metinoxy/VTOL/Images/Print Orientations/Wing_L_P1.png

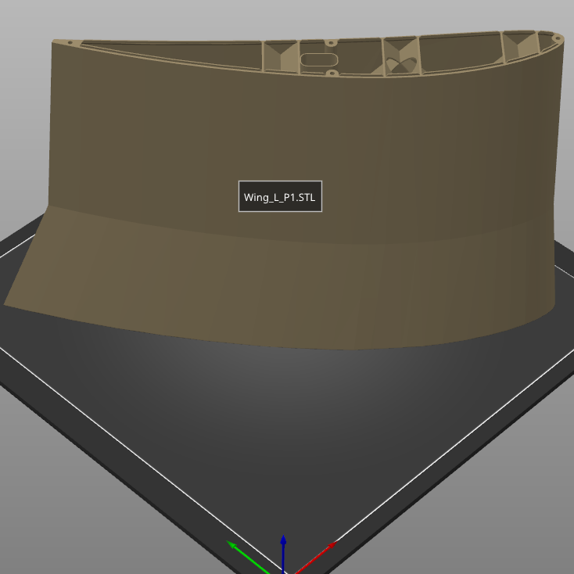
Images/Print Orientations/Wing_L_P1.png
