metinoxy/VTOL/Images/Electronics/FlightController.png

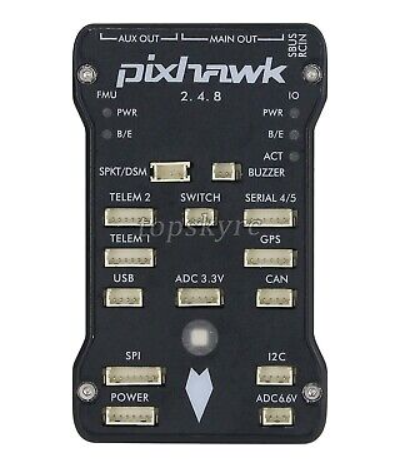
Images/Electronics/FlightController.png
