metinoxy/VTOL/Course Materials/Gantt Chard_Design.xlsx

VTOL Aircraft
Designing a vertical take-off and landing aircraft process |  |  | Period Highlight: |  | 15 |  | Plan Duration |  |  | Actual Start |  |  | % Complete |  |  | Actual |  | % Complete (beyondplan)
ACTIVITIES | PLAN START | PLAN DURATION | ACTUAL START | ACTUAL DURATION | PERCENT COMPLETE | PERIODS
 |  |  |  |  |  | 1 | 2 | 3 | 4 | 5 | 6 | 7 | 8 | 9 | 10 | 11 | 12 | 13 | 14 | 15
Market and Literature Reasearch | 1 | 4 | 1 | 4 | 100%
Problem definition and Functional Requirements | 4 | 2 | 4 | 2 | 100%
Conceptual Design Research | 5 | 1 | 5 | 1 | 100%
Airfoil Selection | 6 | 1 | 6 | 2 | 100%
Concept Evaluation and Selection | 6 | 1 | 6 | 1 | 100%
Wing Design and Lift Analysis | 7 | 2 | 7 | 2 | 100%
Tail Design and Stability Analysis | 8 | 1 | 8 | 1 | 100%
Rough Fuselage Design and CFD Analysis for Drag | 9 | 3 | 9 | 3 | 100%
Motor and Propeller Selection | 10 | 2 | 10 | 3 | 100%
Designation of Motor Positions | 11 | 1 | 11 | 1 | 100%
Wing Stress Analysis | 11 | 2 | 11 | 2 | 100%
Tilt Mechanism Design | 12 | 1 | 12 | 2 | 100%
Material Selection | 13 | 1 | 13 | 1 | 100%
Detailed Design | 13 | 3 | 13 | 3 | 100%
