metinoxy/VTOL/Course Materials/Images/Concept1.png

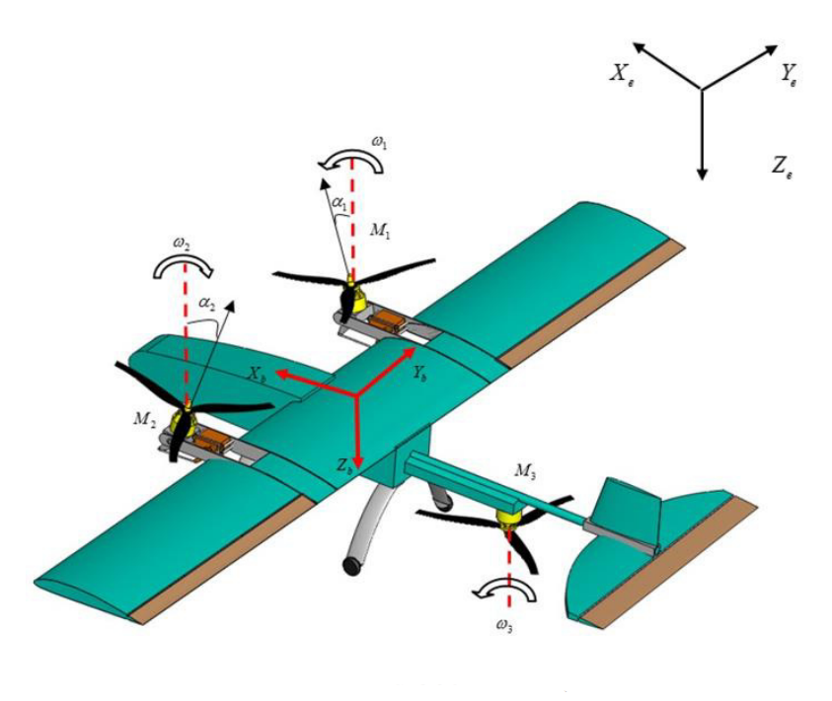
Course Materials/Images/Concept1.png
