metinoxy/VTOL/Course Materials/Images/Concept2.png

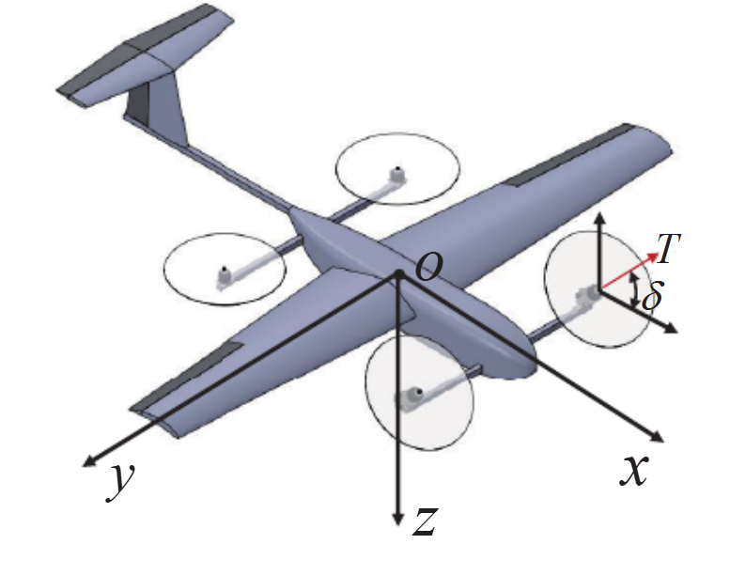
Course Materials/Images/Concept2.png
