metinoxy/VTOL/Course Materials/Images/Concept3.png

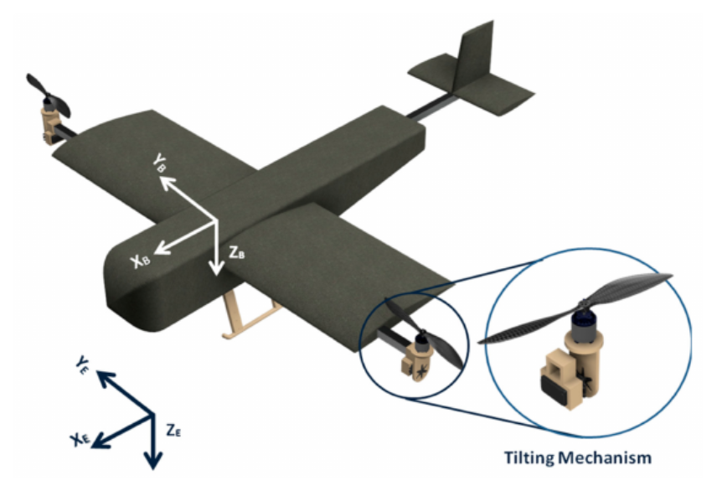
Course Materials/Images/Concept3.png
