metinoxy/VTOL/Course Materials/Images/Design_Path.png

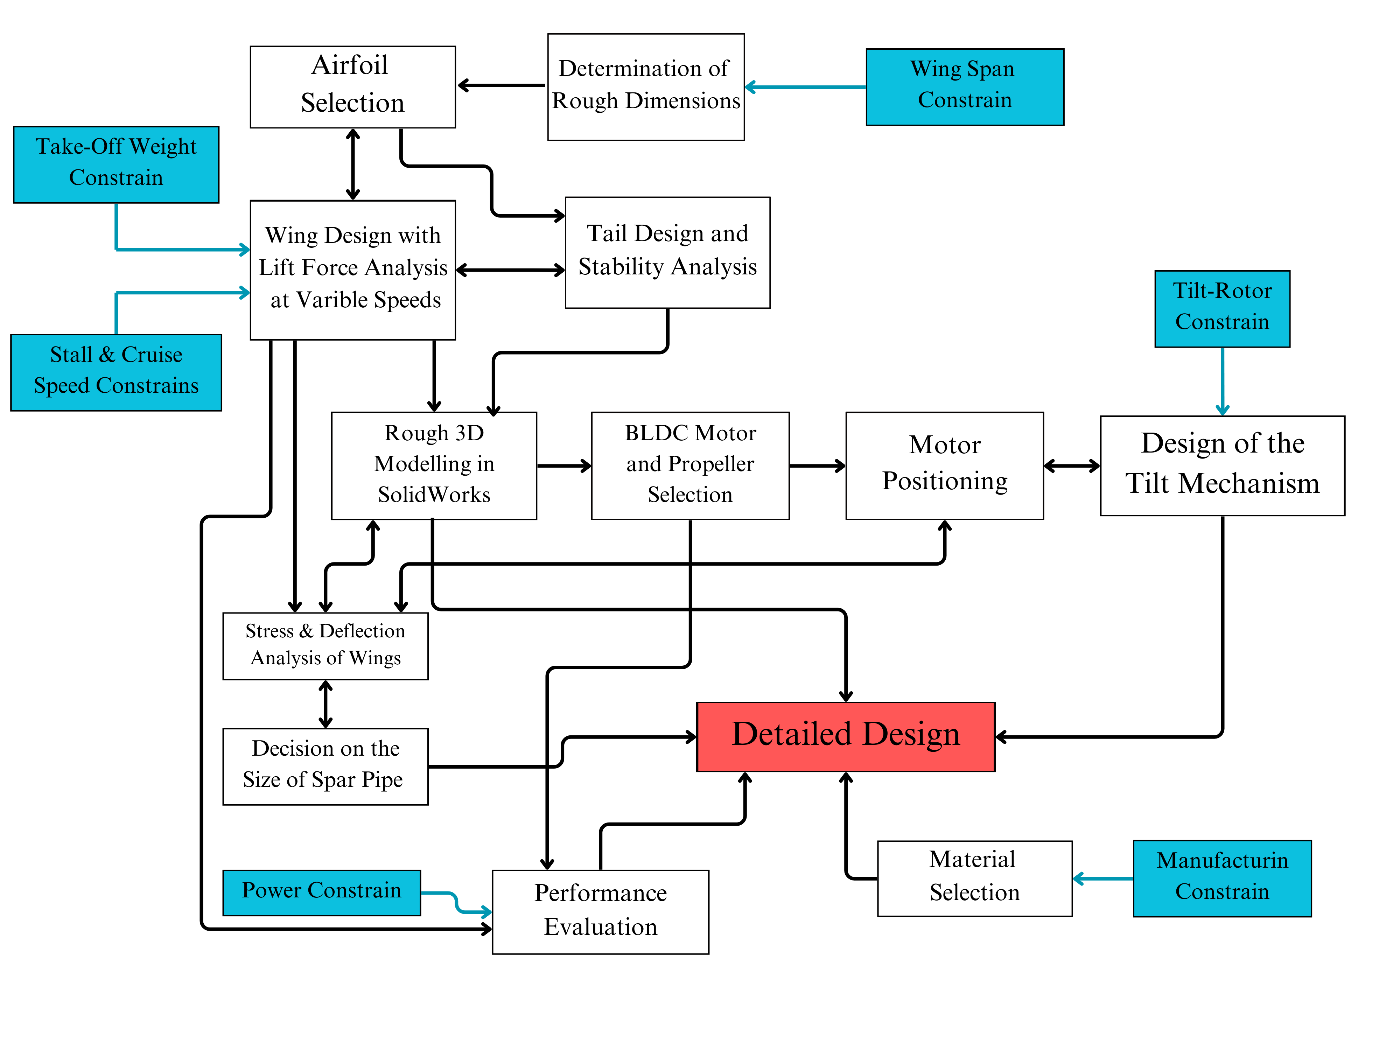
Course Materials/Images/Design_Path.png
