metinoxy/VTOL/Course Materials/Images/ProductDesignSpecifications.png

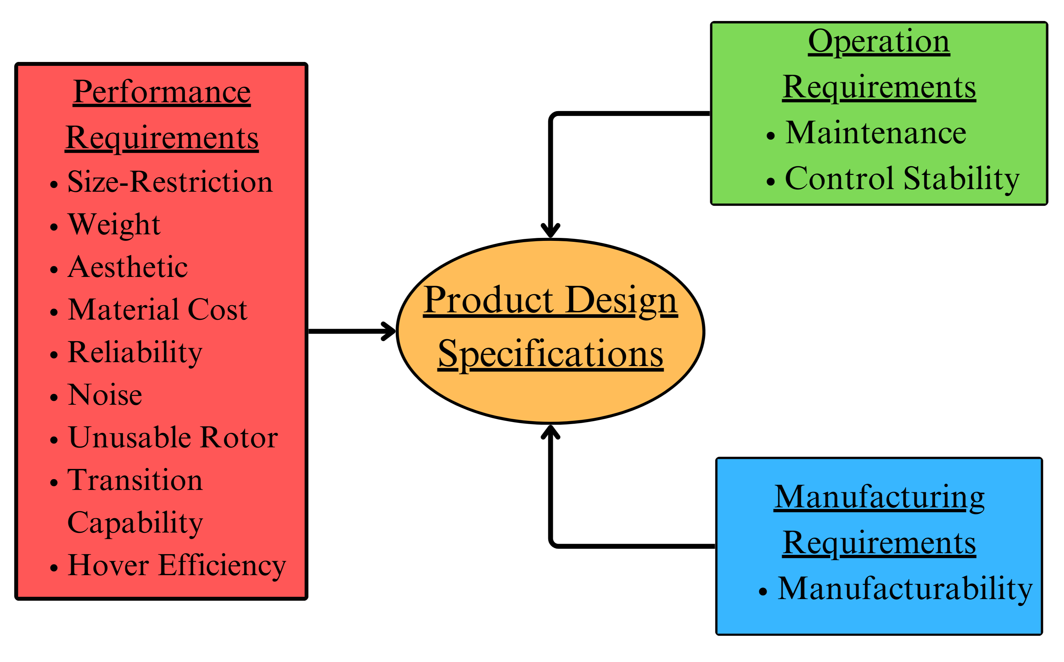
Course Materials/Images/ProductDesignSpecifications.png
