metinoxy/VTOL/Images/clcdVa_cdVa.png

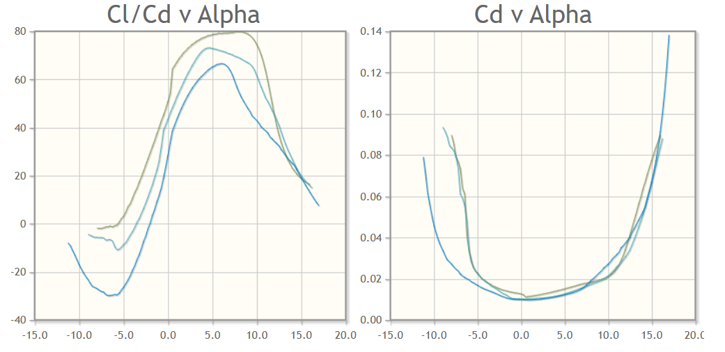
Images/clcdVa_cdVa.png
