metinoxy/VTOL/Images/clVcd_cl_a.png

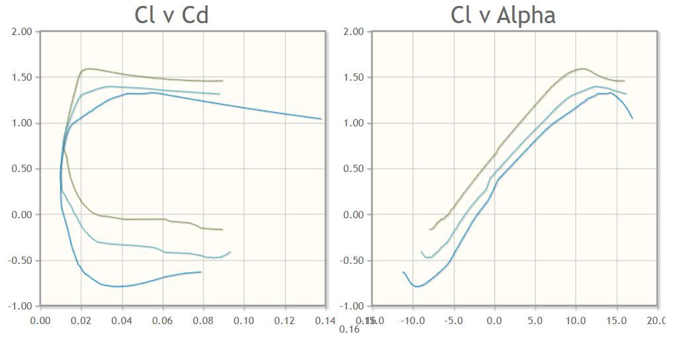
Images/clVcd_cl_a.png
