metinoxy/VTOL/Images/cmVa.png

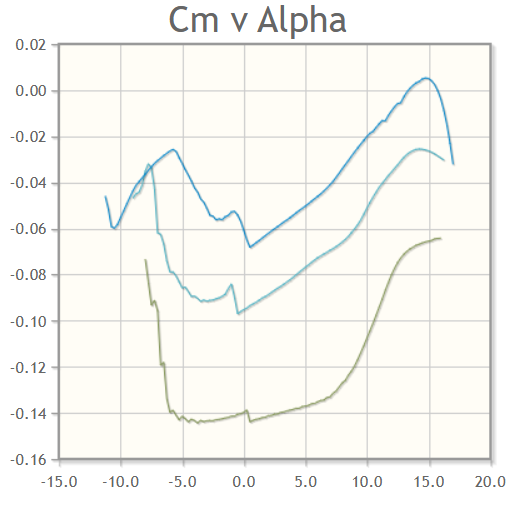
Images/cmVa.png
