metinoxy/VTOL/Images/Electronics/5V_BEC.png

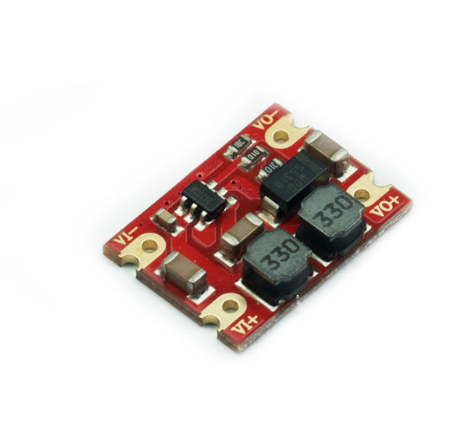
Images/Electronics/5V_BEC.png
