metinoxy/VTOL/Images/Electronics/60A_ESC.png

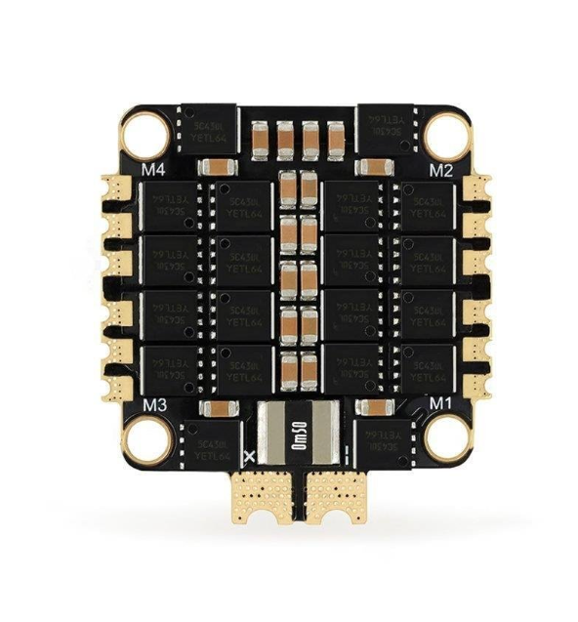
Images/Electronics/60A_ESC.png
