metinoxy/VTOL/Images/Electronics/AirspeedSensor.png

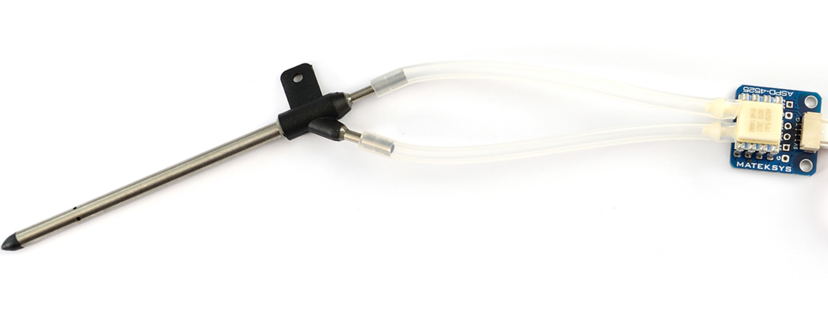
Images/Electronics/AirspeedSensor.png
