metinoxy/VTOL/Images/Electronics/BLDC_RS2205.png

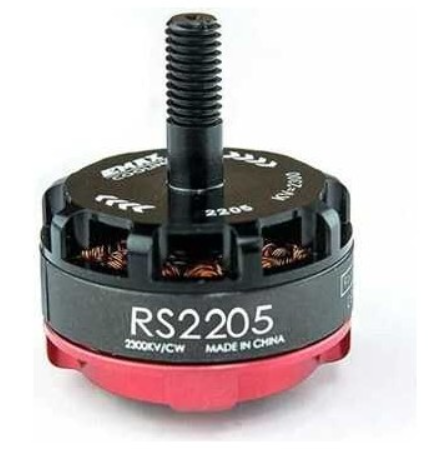
Images/Electronics/BLDC_RS2205.png
