metinoxy/VTOL/Images/Electronics/Buzzer.png

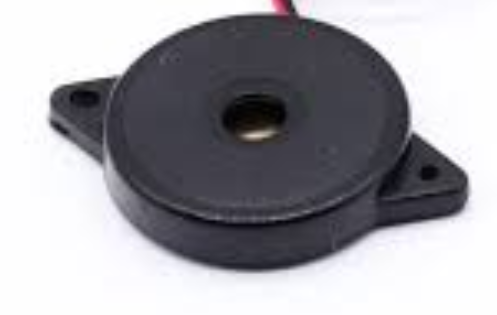
Images/Electronics/Buzzer.png
