metinoxy/VTOL/Images/Electronics/ES09MD_Servo.png

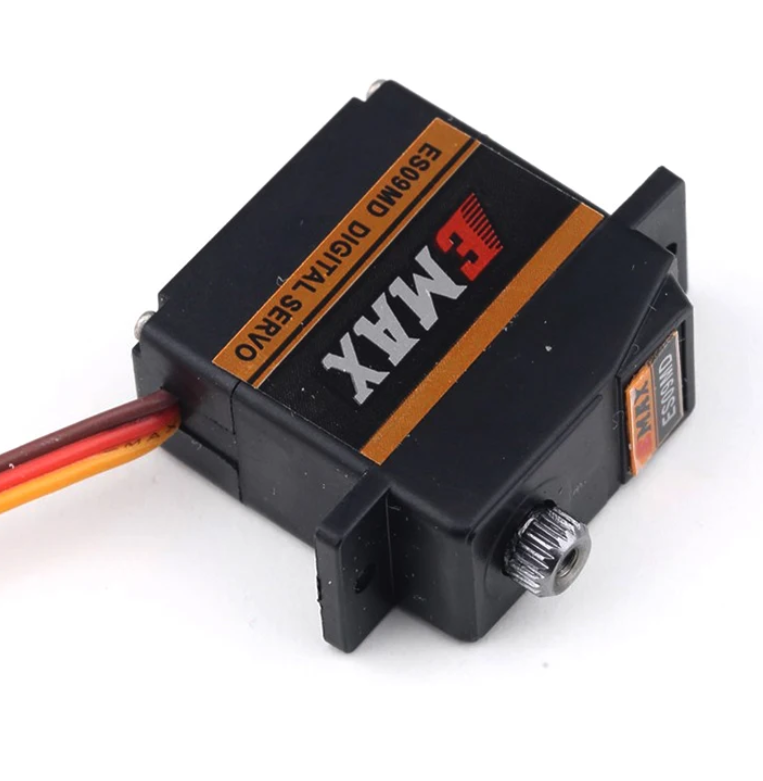
Images/Electronics/ES09MD_Servo.png
