metinoxy/VTOL/Images/Electronics/LİPO.png

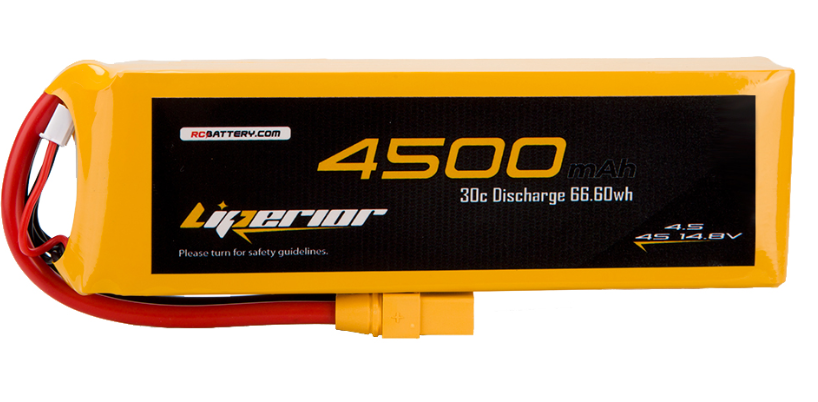
Images/Electronics/LİPO.png
