metinoxy/VTOL/Images/Electronics/M8N_GPS.png

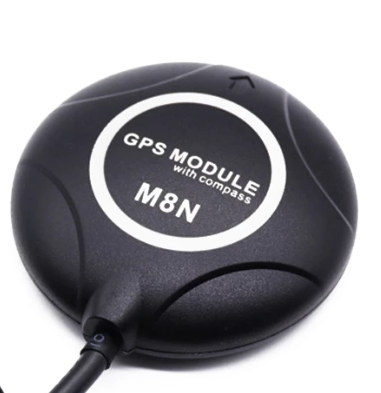
Images/Electronics/M8N_GPS.png
