metinoxy/VTOL/Images/Electronics/MG90S_Servo.png

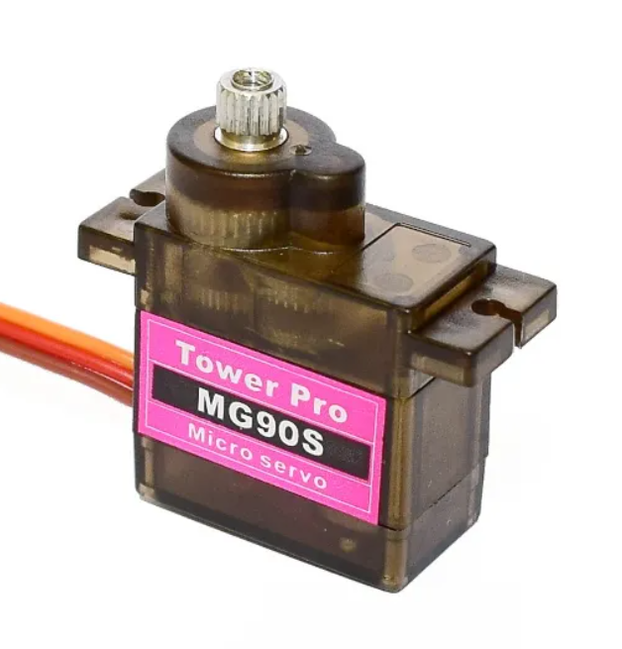
Images/Electronics/MG90S_Servo.png
