metinoxy/VTOL/Images/Electronics/PowerModule.png

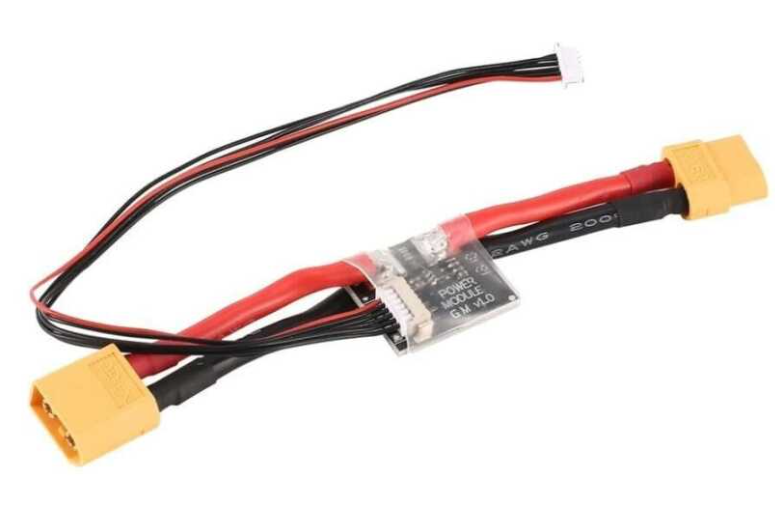
Images/Electronics/PowerModule.png
