metinoxy/VTOL/Images/Electronics/Receiver.png

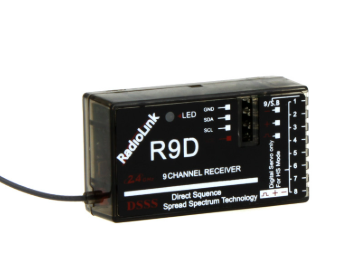
Images/Electronics/Receiver.png
