metinoxy/VTOL/Images/Electronics/SafetySwitch.png

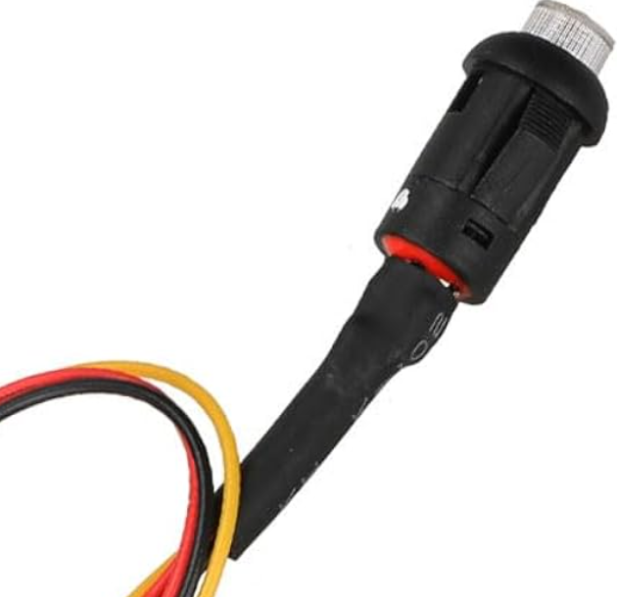
Images/Electronics/SafetySwitch.png
