metinoxy/VTOL/Images/Electronics/Telemetry.png

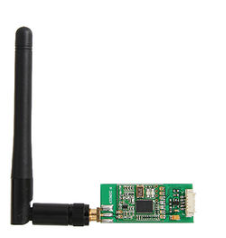
Images/Electronics/Telemetry.png
