metinoxy/VTOL/Images/Ender3-S1.png

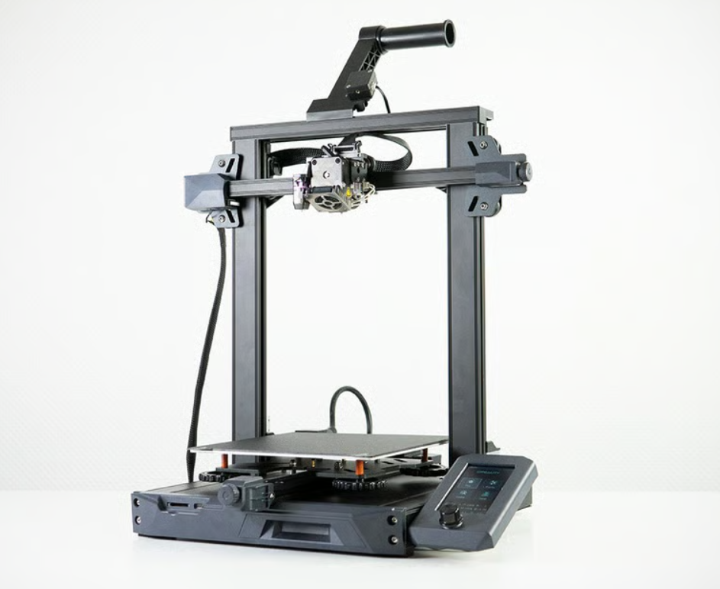
Images/Ender3-S1.png
