metinoxy/VTOL/Images/FFF-1-00000.png

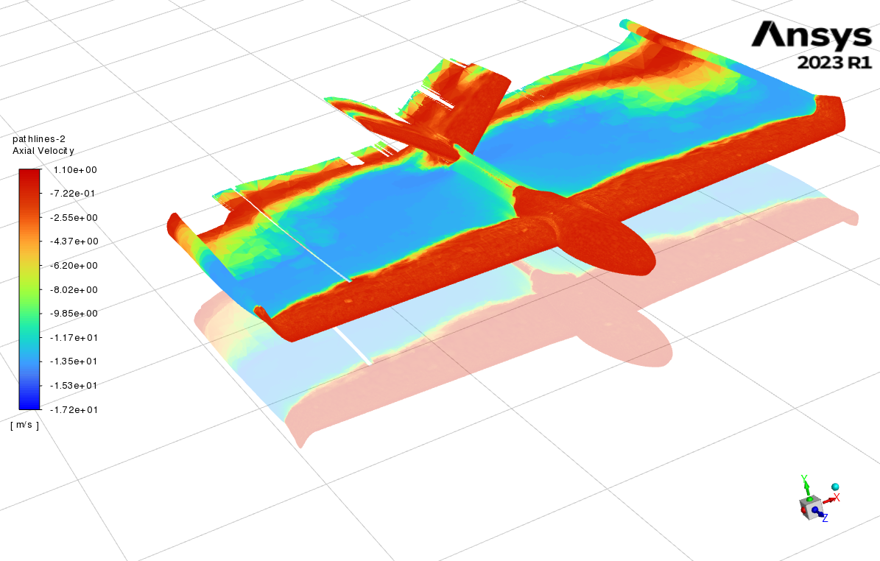
Images/FFF-1-00000.png
