metinoxy/VTOL/Images/FoS_Horizontal.png

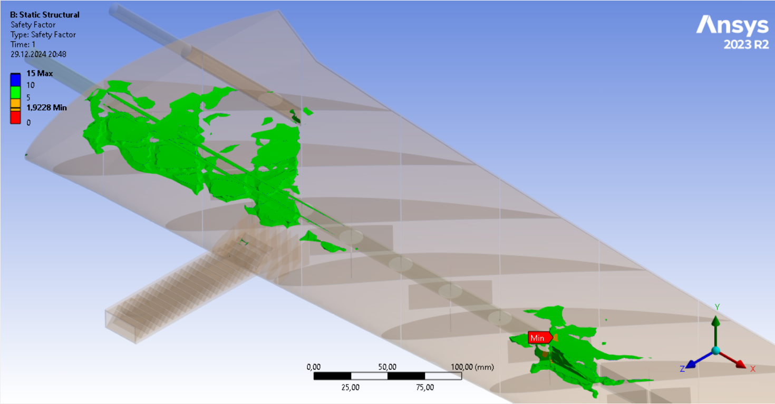
Images/FoS_Horizontal.png
