metinoxy/VTOL/Images/FoS_Vertical.png

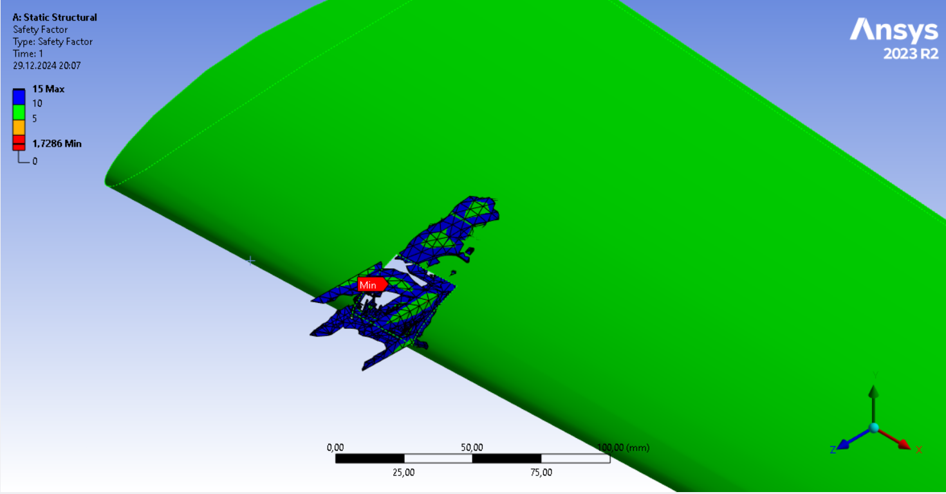
Images/FoS_Vertical.png
