metinoxy/VTOL/Images/Front.png

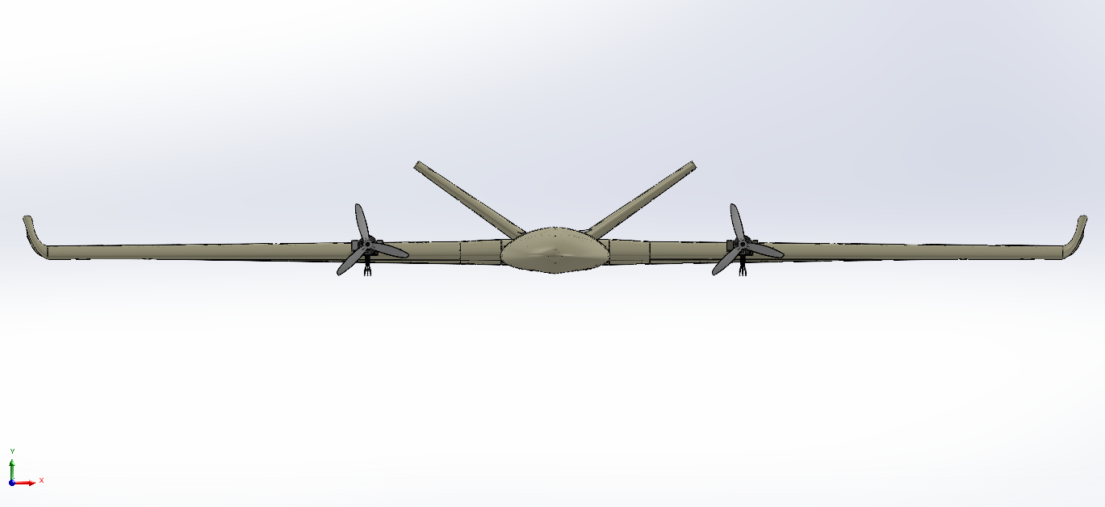
Images/Front.png
