metinoxy/VTOL/Images/izometric1.png

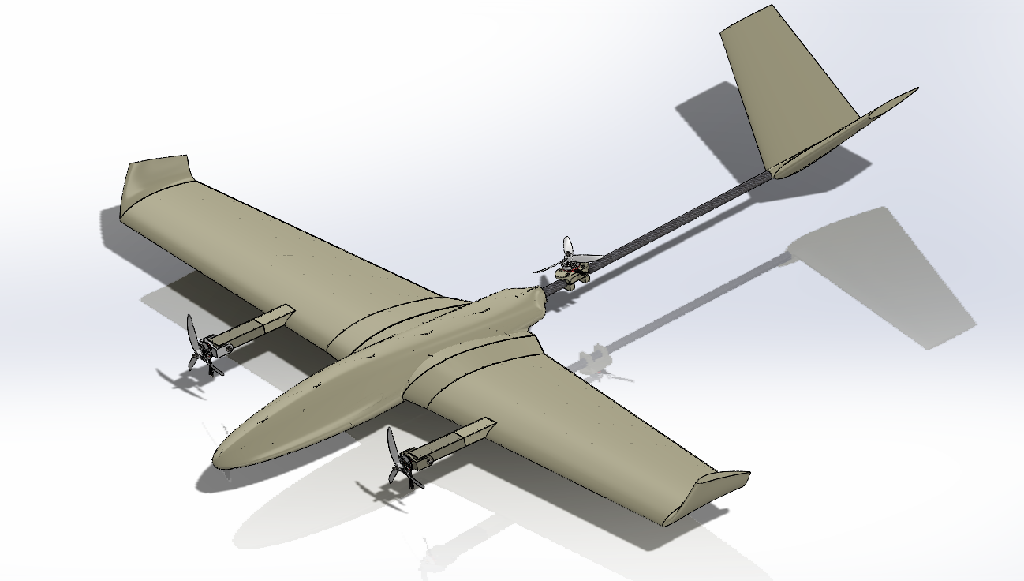
Images/izometric1.png
