metinoxy/VTOL/Images/Izometric.png

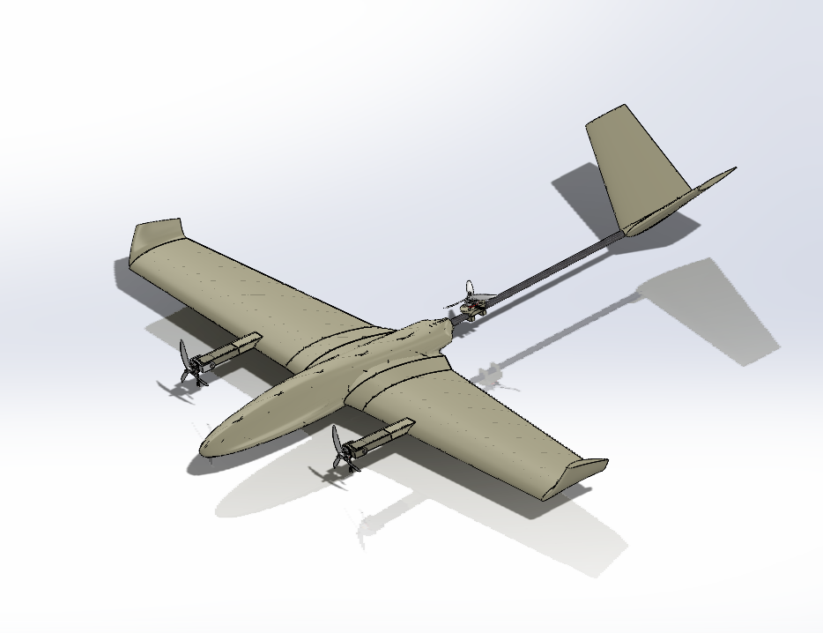
Images/Izometric.png
