metinoxy/VTOL/Images/MP_FullParameterList.png

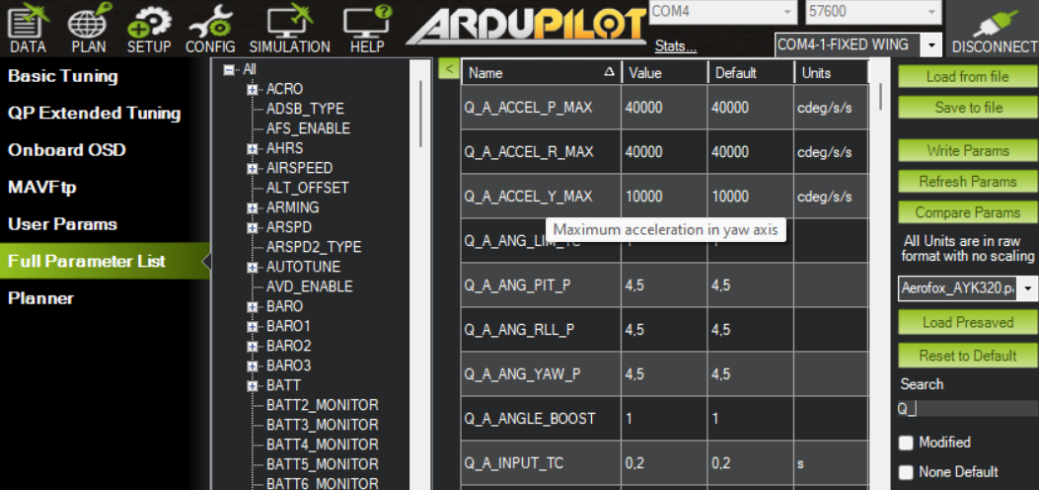
Images/MP_FullParameterList.png
