metinoxy/VTOL/Images/MP_ServoOutput.png

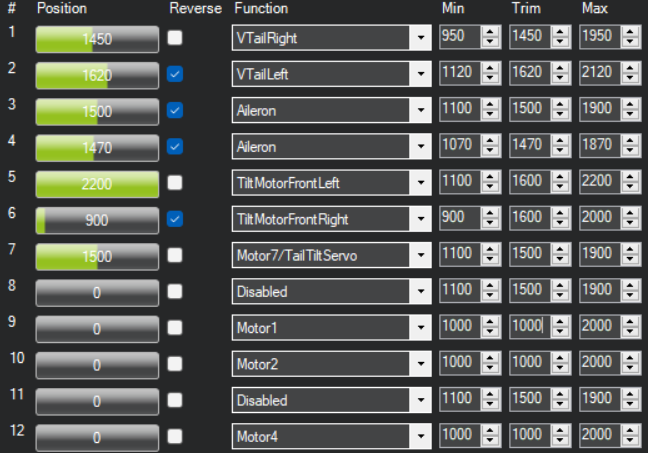
Images/MP_ServoOutput.png
