metinoxy/VTOL/Images/PrushaSlicer.png

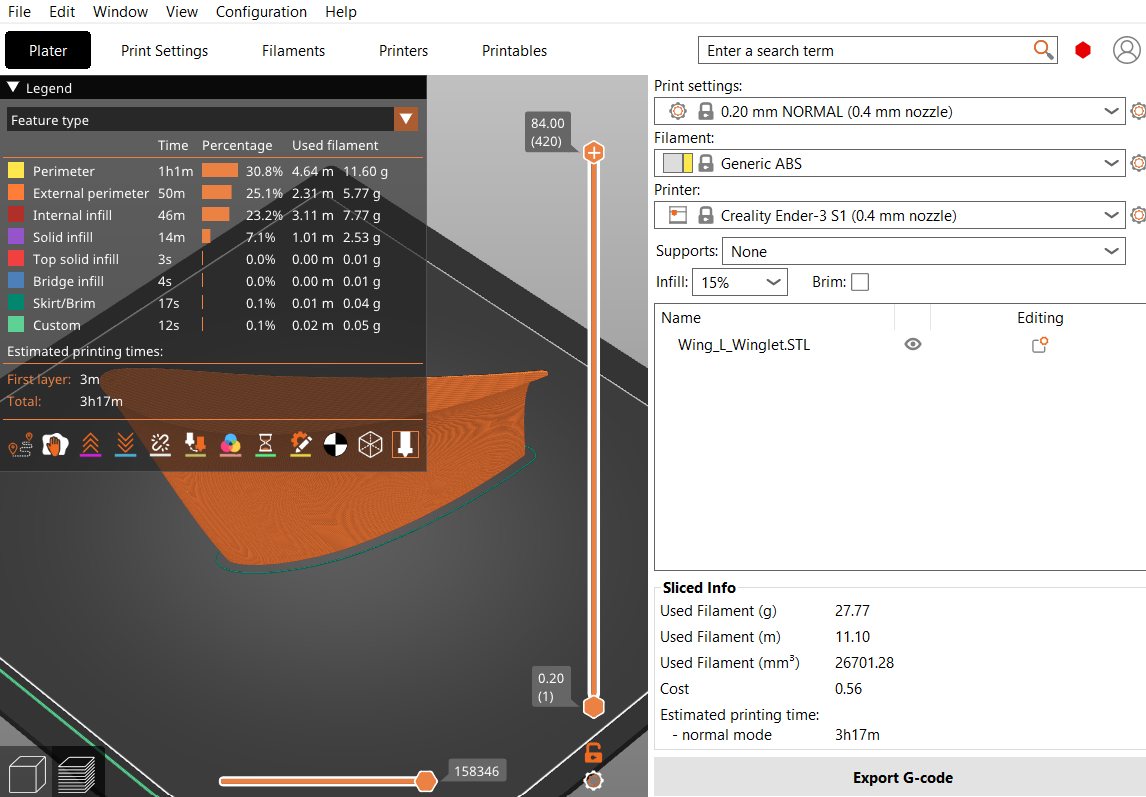
Images/PrushaSlicer.png
