metinoxy/VTOL/Images/servo_cap.JPG

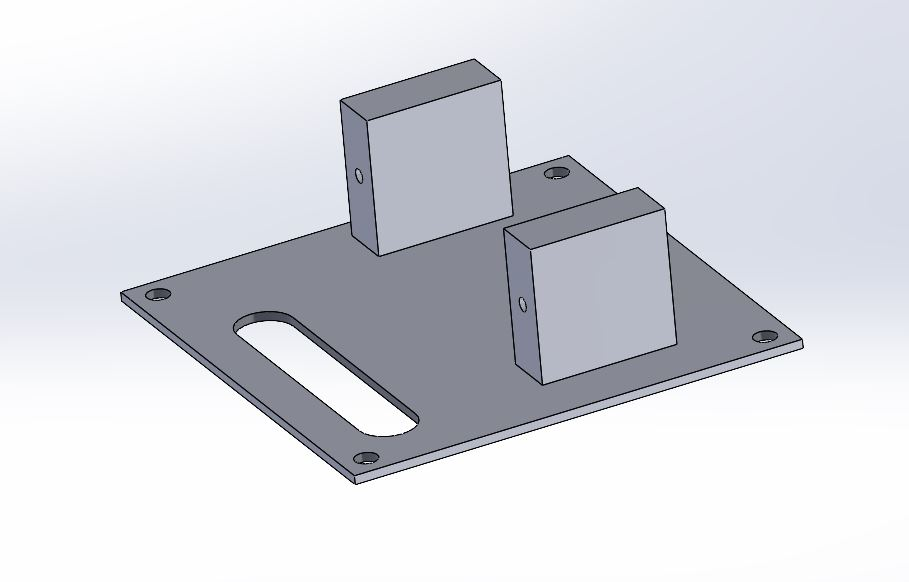
Images/servo_cap.JPG
