metinoxy/VTOL/Images/SnapJoint&Alignment.png

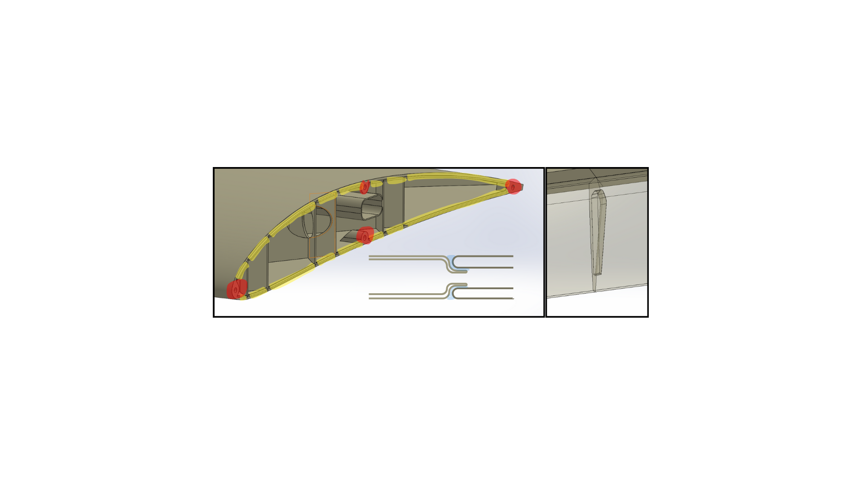
Images/SnapJoint&Alignment.png
