metinoxy/VTOL/Images/SnapJoint&AlignmentHoles.png

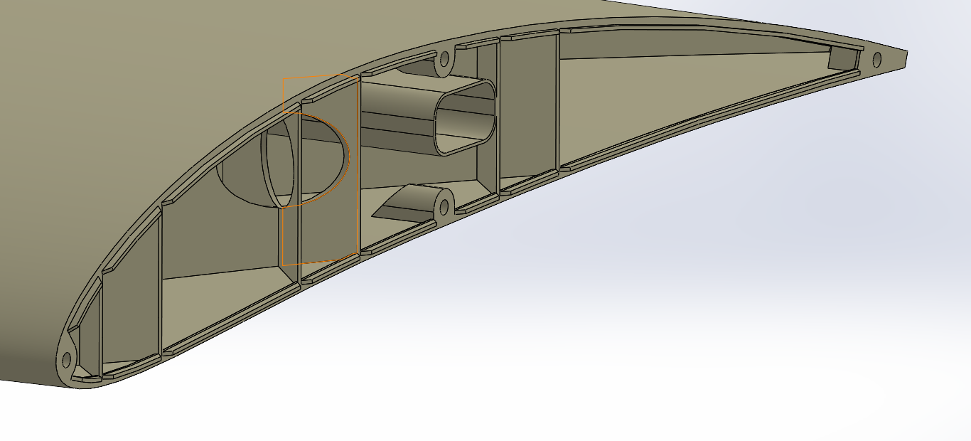
Images/SnapJoint&AlignmentHoles.png
