metinoxy/VTOL/Images/SnapJointAileron.png

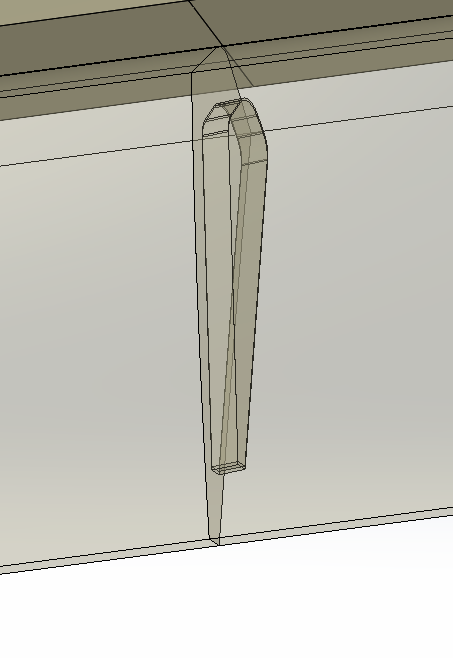
Images/SnapJointAileron.png
