metinoxy/VTOL/Images/tail_pin_holes.JPG

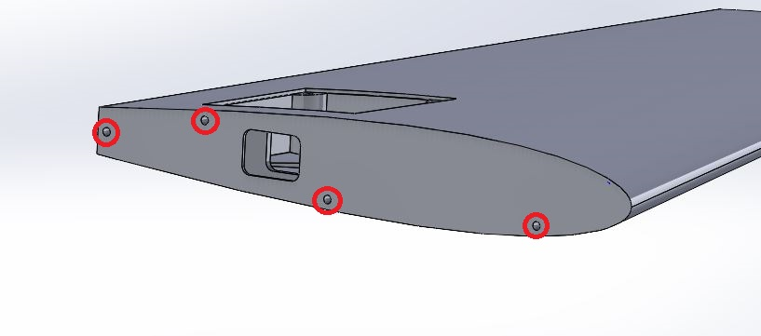
Images/tail_pin_holes.JPG
