metinoxy/VTOL/Images/Tilt_mechanism_exploded.JPG

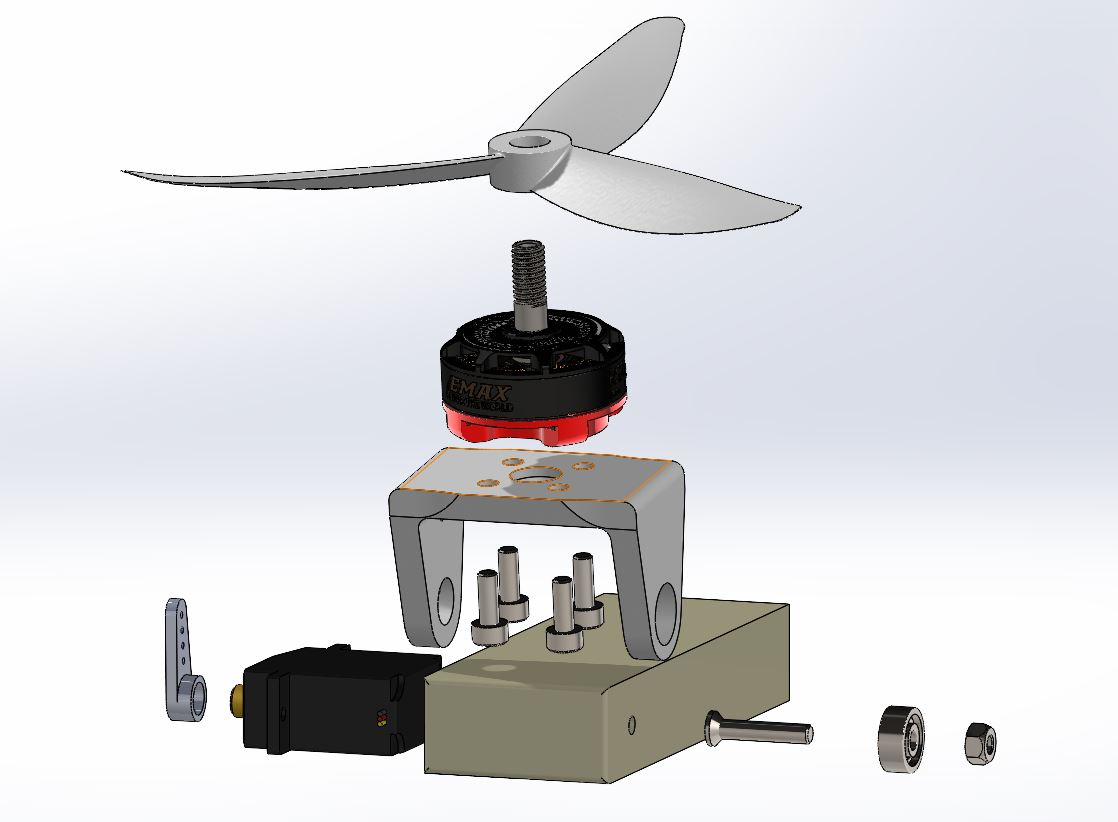
Images/Tilt_mechanism_exploded.JPG
