metinoxy/VTOL/Images/Upward.png

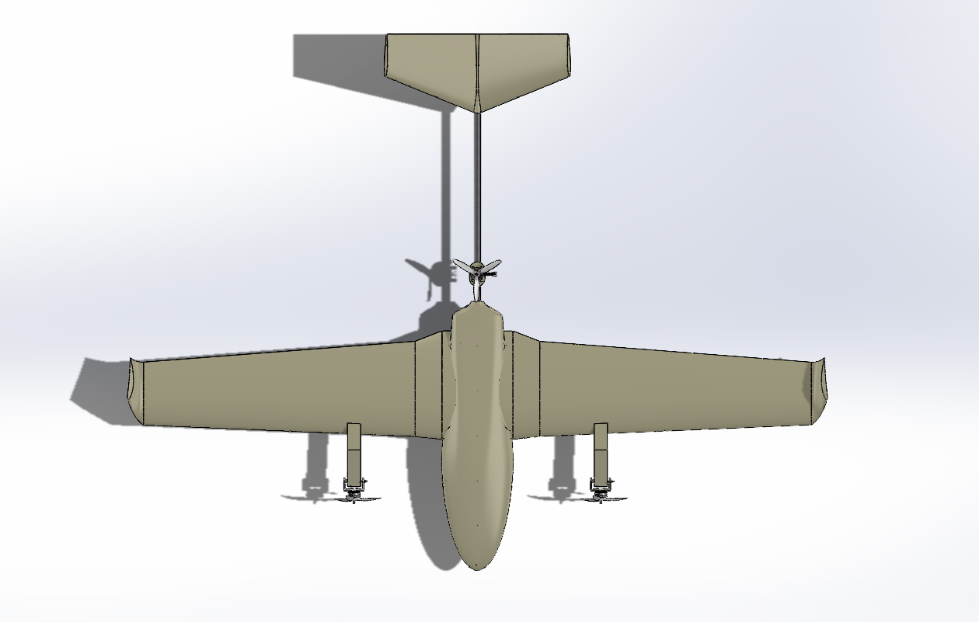
Images/Upward.png
