metinoxy/VTOL/Images/WingP1_Slicer.png

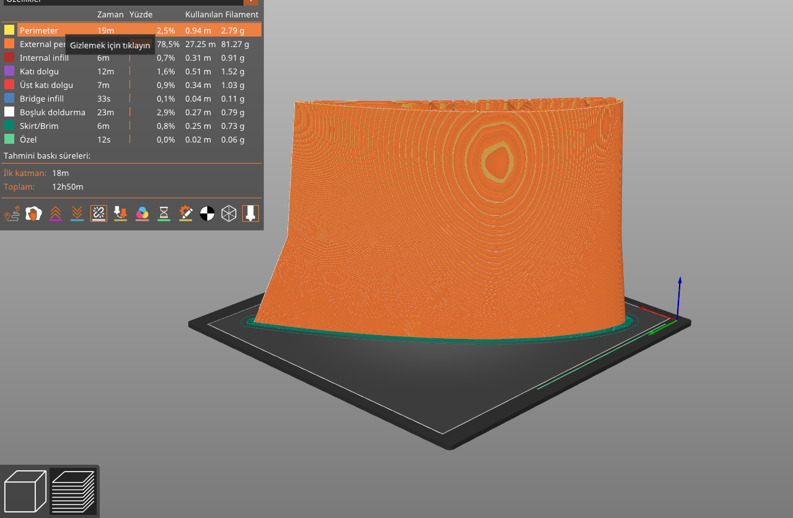
Images/WingP1_Slicer.png
