metinoxy/VTOL/Images/WingServoMount.png

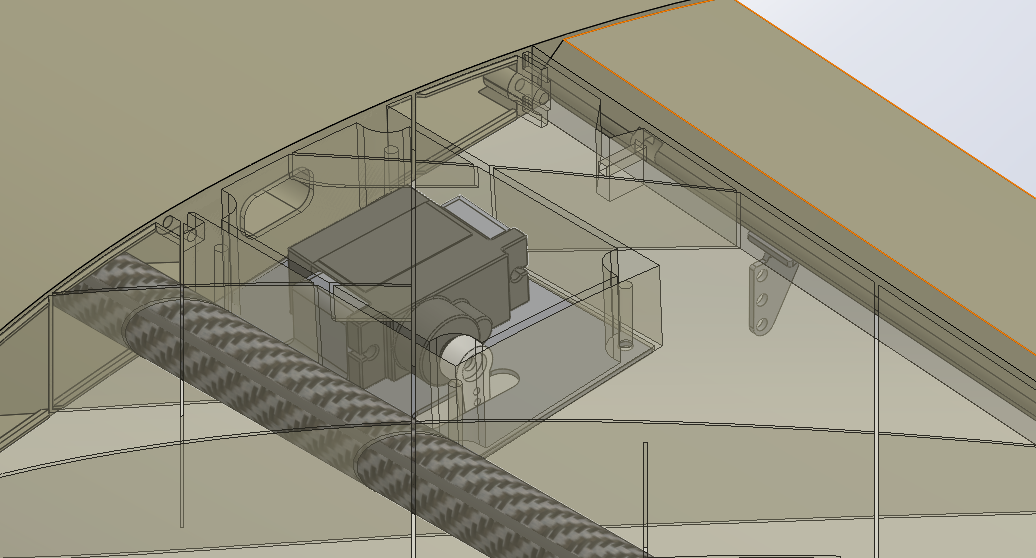
Images/WingServoMount.png
