metinoxy/VTOL/MATLAB/Numerical_Bending.jpg

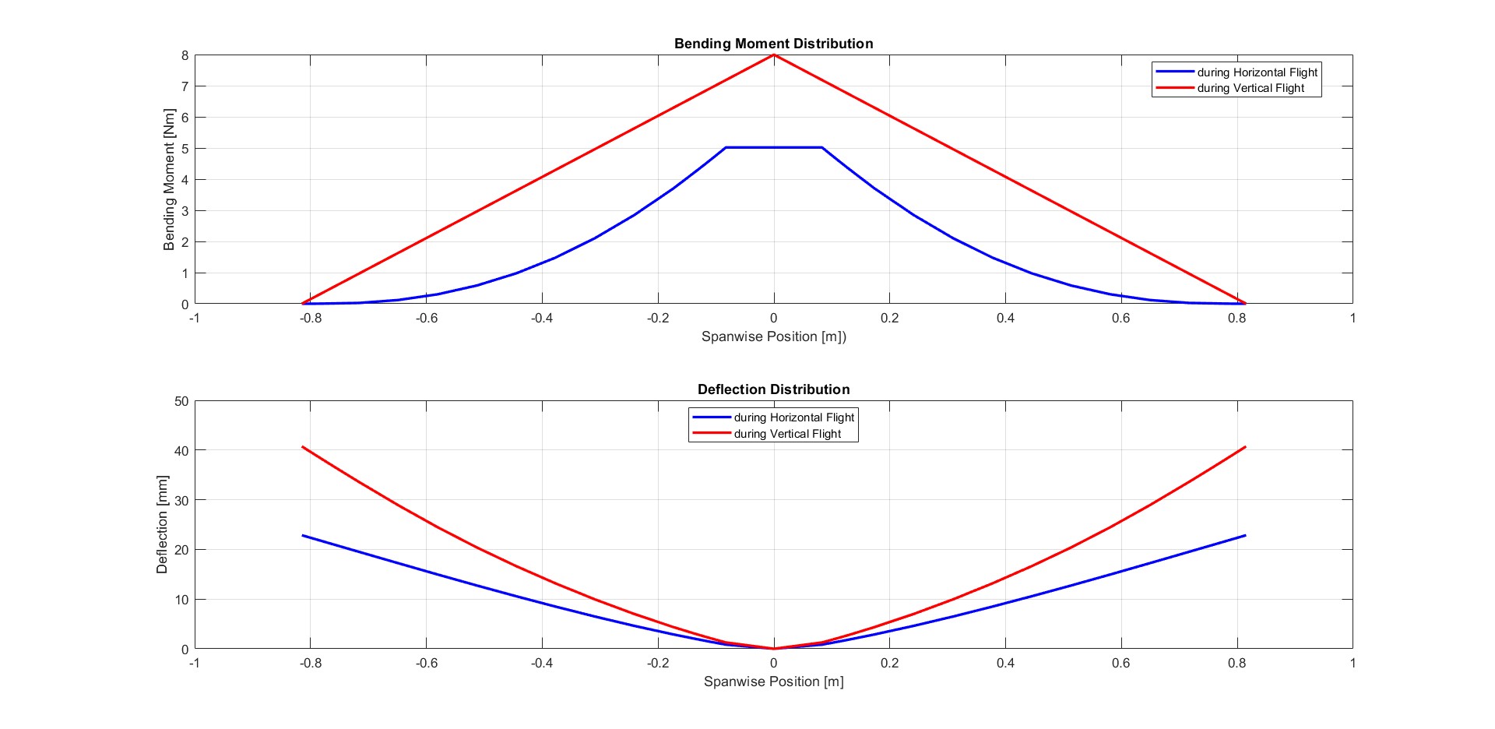
MATLAB/Numerical_Bending.jpg
