metinoxy/VTOL/Production Images/WhatsApp Görsel 2025-03-21 saat 00.48.26_49d39781.jpg

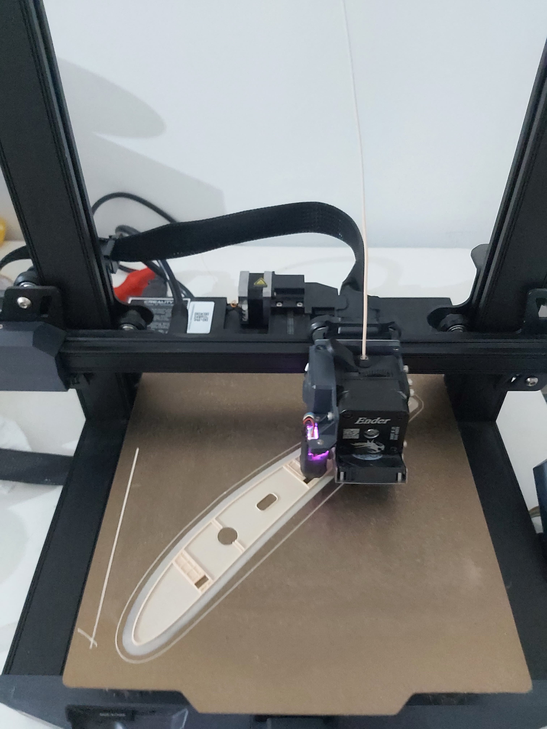
Production Images/WhatsApp Görsel 2025-03-21 saat 00.48.26_49d39781.jpg
