metinoxy/VTOL/Production Images/WhatsApp Görsel 2025-03-21 saat 00.48.27_048fbbfe.jpg

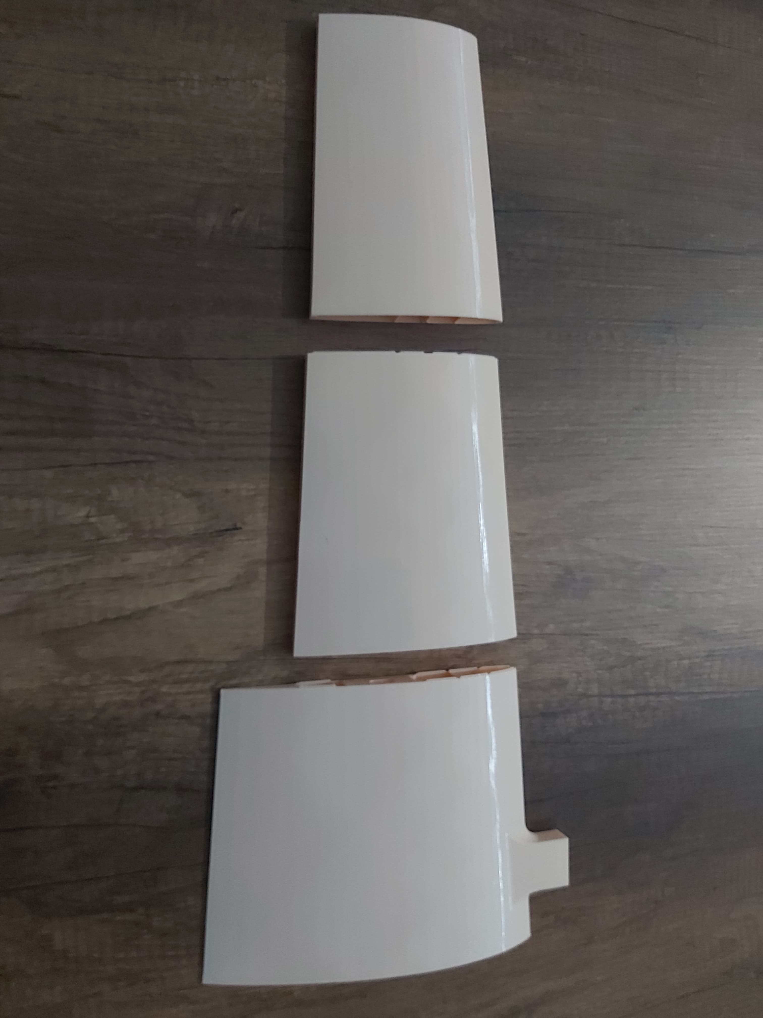
Production Images/WhatsApp Görsel 2025-03-21 saat 00.48.27_048fbbfe.jpg
