metinoxy/VTOL/Production Images/WhatsApp Görsel 2025-03-22 saat 12.00.09_72ee4169.jpg

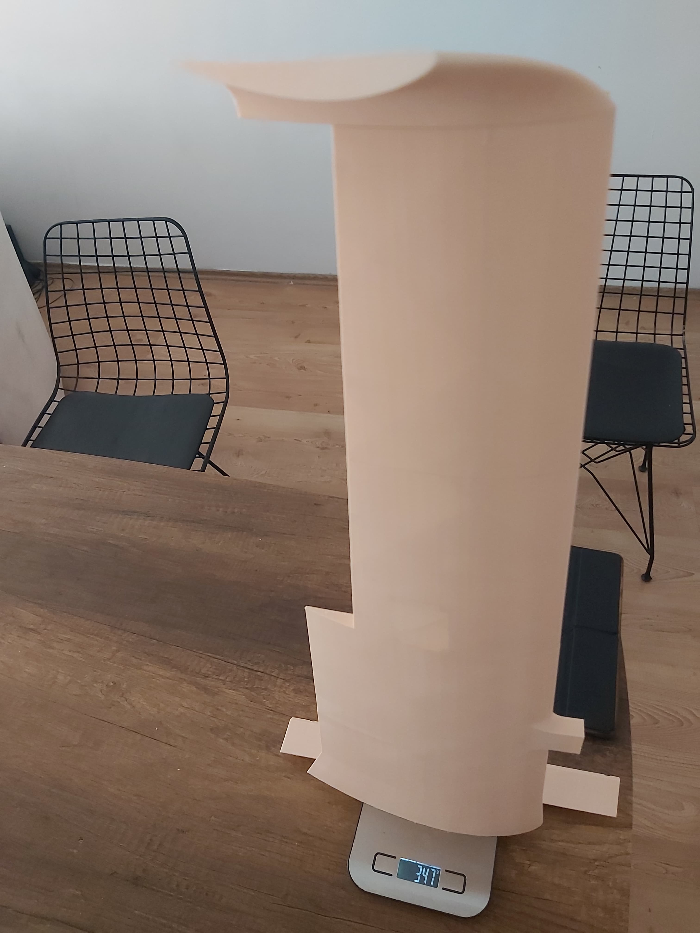
Production Images/WhatsApp Görsel 2025-03-22 saat 12.00.09_72ee4169.jpg
