metinoxy/VTOL/Production Images/WhatsApp Görsel 2025-03-22 saat 12.05.00_8dc8c9ad.jpg

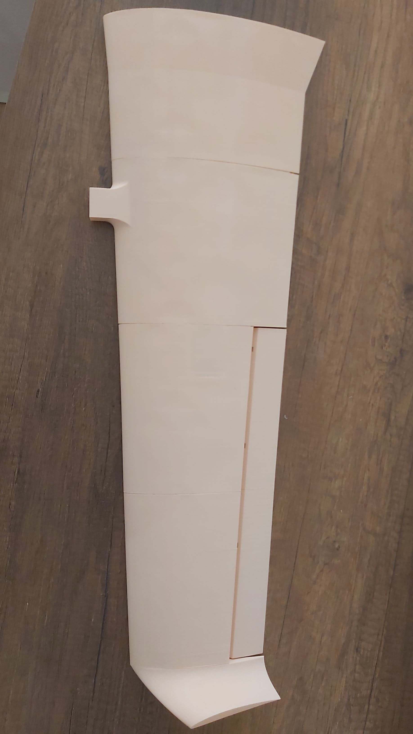
Production Images/WhatsApp Görsel 2025-03-22 saat 12.05.00_8dc8c9ad.jpg
