metinoxy/VTOL/SolidWorks/Technical Drawings/TiltMechanism_v1.JPG

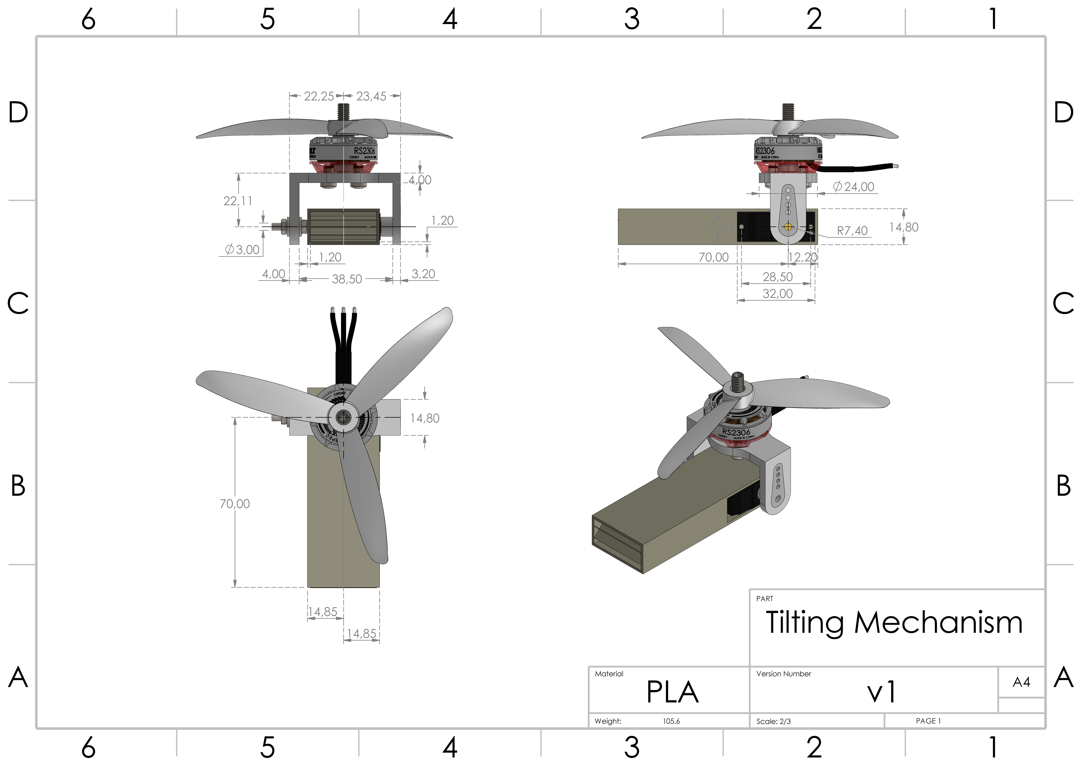
SolidWorks/Technical Drawings/TiltMechanism_v1.JPG
