metinoxy/VTOL/SolidWorks/Technical Drawings/V-Tail_v2.JPG

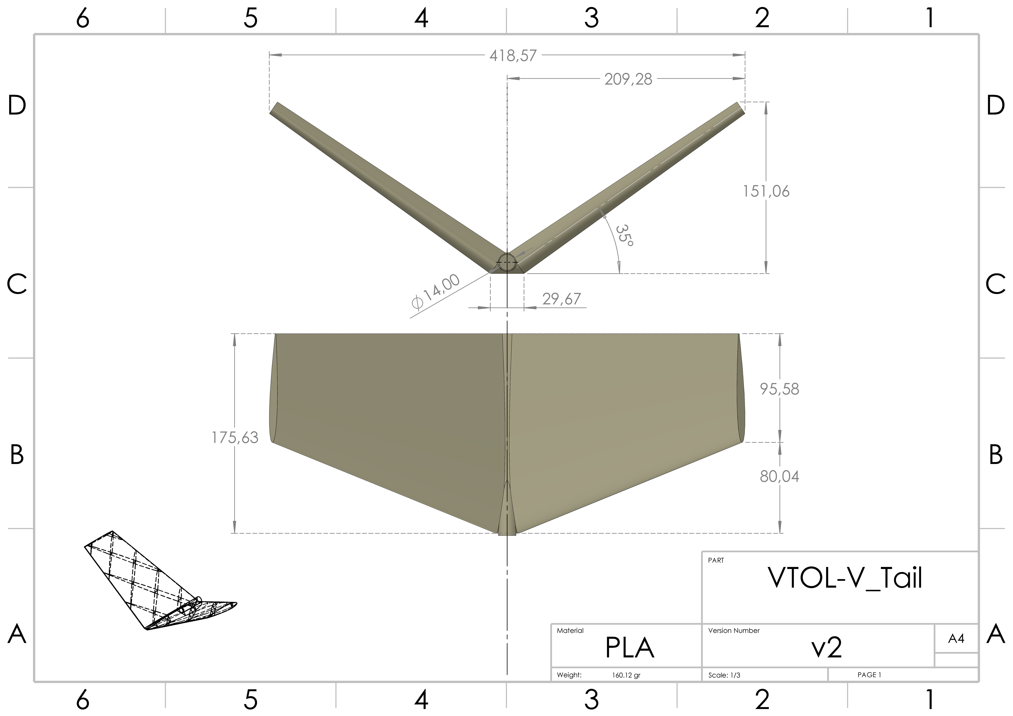
SolidWorks/Technical Drawings/V-Tail_v2.JPG
