metinoxy/VTOL/SolidWorks/Technical Drawings/Wing_v1.JPG

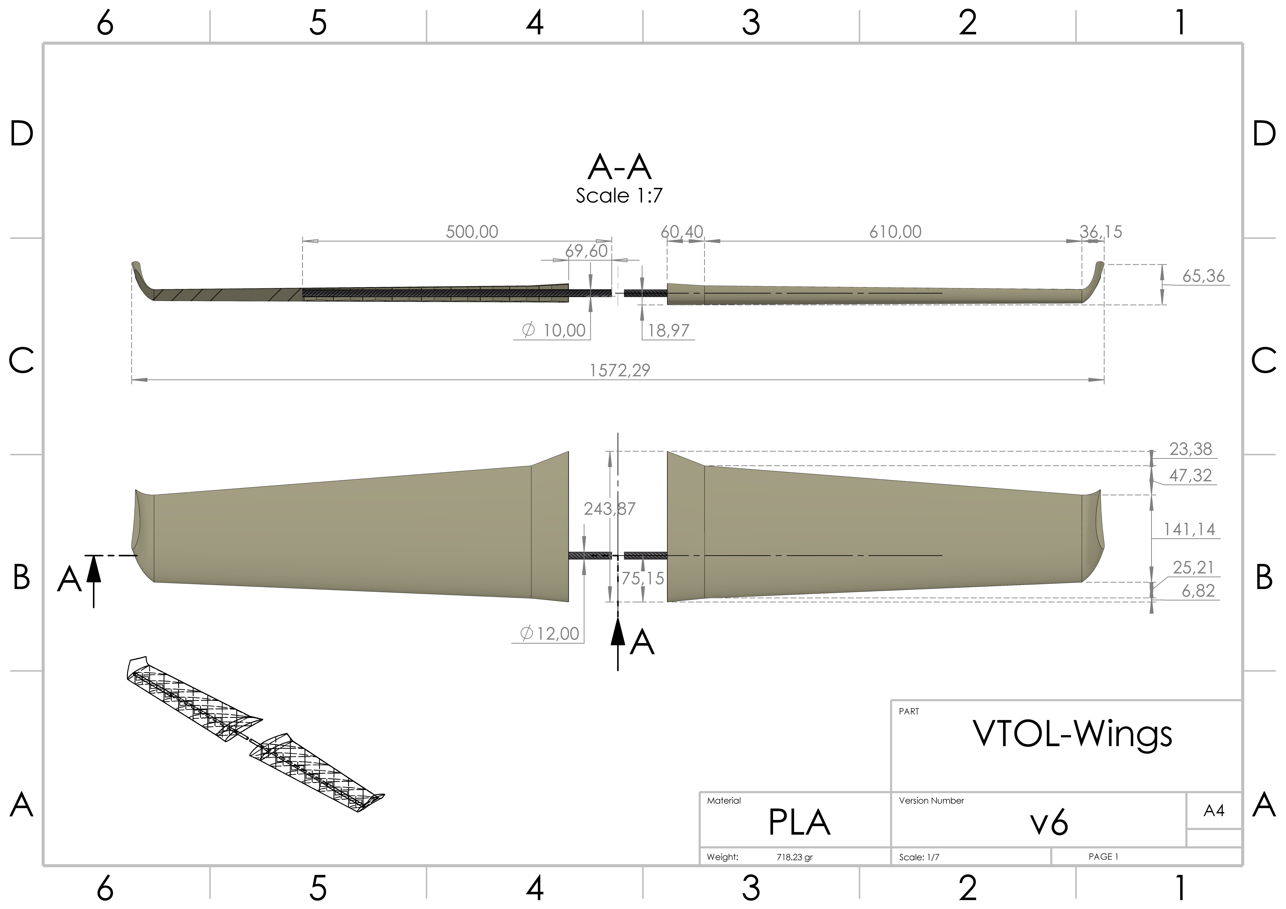
SolidWorks/Technical Drawings/Wing_v1.JPG
