metinoxy/VTOL/SolidWorks/Technical Drawings/Wing_v2.JPG

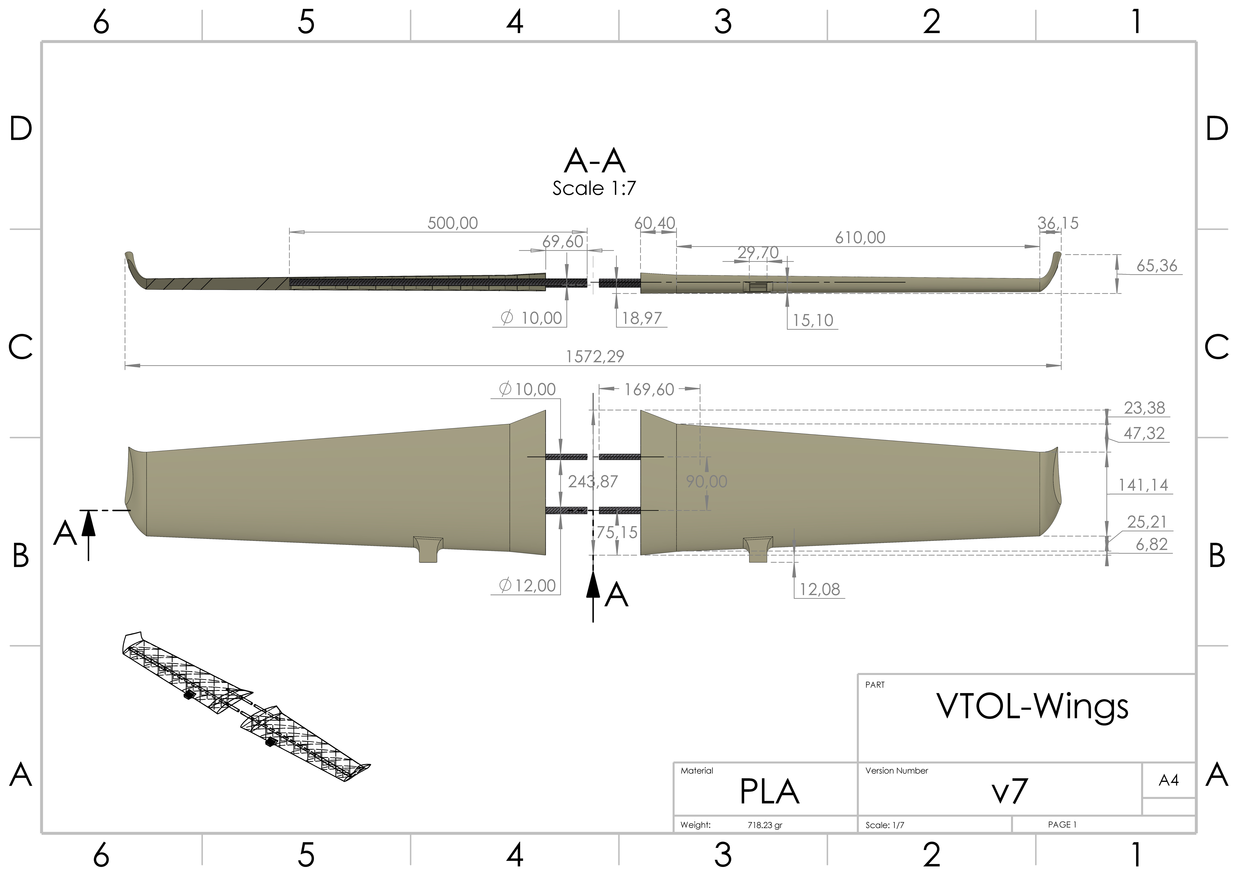
SolidWorks/Technical Drawings/Wing_v2.JPG
