metinoxy/VTOL/Usable Docs/stallion vtol.png

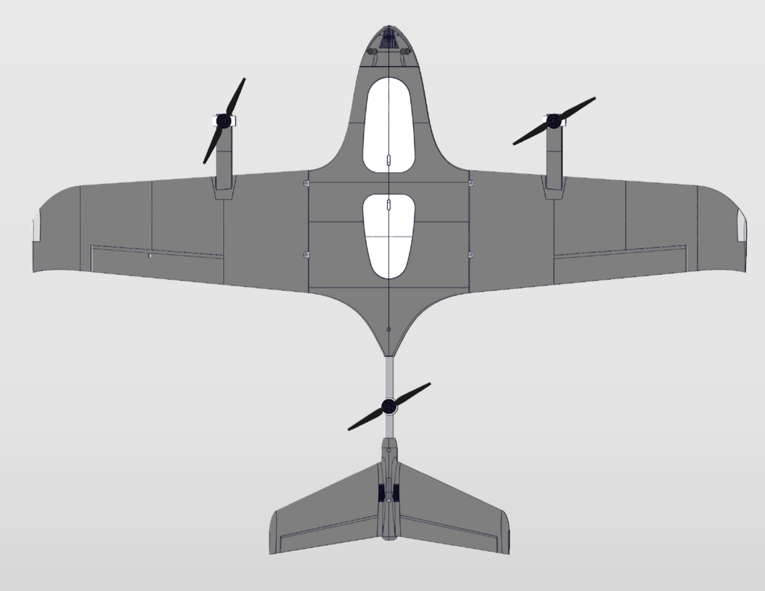
Usable Docs/stallion vtol.png
