metinoxy/VTOL/Course Materials/Cost Analysis.xlsx

Part | Pieces | Cost | Total Cost | Link
PLA Filament | 1 | ₺599.00 | ₺599.00 | https://market.samm.com/esun-pla-plus-kemik-rengi-filament-175mm-1kg
Wing Spar Pipe | 1 | ₺322.94 | ₺322.94 | https://www.kompozitshop.com/cam-fiber-boru-pro-disic-cap-12mm10mm
Tail Pipe | 1 | ₺337.62 | ₺337.62 | https://www.kompozitshop.com/cam-fiber-boru-pro-disic-cap-14mm12mm
Adhesive &Equipments | 1 | ₺500.00 | ₺500.00 | To be Taken Away
BLDC Motor | 3 | ₺0.00 | ₺0.00 | Available
ESC | 3 | ₺524.16 | ₺1572.48 | https://www.f1depo.com/urun/hskrc-45a-fircasiz-esc-blheli-s
Radio Controller | 1 | ₺0.00 | ₺0.00 | Available
Tilt Mechanism Servo | 2 | ₺643.97 | ₺1287.94 | https://www.ankarobot.com/emax-es09md-dijital-metal-disli-mikro-servo-motor-u1312
Control Surf. Servo | 5 | ₺106.50 | ₺532.50 | https://www.ankarobot.com/mg90s-90--180-derece-rc-micro-servo-motor-u1907
Pitot Tube | 1 | ₺2140.00 | ₺2140.00 | https://www.f1depo.com/urun/pixhawk-airspeed-sensoru-apm-pixhawk-pitot-tupu
Propeller | 3 | ₺54.42 | ₺163.26 | https://www.f1depo.com/urun/5045-seffaf-siyah-pervane-1-cw-1-ccw
Flight Controller | 1 | ₺6770.00 | ₺6770.00 | https://www.f1depo.com/urun/pixhawk-2-4-8-ucus-kontrol-karti-full-set-drone
Battery | 1 | ₺0.00 | ₺0.00 | To be Available
 |  | Total Cost: | ₺14225.74
