metinoxy/VTOL/Course Materials/gannt_chard_production.JPG

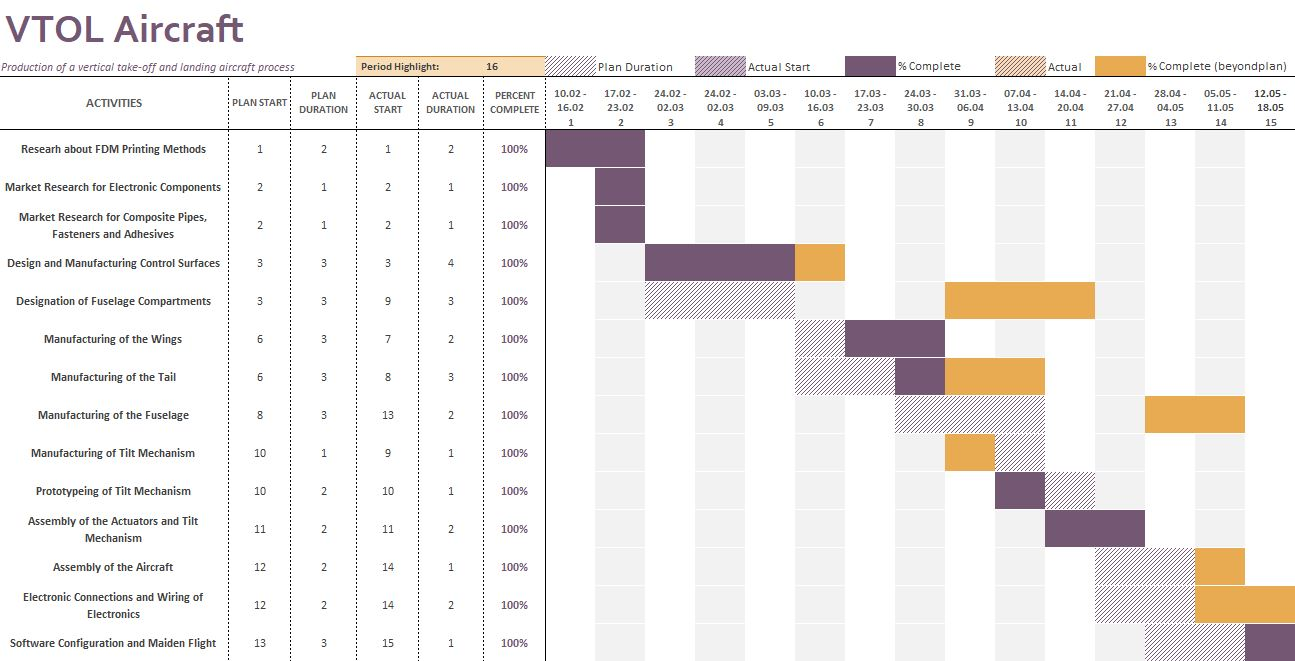
Course Materials/gannt_chard_production.JPG
