metinoxy/VTOL/Course Materials/Images/airfoils.png

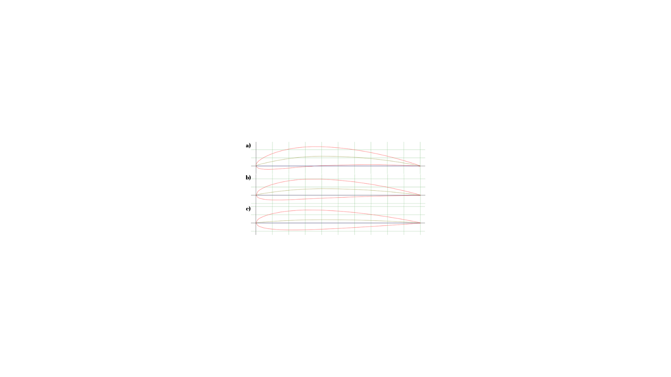
Course Materials/Images/airfoils.png
