metinoxy/VTOL/Course Materials/Images/cd_a.png

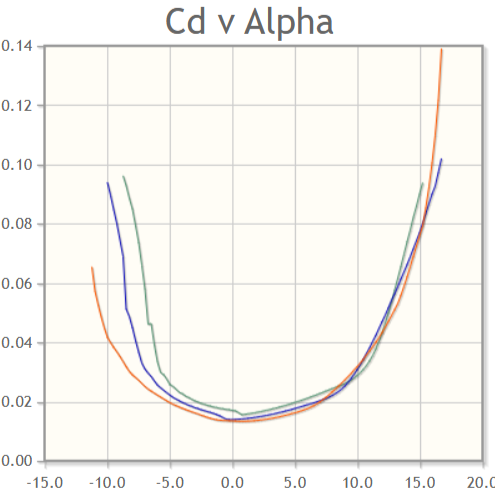
Course Materials/Images/cd_a.png
