metinoxy/VTOL/Course Materials/Images/cl_a.png

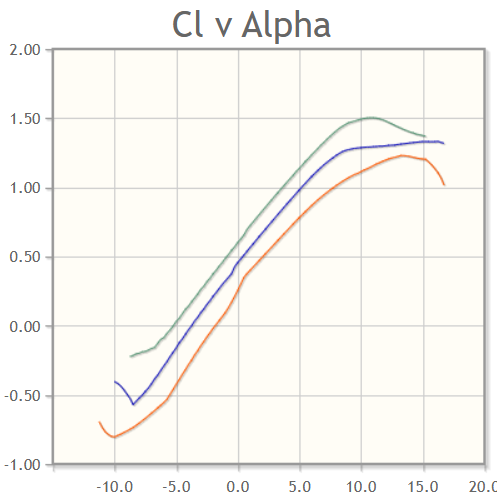
Course Materials/Images/cl_a.png
