metinoxy/VTOL/Course Materials/Images/cm_a.png

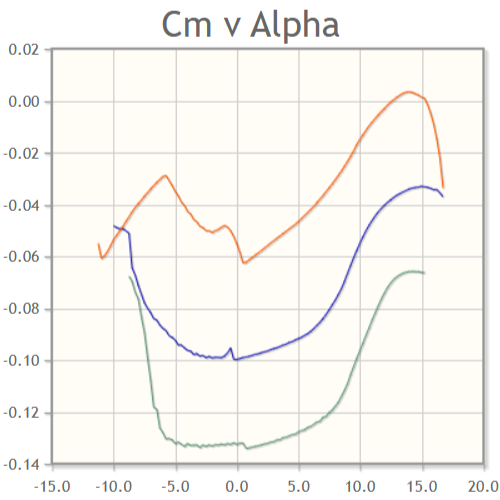
Course Materials/Images/cm_a.png
