metinoxy/VTOL/Course Materials/Images/Control_Diagram.png

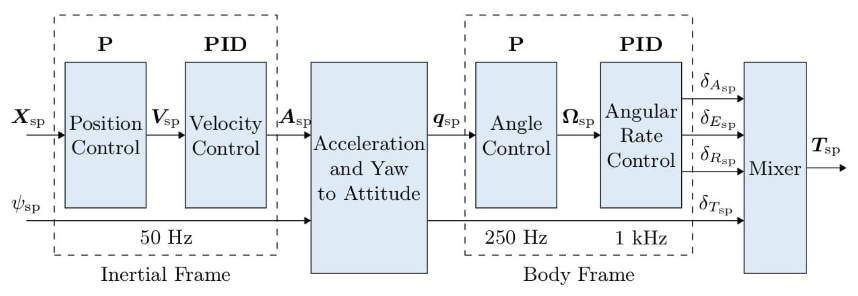
Course Materials/Images/Control_Diagram.png
