metinoxy/VTOL/Course Materials/Images/Cover_Render.JPG

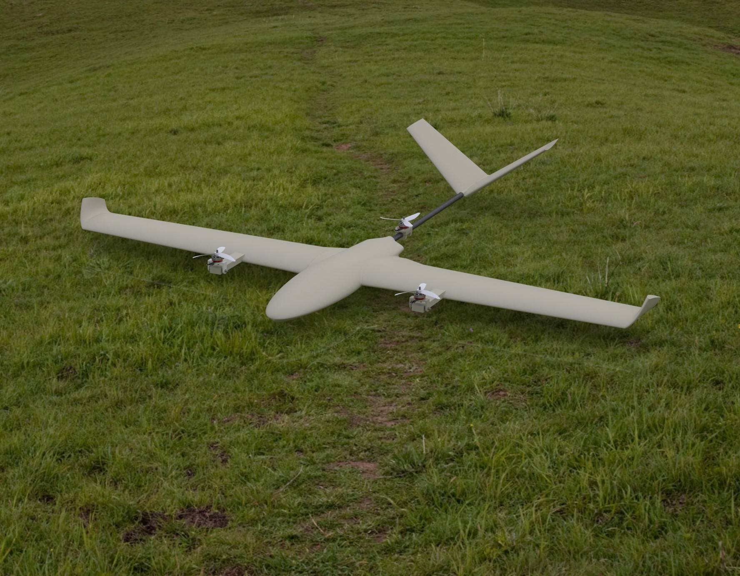
Course Materials/Images/Cover_Render.JPG
