metinoxy/VTOL/Course Materials/Images/Euler_angles.png

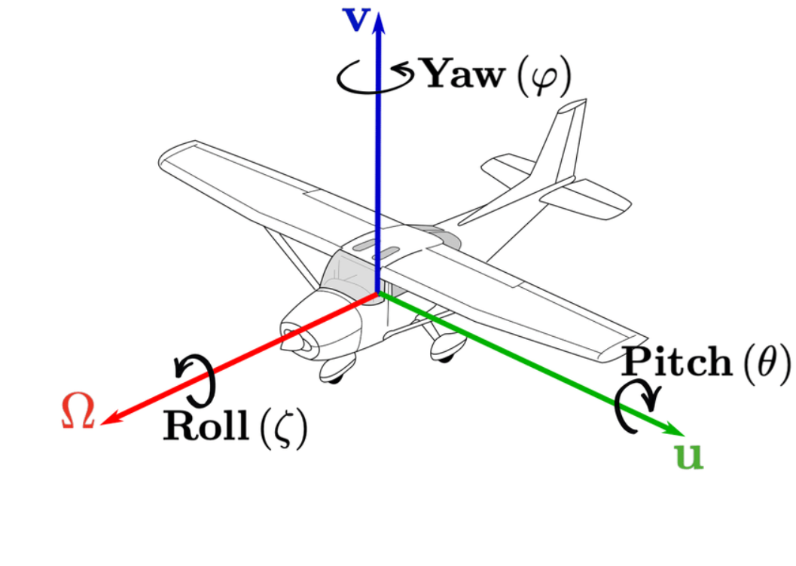
Course Materials/Images/Euler_angles.png
