metinoxy/VTOL/Course Materials/Images/Iris_Quadcopter.jpg

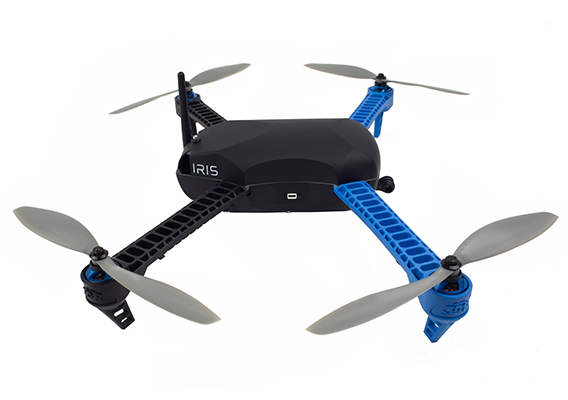
Course Materials/Images/Iris_Quadcopter.jpg
