metinoxy/VTOL/Course Materials/Images/Movements_of_aircraft.png

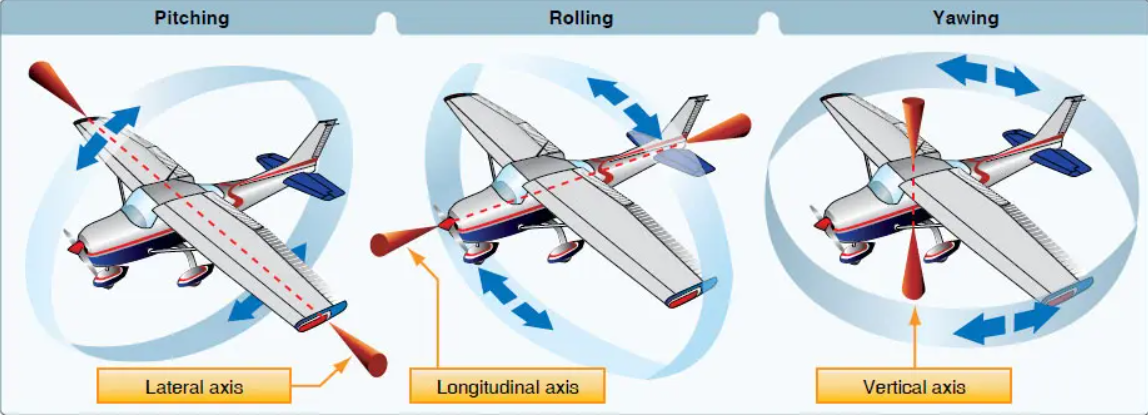
Course Materials/Images/Movements_of_aircraft.png
