metinoxy/VTOL/Course Materials/Images/Pixhawk_6x.png

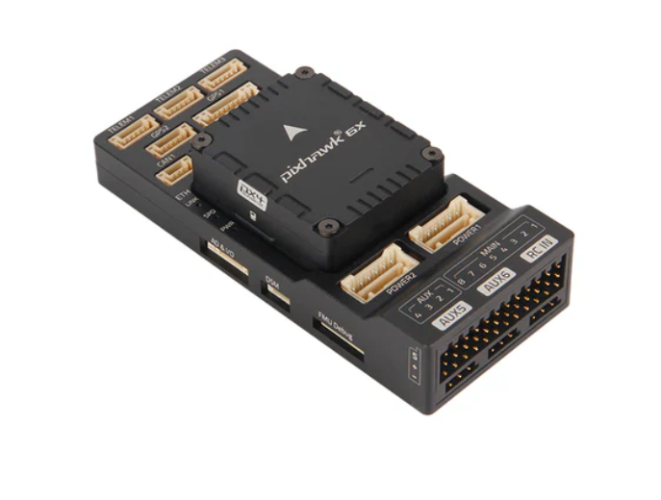
Course Materials/Images/Pixhawk_6x.png
