metinoxy/VTOL/Course Materials/Images/SmartSelect_20241204_161601_Samsung Notes.jpg

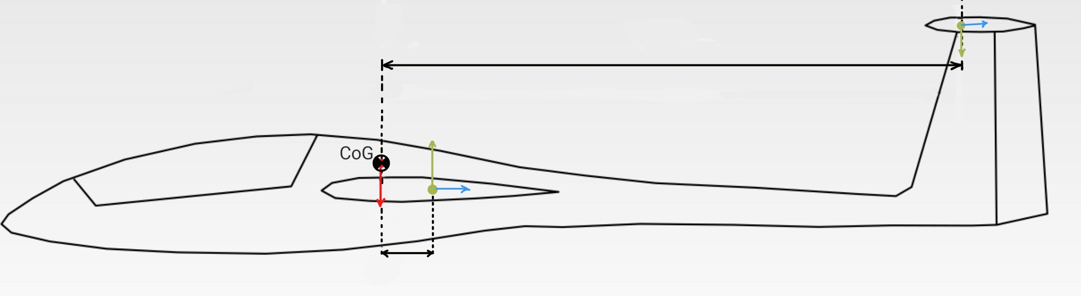
Course Materials/Images/SmartSelect_20241204_161601_Samsung Notes.jpg
