metinoxy/VTOL/Course Materials/Images/Static_Stability.jpg

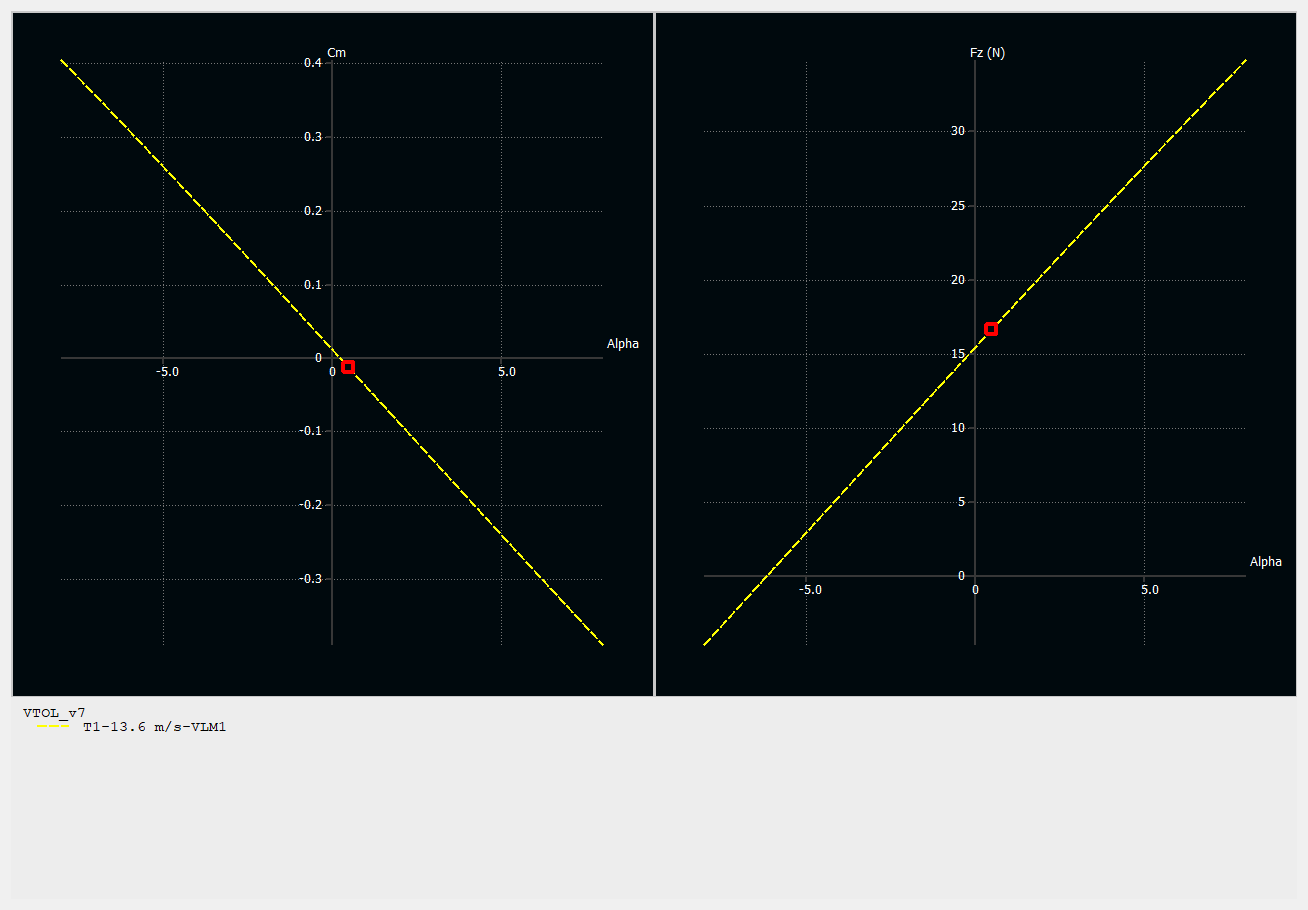
Course Materials/Images/Static_Stability.jpg
