metinoxy/VTOL/SolidWorks/Tilt Mechanism v2/EMAX RS2205 S/ROTOR.SLDASM

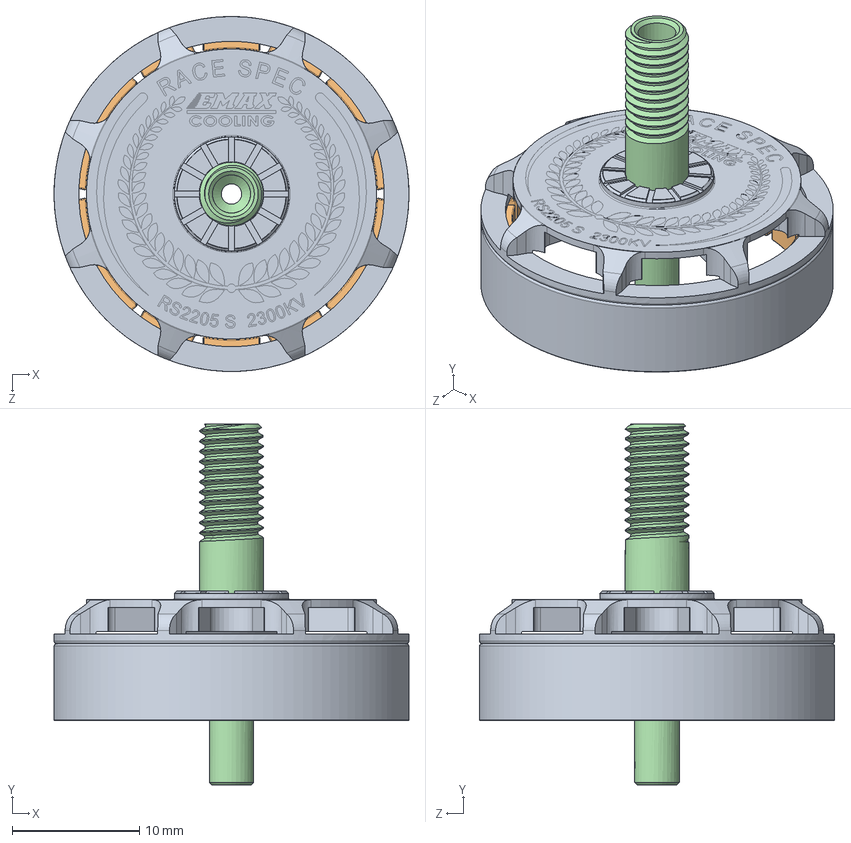
[picture p124: CAD file, 2025-05-07]
SolidWorks/Tilt Mechanism v2/EMAX RS2205 S/ROTOR.SLDASM
27.9 x 28.3 x 27.9 mm
ROTOR BELL
MAGNETS
MAGNETS ADHESIVE
SHAFT
