metinoxy/VTOL/SolidWorks/STL/Back_Mount_Main.STL

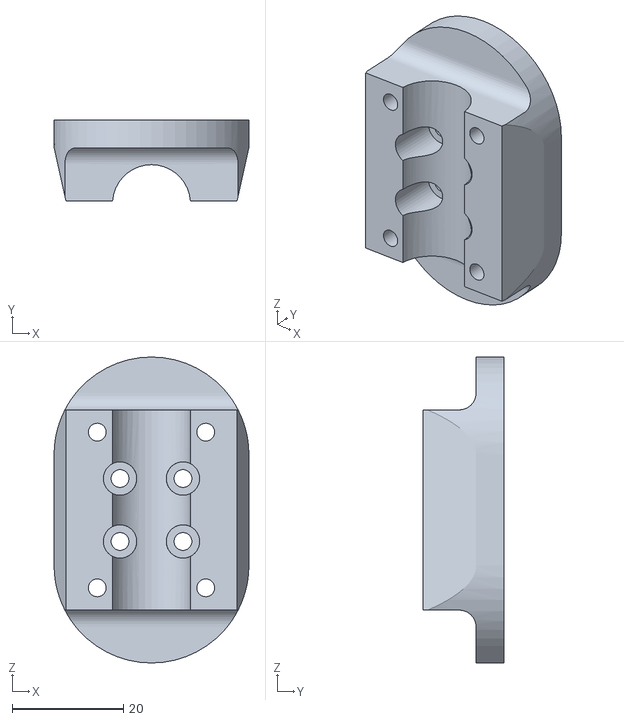
[picture p125: CAD file, 2025-06-06]
SolidWorks/STL/Back_Mount_Main.STL
35.0 x 14.5 x 55.0
