metinoxy/VTOL/SolidWorks/STL/Fuselage_BackLid.STL

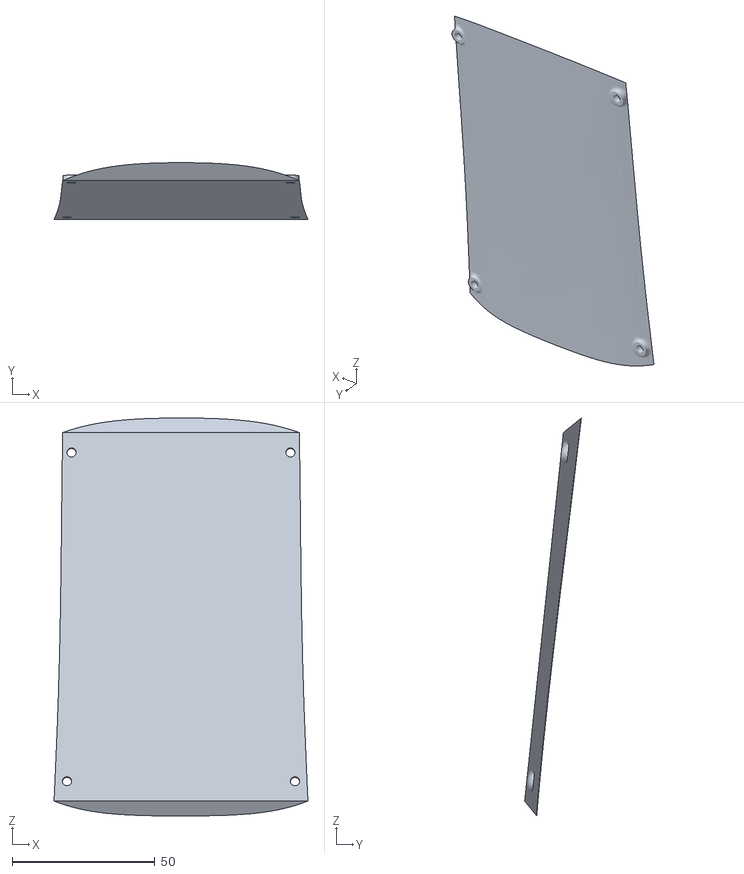
[picture p126: CAD file, 2025-06-06]
SolidWorks/STL/Fuselage_BackLid.STL
89.1 x 19.9 x 139.6
