metinoxy/VTOL/SolidWorks/Vtail_v4.SLDPRT

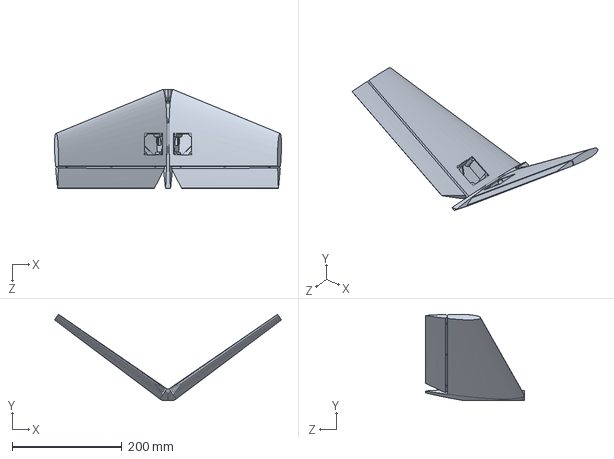
[picture p127: CAD file, 2025-06-11]
SolidWorks/Vtail_v4.SLDPRT
413.7 x 157.6 x 180.0 mm
