metinoxy/VTOL/SolidWorks/Analysis Parts/Wing_v0_cfd.SLDPRT

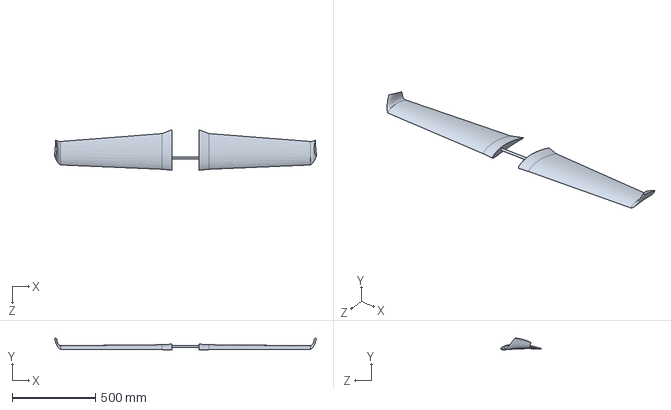
[picture p128: CAD file, 2024-12-17]
SolidWorks/Analysis Parts/Wing_v0_cfd.SLDPRT
1572.7 x 70.3 x 243.9 mm
