metinoxy/VTOL/SolidWorks/STL/Fuselage_FrontLid.STL

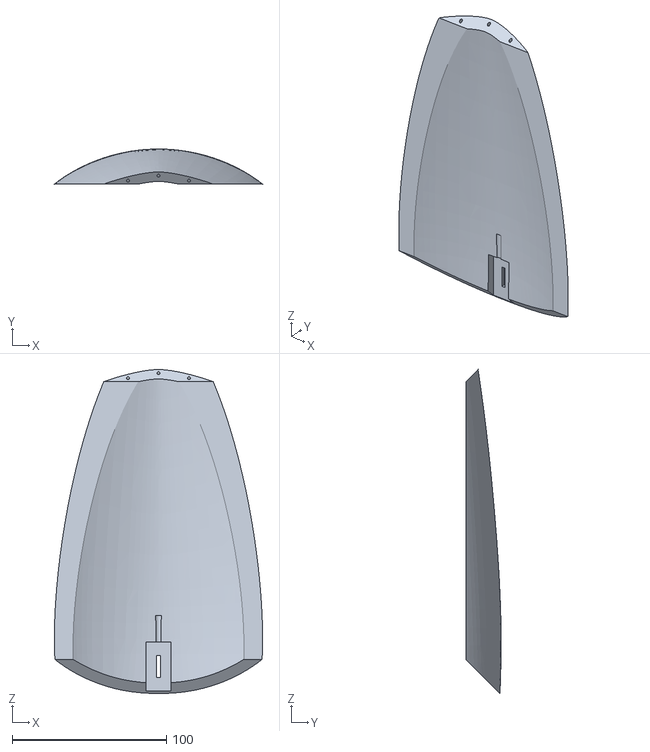
[picture p129: CAD file, 2025-06-06]
SolidWorks/STL/Fuselage_FrontLid.STL
134.8 x 22.8 x 209.8
