metinoxy/VTOL/SolidWorks/Tilt Mechanism v2/EMAX RS2205 S/STATOR.SLDPRT

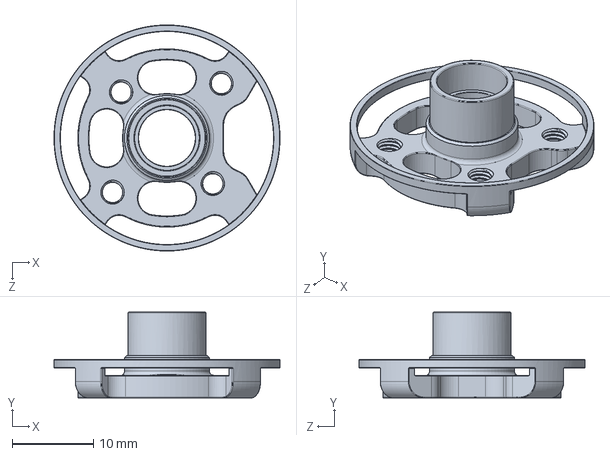
[picture p130: CAD file, 2025-05-07]
SolidWorks/Tilt Mechanism v2/EMAX RS2205 S/STATOR.SLDPRT
27.9 x 10.6 x 27.9 mm
