metinoxy/VTOL/SolidWorks/Wing_Aileron.SLDPRT

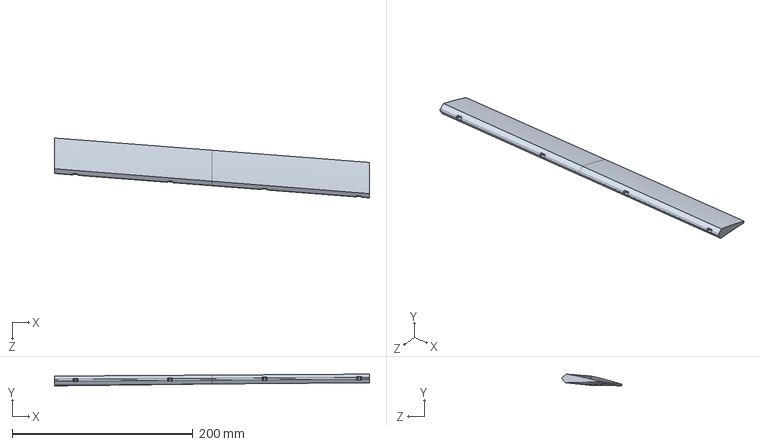
[picture p131: CAD file, 2025-06-09]
SolidWorks/Wing_Aileron.SLDPRT
349.0 x 13.1 x 66.5 mm
