metinoxy/VTOL/SolidWorks/Analysis Parts/Wing_analysis.SLDPRT

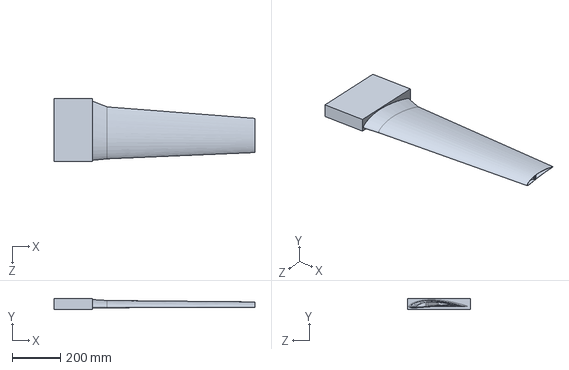
[picture p132: CAD file, 2024-12-17]
SolidWorks/Analysis Parts/Wing_analysis.SLDPRT
829.6 x 45.0 x 260.0 mm
