metinoxy/VTOL/SolidWorks/STL/Fuselage_P2.STL

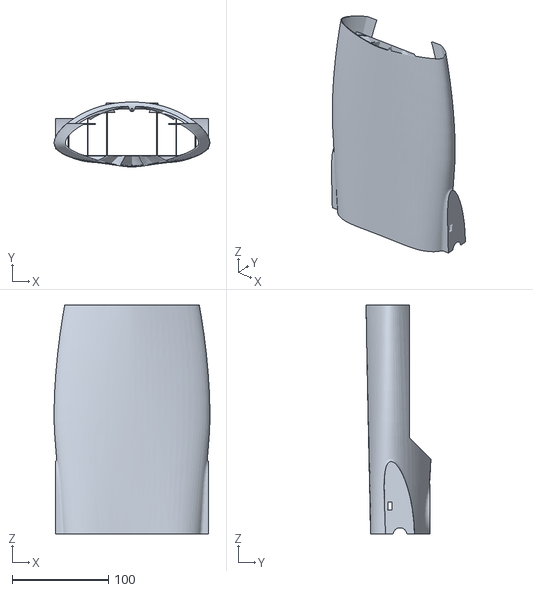
[picture p133: CAD file, 2025-06-06]
SolidWorks/STL/Fuselage_P2.STL
161.6 x 67.3 x 237.6
