metinoxy/VTOL/SolidWorks/Electronics/Standoff_5mm.SLDPRT

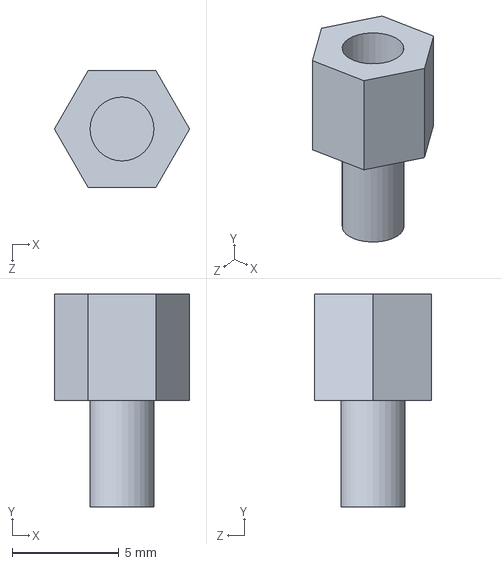
[picture p134: CAD file, 2025-05-07]
SolidWorks/Electronics/Standoff_5mm.SLDPRT
6.35 x 10.0 x 5.50 mm
