metinoxy/VTOL/SolidWorks/STL/Fuselage_P1.STL

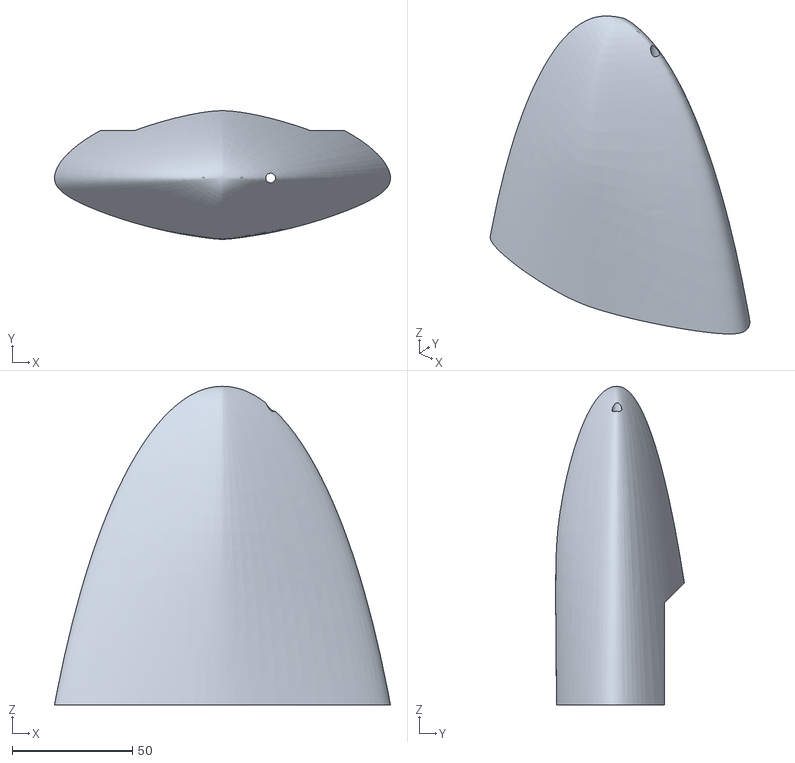
[picture p135: CAD file, 2025-06-06]
SolidWorks/STL/Fuselage_P1.STL
139.7 x 53.5 x 132.4
