metinoxy/VTOL/SolidWorks/Tilt Mechanism v2/EMAX RS2205 S/SHAFT.SLDPRT

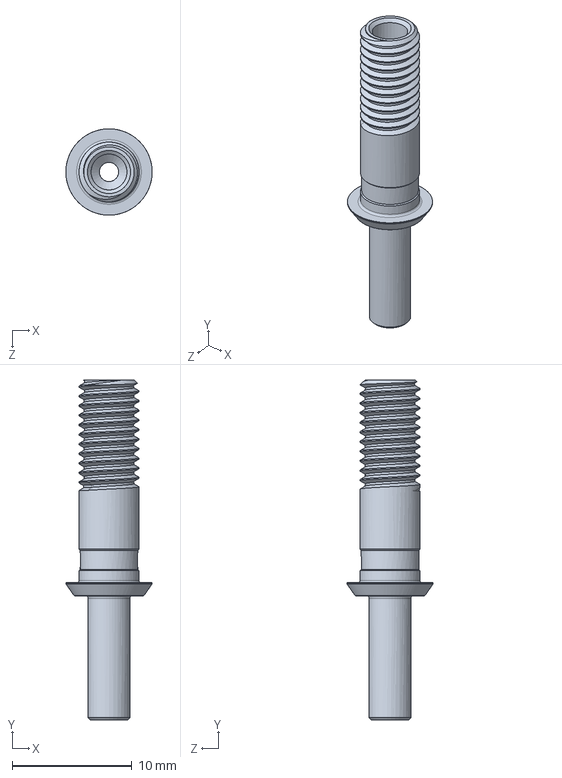
[picture p136: CAD file, 2025-05-07]
SolidWorks/Tilt Mechanism v2/EMAX RS2205 S/SHAFT.SLDPRT
7.20 x 28.3 x 7.20 mm
