metinoxy/VTOL/SolidWorks/Tilt Mechanism v2/Tilt_Mount.SLDPRT

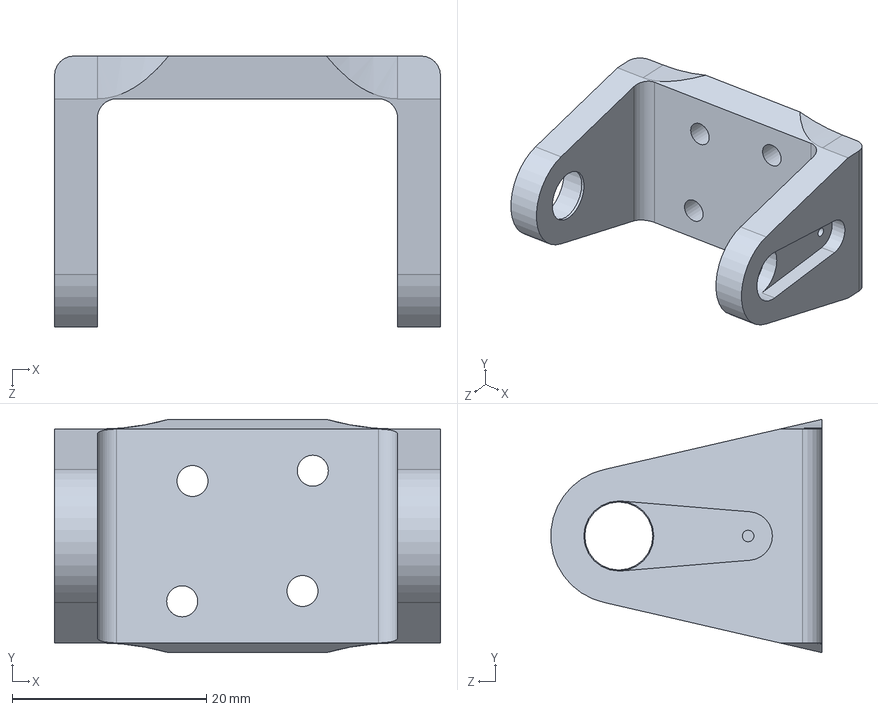
[picture p137: CAD file, 2025-06-09]
SolidWorks/Tilt Mechanism v2/Tilt_Mount.SLDPRT
39.7 x 24.0 x 27.9 mm
