metinoxy/VTOL/SolidWorks/Analysis Parts/Vtail_v0_cfd.SLDPRT

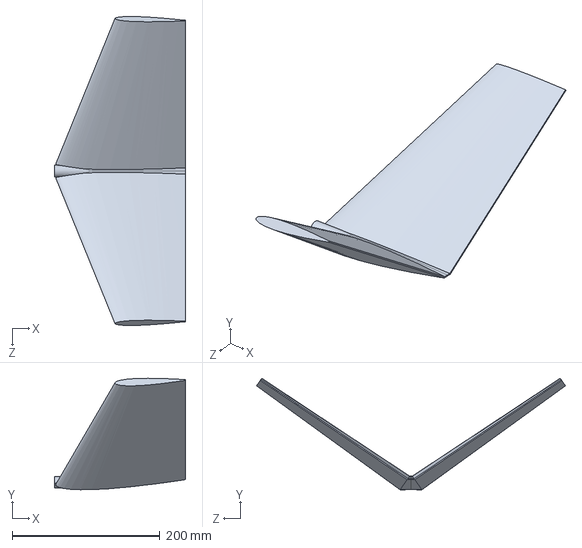
[picture p138: CAD file, 2024-12-17]
SolidWorks/Analysis Parts/Vtail_v0_cfd.SLDPRT
177.6 x 151.0 x 418.5 mm
