metinoxy/VTOL/SolidWorks/Electronics/Canopi_Lock.SLDPRT

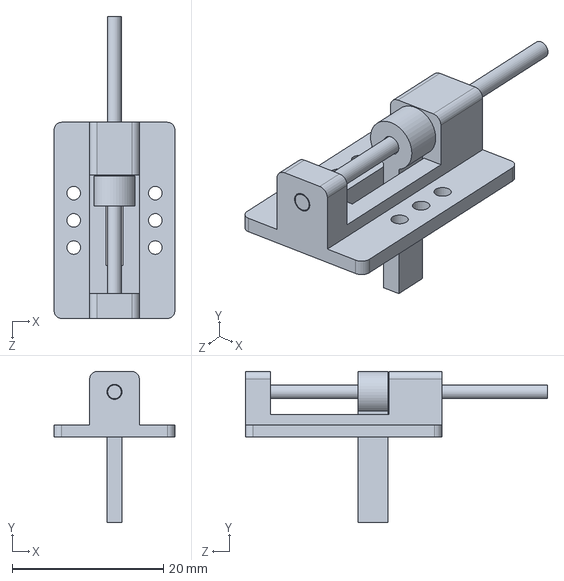
[picture p139: CAD file, 2025-03-31]
SolidWorks/Electronics/Canopi_Lock.SLDPRT
16.0 x 20.0 x 40.0 mm
