metinoxy/VTOL/SolidWorks/STL/Fuselage_P3.STL

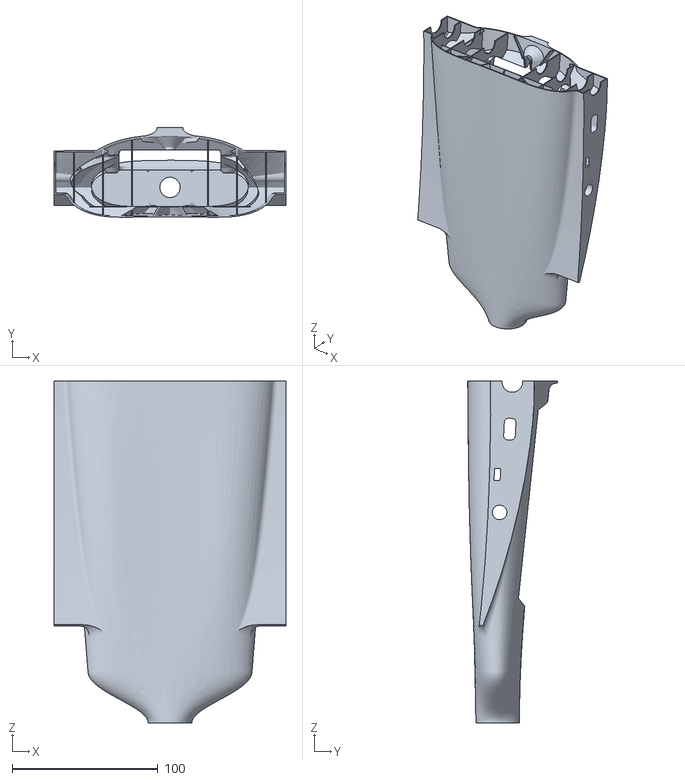
[picture p140: CAD file, 2025-06-06]
SolidWorks/STL/Fuselage_P3.STL
159.2 x 61.6 x 235.0
