metinoxy/VTOL/SolidWorks/Tilt Mechanism v2/EMAX RS2205 S/MAGNETS ADHESIVE.SLDPRT

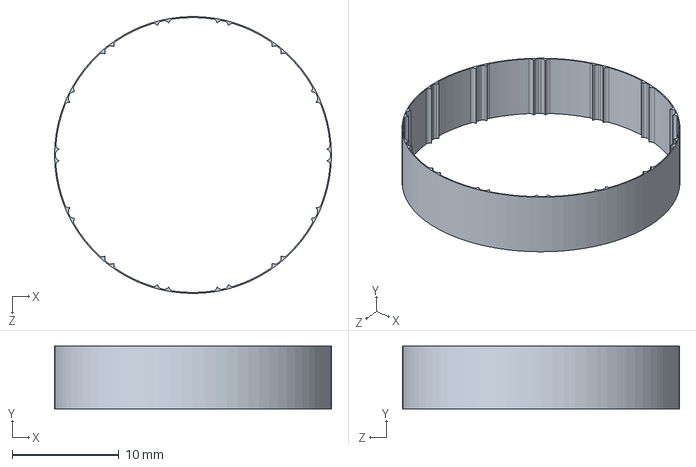
[picture p141: CAD file, 2025-05-07]
SolidWorks/Tilt Mechanism v2/EMAX RS2205 S/MAGNETS ADHESIVE.SLDPRT
26.0 x 5.90 x 26.0 mm
