metinoxy/VTOL/SolidWorks/Electronics/MiddlePipe.SLDPRT

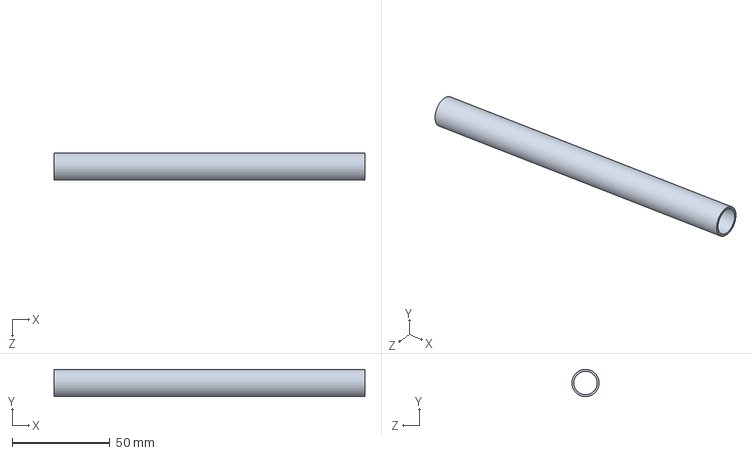
[picture p142: CAD file, 2025-03-31]
SolidWorks/Electronics/MiddlePipe.SLDPRT
159.2 x 14.0 x 14.0 mm
