metinoxy/VTOL/SolidWorks/STL/Arm.STL

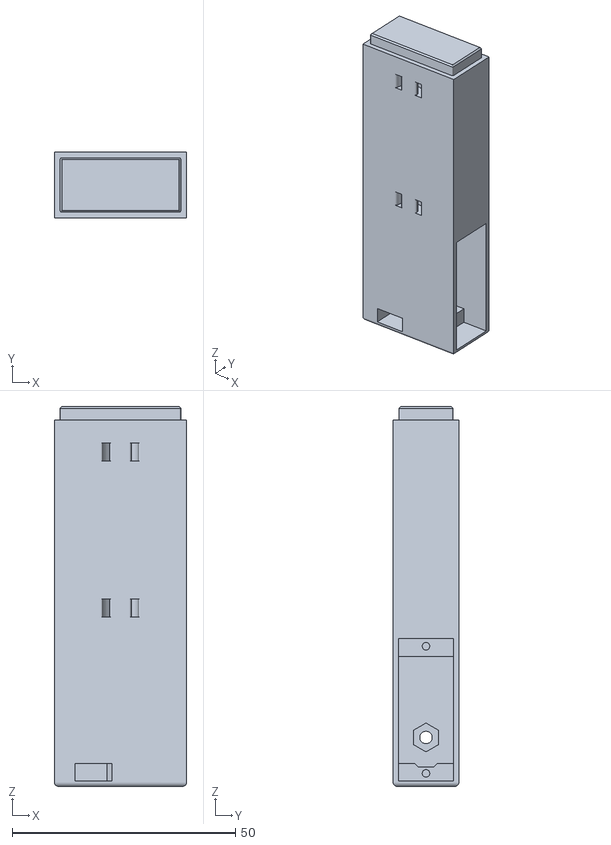
[picture p143: CAD file, 2025-06-06]
SolidWorks/STL/Arm.STL
29.7 x 14.8 x 85.2
