metinoxy/VTOL/SolidWorks/Tilt Mechanism v2/EMAX RS2205 S/STATOR SLEEVE.SLDPRT

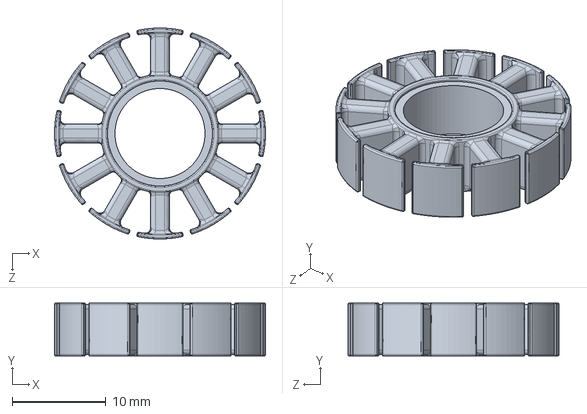
[picture p144: CAD file, 2025-05-07]
SolidWorks/Tilt Mechanism v2/EMAX RS2205 S/STATOR SLEEVE.SLDPRT
22.5 x 5.65 x 22.5 mm
