metinoxy/VTOL/SolidWorks/Vtail_Servo_Cap_v1.SLDPRT

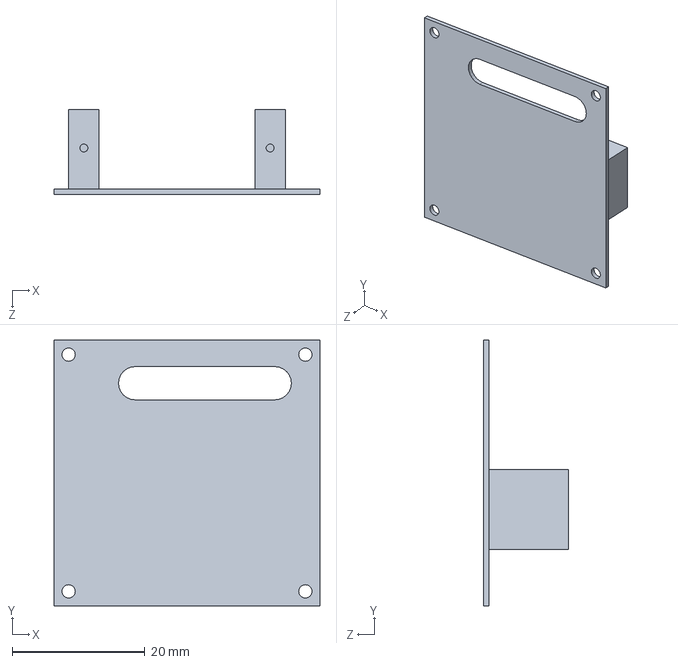
[picture p145: CAD file, 2025-06-06]
SolidWorks/Vtail_Servo_Cap_v1.SLDPRT
40.0 x 40.0 x 12.8 mm
