metinoxy/VTOL/SolidWorks/Electronics/pixhawk.SLDPRT

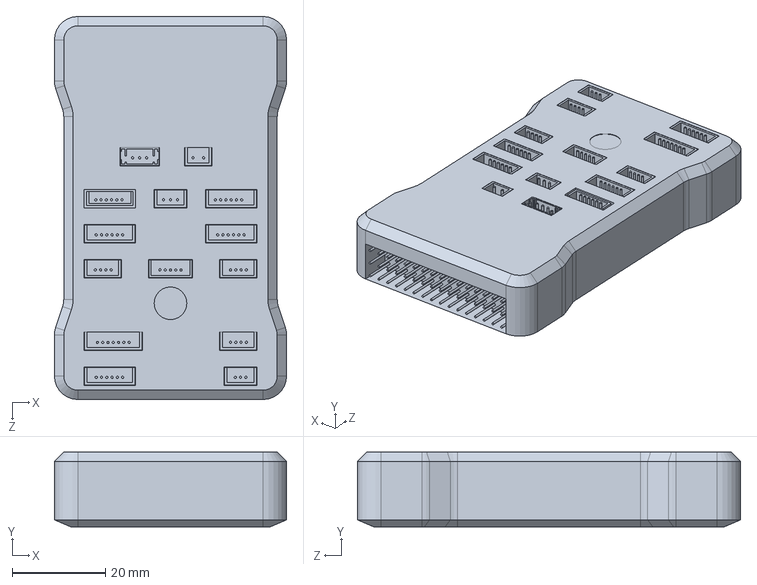
[picture p146: CAD file, 2025-03-31]
SolidWorks/Electronics/pixhawk.SLDPRT
49.7 x 16.0 x 82.0 mm
