metinoxy/VTOL/SolidWorks/STL/Wing_L_Winglet.STL

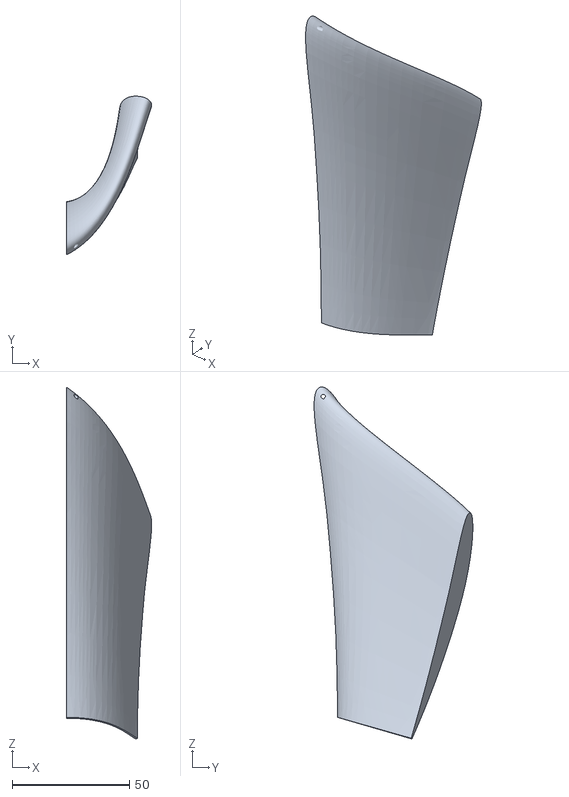
[picture p147: CAD file, 2025-06-06]
SolidWorks/STL/Wing_L_Winglet.STL
36.4 x 67.6 x 150.0
