metinoxy/VTOL/SolidWorks/Tilt Mechanism v2/EMAX RS2205 S/WINDING.SLDPRT

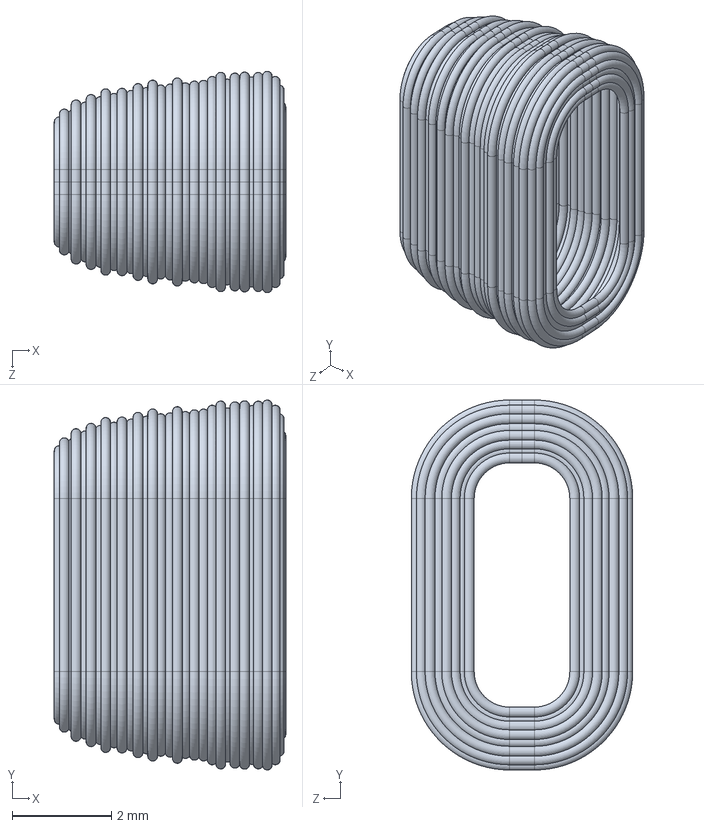
[picture p148: CAD file, 2025-05-07]
SolidWorks/Tilt Mechanism v2/EMAX RS2205 S/WINDING.SLDPRT
4.68 x 7.47 x 4.47 mm
