metinoxy/VTOL/SolidWorks/Vtail_Ruddervator.SLDPRT

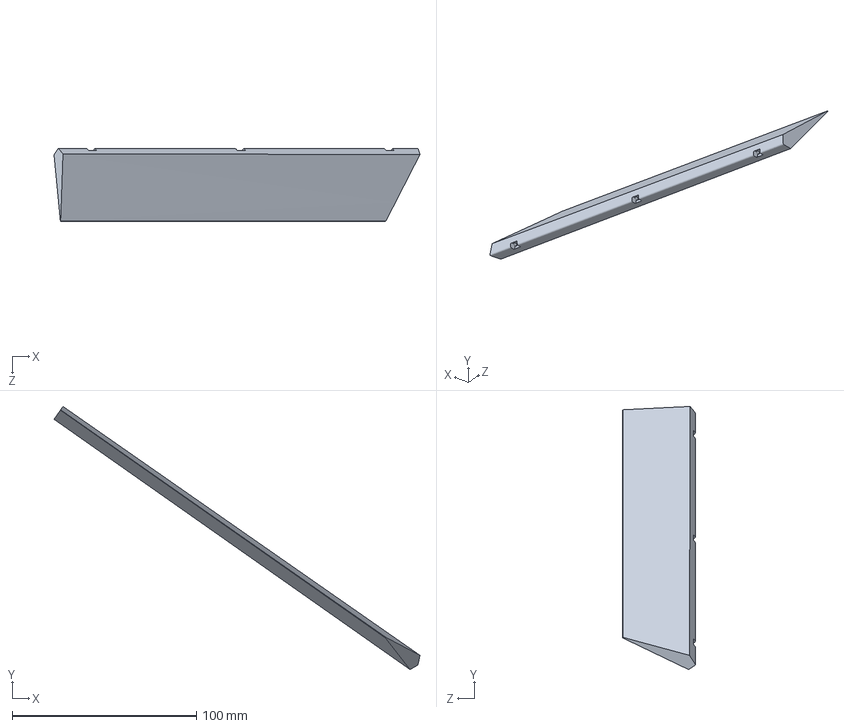
[picture p149: CAD file, 2025-06-06]
SolidWorks/Vtail_Ruddervator.SLDPRT
198.5 x 142.7 x 39.4 mm
