metinoxy/VTOL/SolidWorks/Back_Mount_v1.SLDPRT

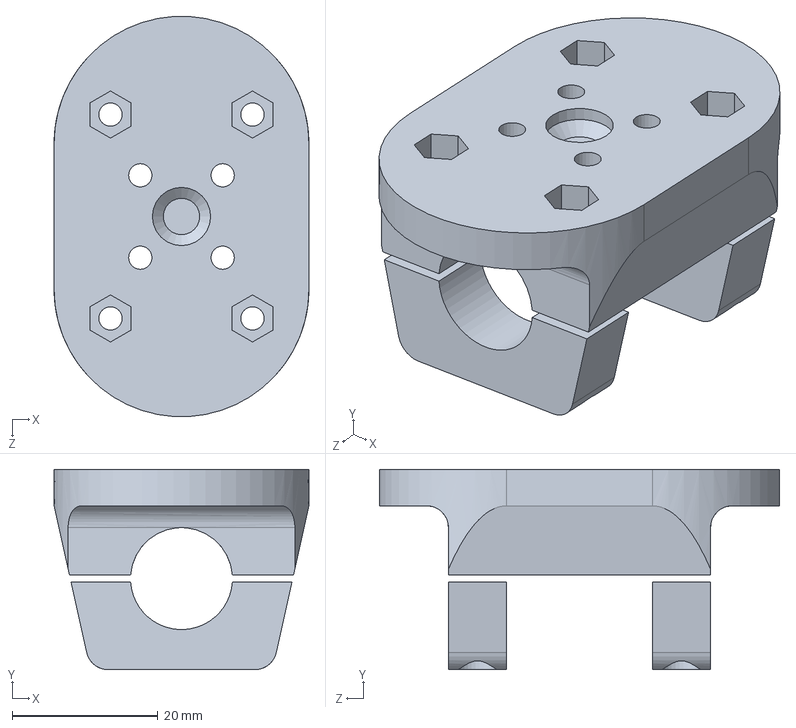
[picture p150: CAD file, 2025-06-02]
SolidWorks/Back_Mount_v1.SLDPRT
35.0 x 27.5 x 54.9 mm
