metinoxy/VTOL/SolidWorks/Electronics/PowerModule.SLDPRT

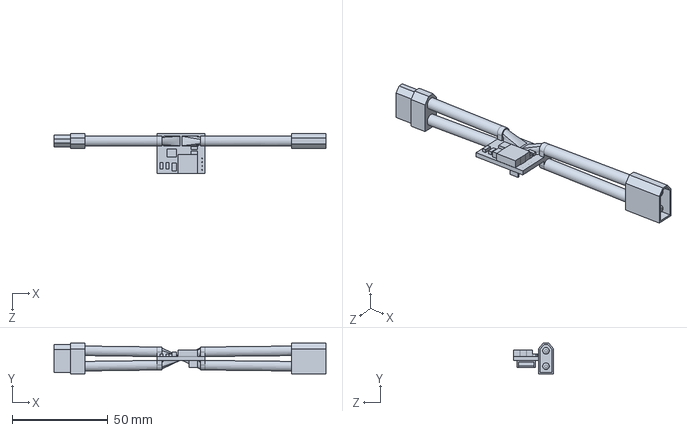
[picture p151: CAD file, 2025-03-31]
SolidWorks/Electronics/PowerModule.SLDPRT
141.7 x 16.0 x 21.0 mm
