metinoxy/VTOL/SolidWorks/Tilt Mechanism v2/ES09MD_ARM.SLDPRT

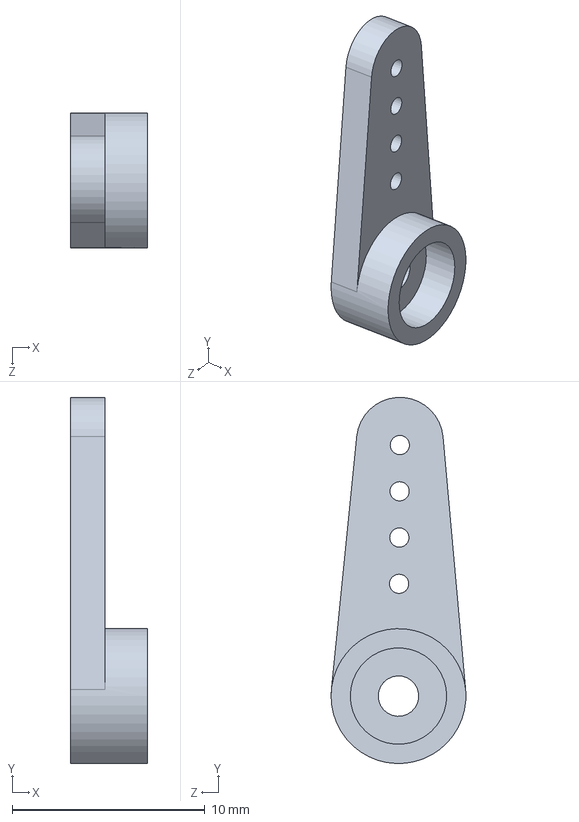
[picture p152: CAD file, 2025-05-07]
SolidWorks/Tilt Mechanism v2/ES09MD_ARM.SLDPRT
4.00 x 19.0 x 7.00 mm
