metinoxy/VTOL/SolidWorks/Electronics/Battery.SLDPRT

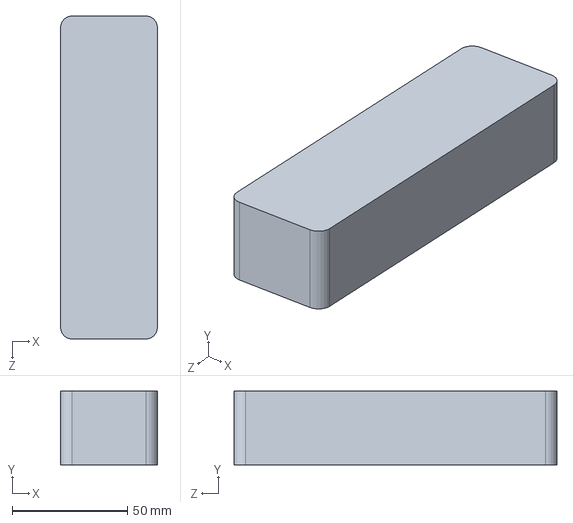
[picture p153: CAD file, 2025-03-31]
SolidWorks/Electronics/Battery.SLDPRT
42.0 x 32.0 x 140.0 mm
