metinoxy/VTOL/SolidWorks/STL/Vtail_L.STL

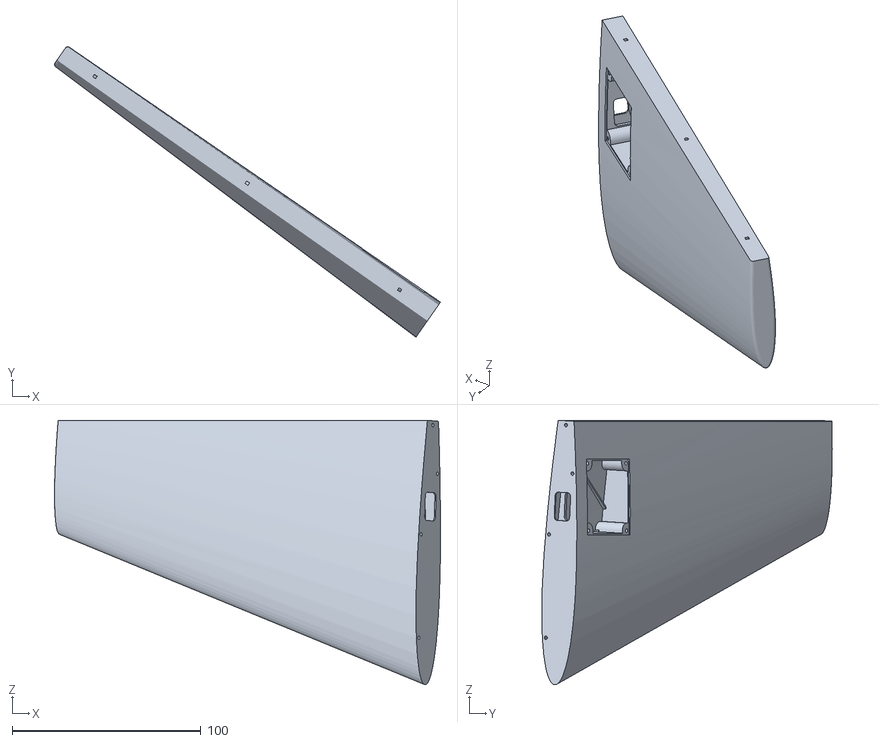
[picture p154: CAD file, 2025-06-06]
SolidWorks/STL/Vtail_L.STL
204.5 x 153.9 x 140.1
