metinoxy/VTOL/SolidWorks/Tilt Mechanism v2/EMAX RS2205 S/MAGNETS.SLDPRT

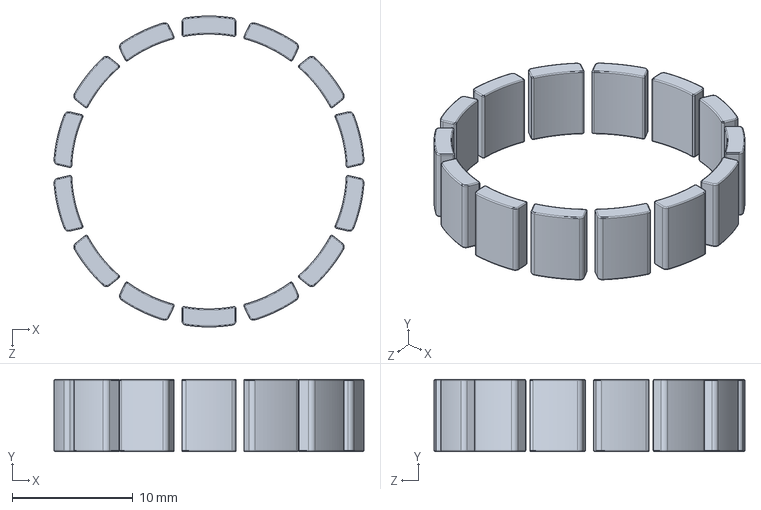
[picture p155: CAD file, 2025-05-07]
SolidWorks/Tilt Mechanism v2/EMAX RS2205 S/MAGNETS.SLDPRT
25.7 x 6.00 x 25.8 mm
