metinoxy/VTOL/SolidWorks/Wing_Servo_Cap_v1.SLDPRT

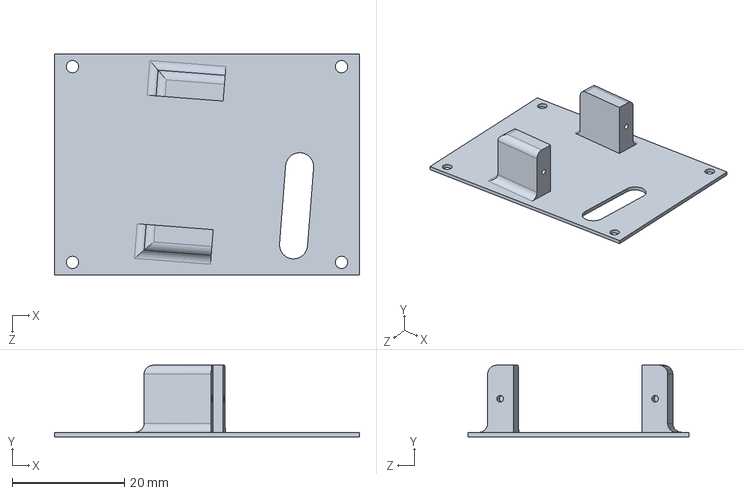
[picture p156: CAD file, 2025-03-30]
SolidWorks/Wing_Servo_Cap_v1.SLDPRT
54.4 x 12.8 x 39.4 mm
