metinoxy/VTOL/SolidWorks/CS_Hinge.SLDPRT

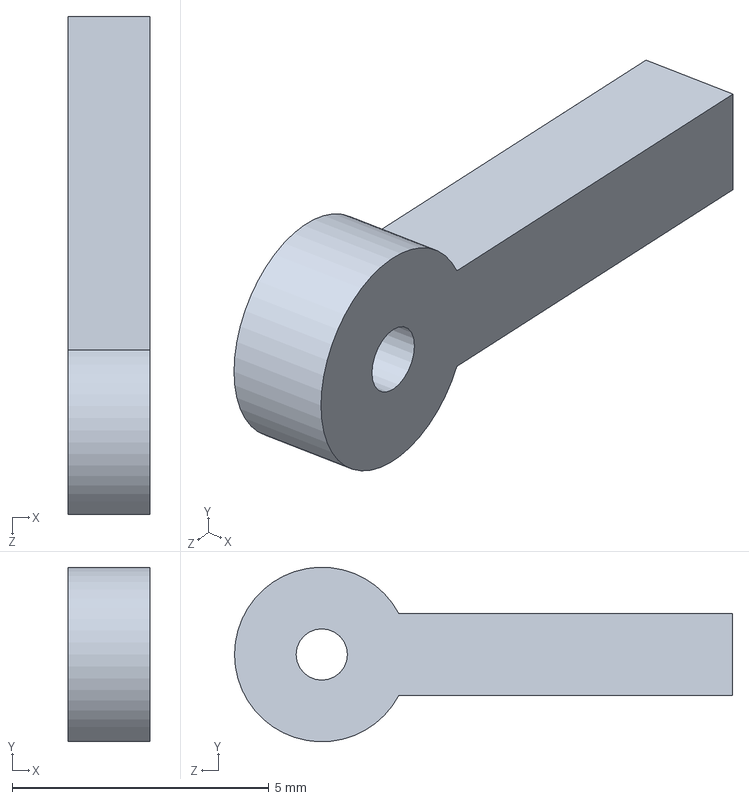
[picture p157: CAD file, 2025-03-08]
SolidWorks/CS_Hinge.SLDPRT
1.60 x 3.40 x 9.70 mm
