metinoxy/VTOL/SolidWorks/Electronics/Pitotube.SLDPRT

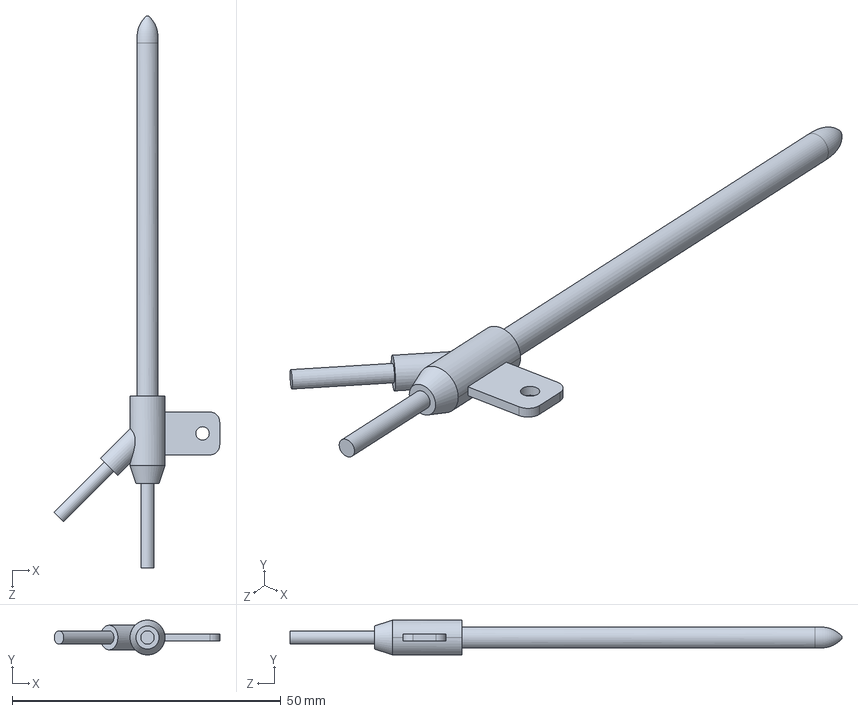
[picture p158: CAD file, 2025-03-31]
SolidWorks/Electronics/Pitotube.SLDPRT
30.8 x 6.50 x 102.7 mm
