metinoxy/VTOL/SolidWorks/STL/Wing_L_P2.STL

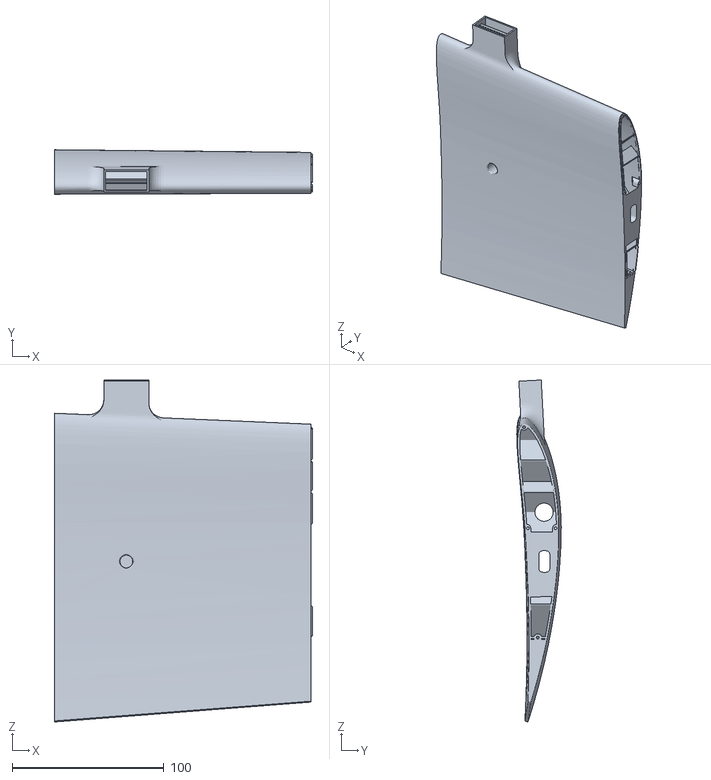
[picture p159: CAD file, 2025-06-06]
SolidWorks/STL/Wing_L_P2.STL
170.4 x 29.4 x 225.6
