metinoxy/VTOL/SolidWorks/Tilt Mechanism v2/EMAX RS2205 S/BEARING.sldprt

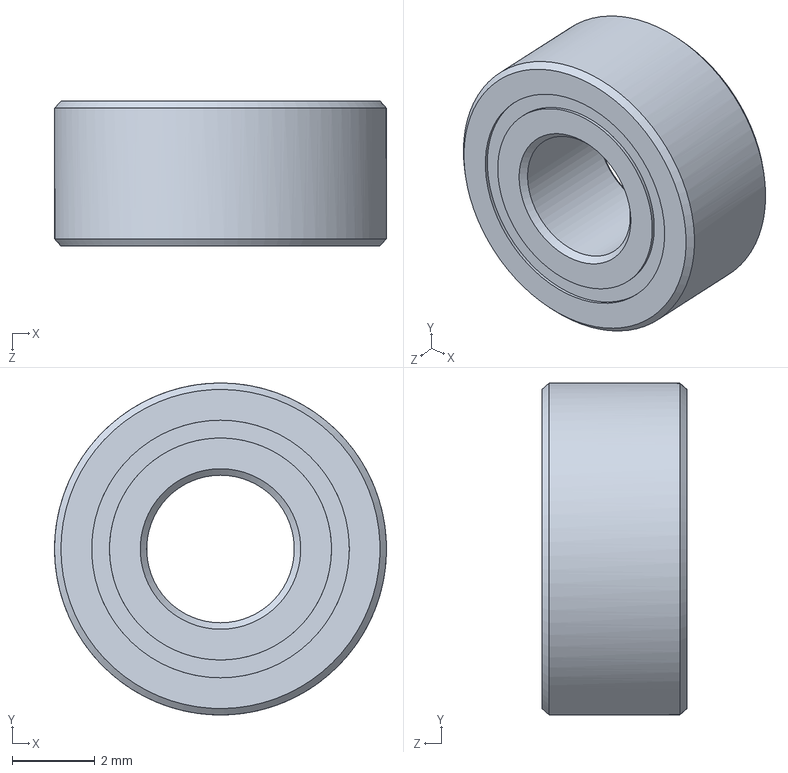
[picture p160: CAD file, 2024-12-17]
SolidWorks/Tilt Mechanism v2/EMAX RS2205 S/BEARING.sldprt
8.00 x 8.00 x 3.50 mm
