metinoxy/VTOL/SolidWorks/Tilt Mechanism v2/ES09MD.SLDPRT

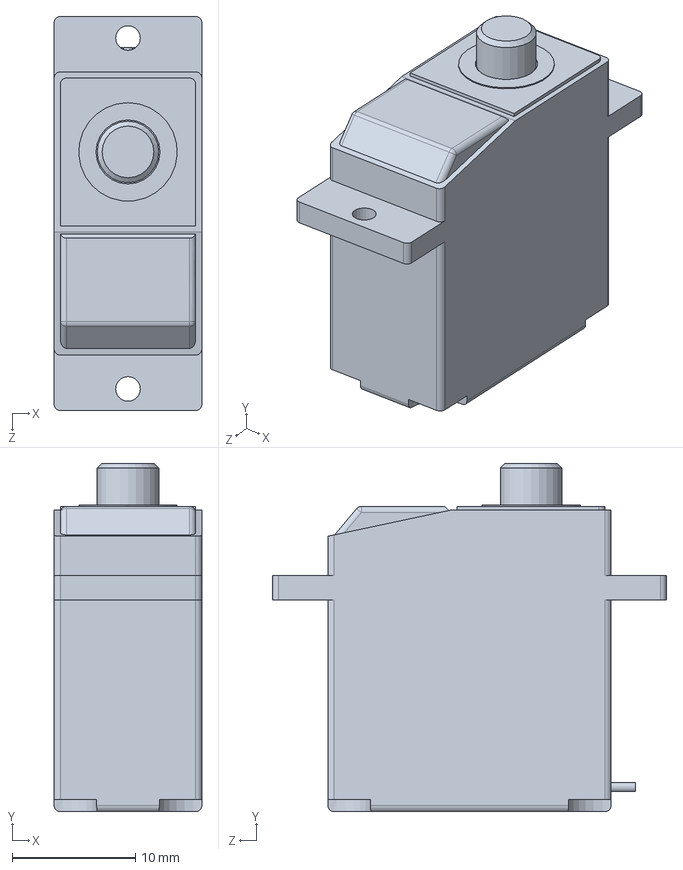
[picture p161: CAD file, 2024-12-17]
SolidWorks/Tilt Mechanism v2/ES09MD.SLDPRT
12.0 x 28.3 x 32.0 mm
