metinoxy/VTOL/SolidWorks/CFRP_Tube_12-10-500.SLDPRT

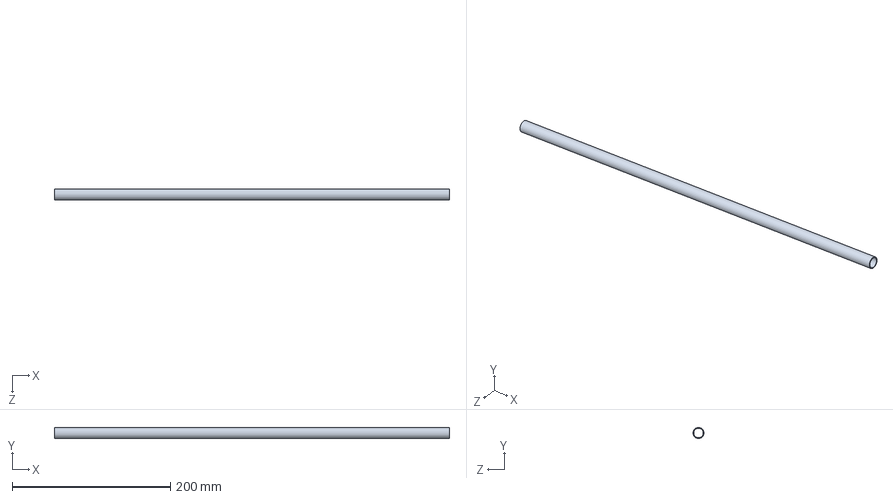
[picture p162: CAD file, 2025-01-08]
SolidWorks/CFRP_Tube_12-10-500.SLDPRT
500.0 x 13.9 x 14.0 mm
