metinoxy/VTOL/SolidWorks/STL/Wing_L_P3.STL

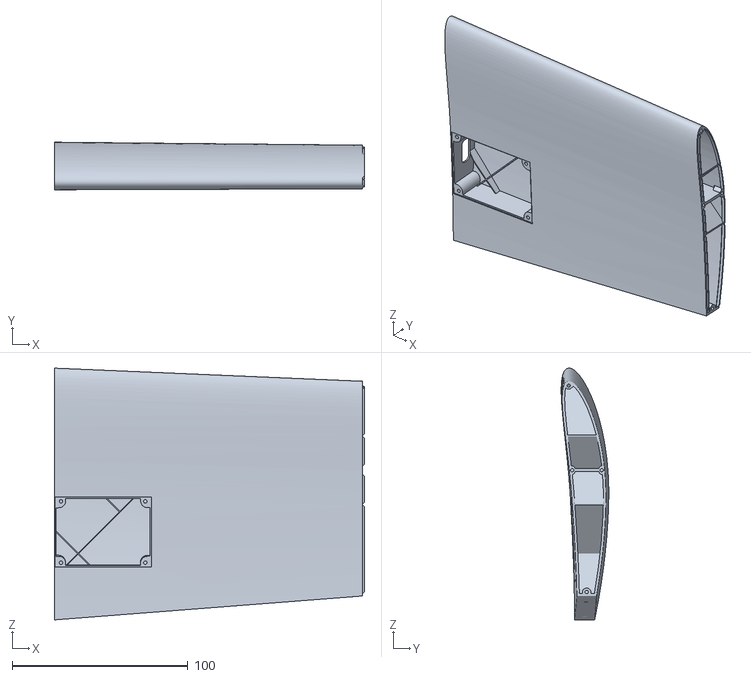
[picture p163: CAD file, 2025-06-06]
SolidWorks/STL/Wing_L_P3.STL
176.5 x 27.1 x 143.3
