metinoxy/VTOL/SolidWorks/Tilt Mechanism v2/propeller.SLDPRT

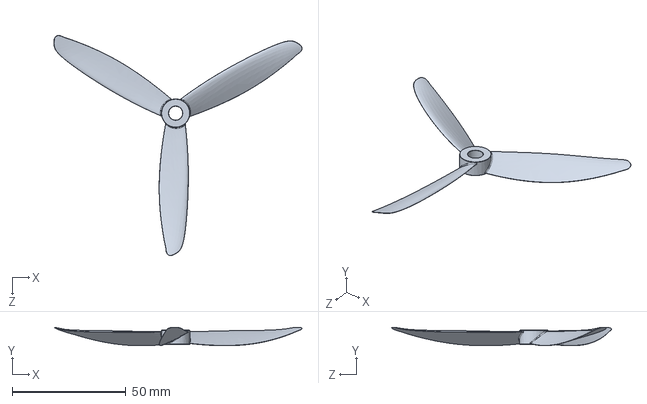
[picture p164: CAD file, 2024-12-17]
SolidWorks/Tilt Mechanism v2/propeller.SLDPRT
109.2 x 8.14 x 96.9 mm
