metinoxy/VTOL/SolidWorks/Electronics/Control_Horn.SLDPRT

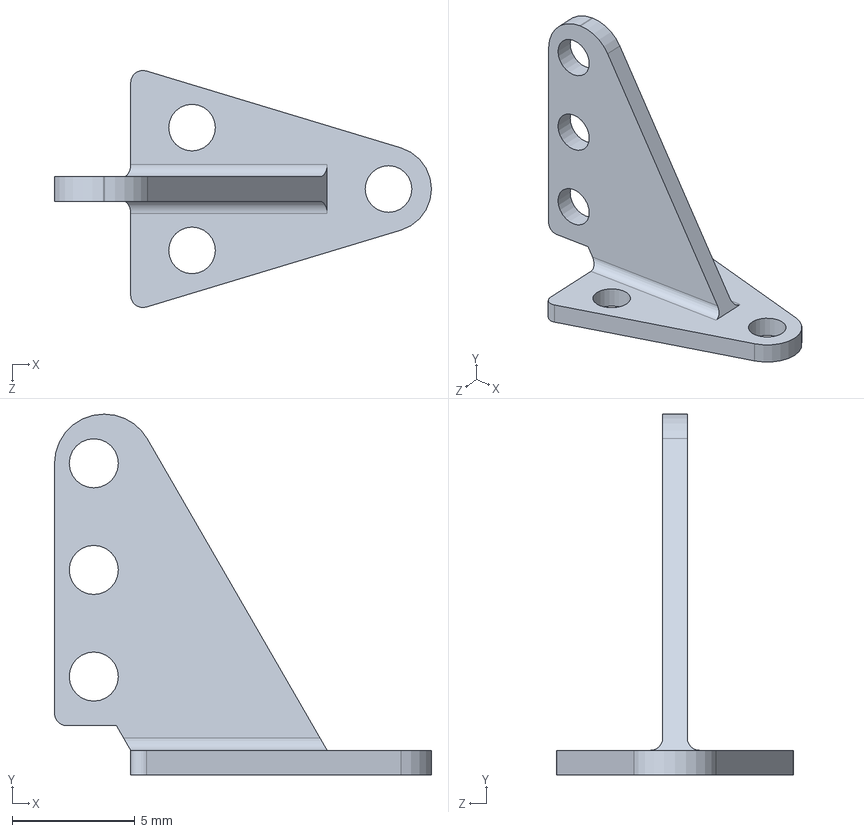
[picture p165: CAD file, 2025-03-08]
SolidWorks/Electronics/Control_Horn.SLDPRT
15.4 x 14.7 x 9.65 mm
