metinoxy/VTOL/SolidWorks/STL/Wing_L_P4.STL

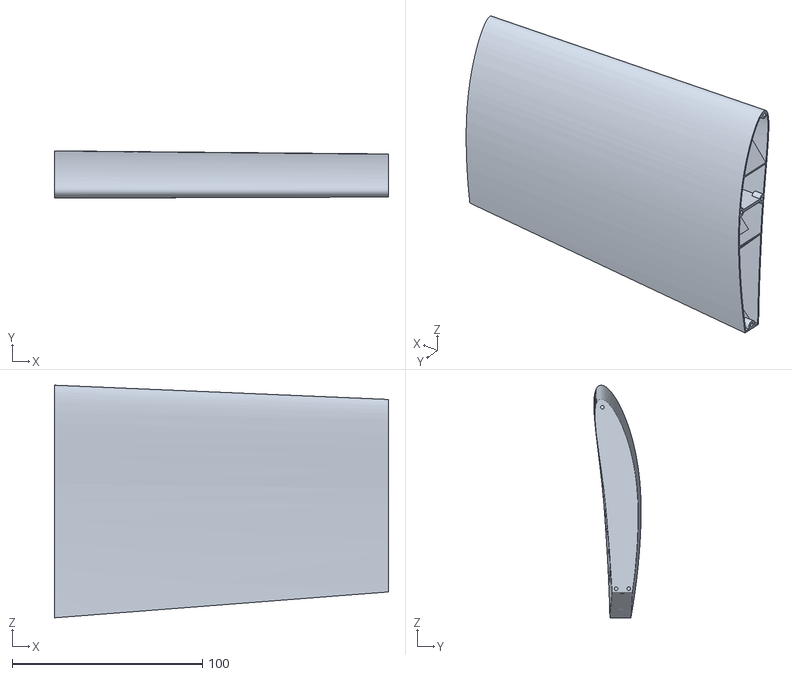
[picture p166: CAD file, 2025-06-06]
SolidWorks/STL/Wing_L_P4.STL
175.5 x 24.8 x 122.2
