metinoxy/VTOL/SolidWorks/Tilt Mechanism v2/ES09MD_shaft.SLDPRT

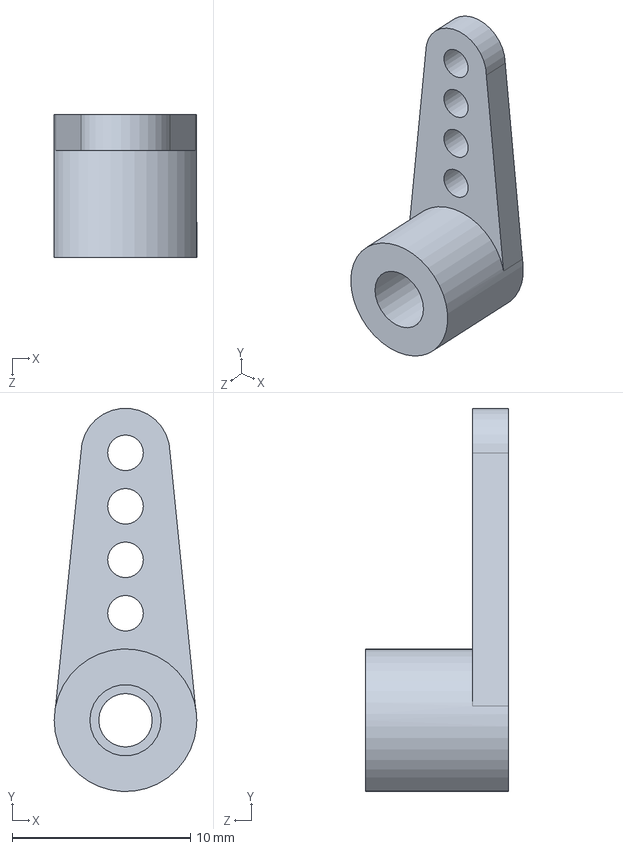
[picture p167: CAD file, 2024-12-17]
SolidWorks/Tilt Mechanism v2/ES09MD_shaft.SLDPRT
8.00 x 21.5 x 8.00 mm
