metinoxy/VTOL/SolidWorks/Electronics/Servo_MG90S.SLDPRT

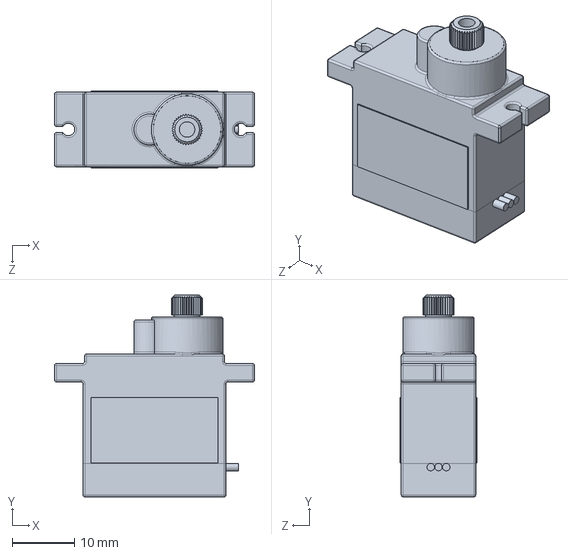
[picture p168: CAD file, 2025-03-07]
SolidWorks/Electronics/Servo_MG90S.SLDPRT
32.2 x 32.5 x 12.4 mm
