metinoxy/VTOL/SolidWorks/Wing_v1.SLDPRT

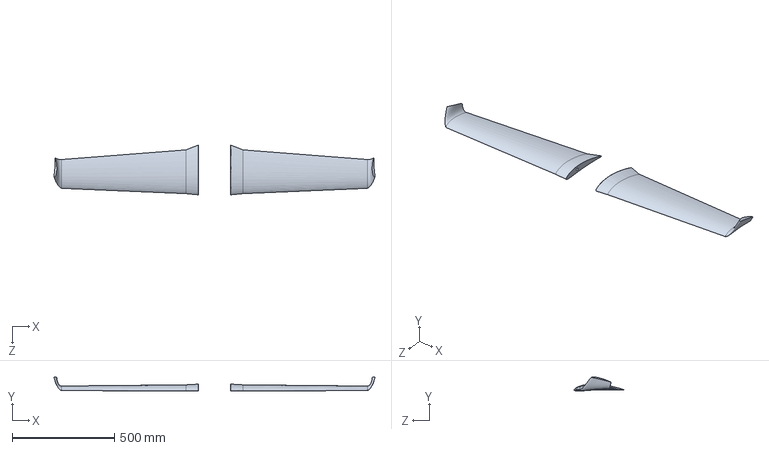
[picture p169: CAD file, 2024-11-19]
SolidWorks/Wing_v1.SLDPRT
1572.7 x 70.3 x 243.9 mm
