metinoxy/VTOL/SolidWorks/Electronics/SG90 - Micro Servo 9g - Tower Pro.2.SLDPRT

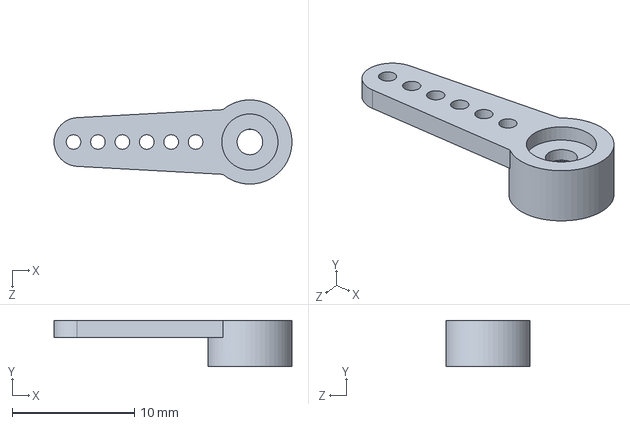
[picture p170: CAD file, 2025-03-07]
SolidWorks/Electronics/SG90 - Micro Servo 9g - Tower Pro.2.SLDPRT
19.5 x 3.80 x 6.90 mm
