metinoxy/VTOL/SolidWorks/Fuselage_v1.SLDPRT

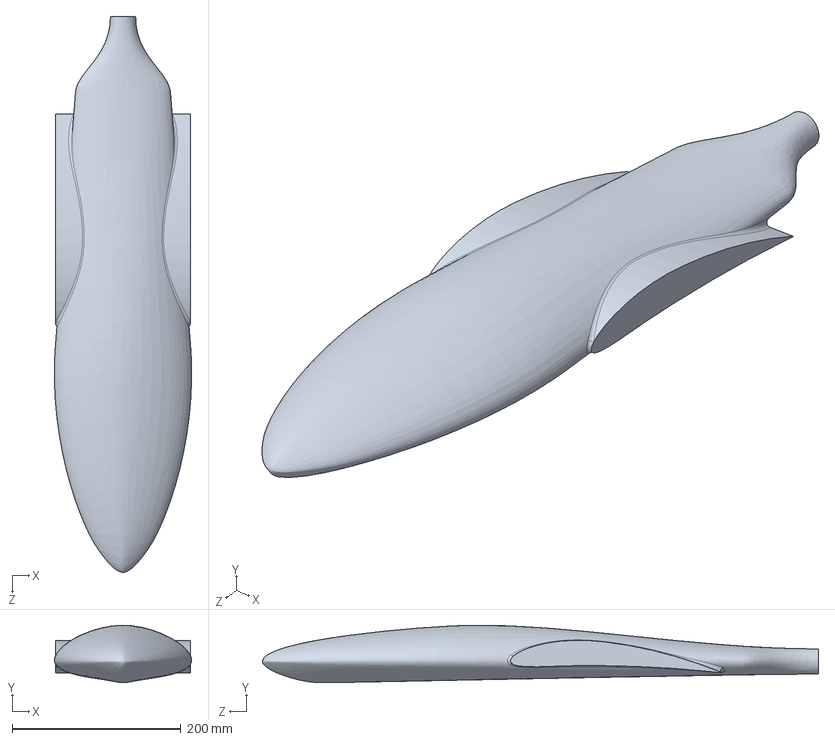
[picture p171: CAD file, 2024-11-15]
SolidWorks/Fuselage_v1.SLDPRT
162.8 x 68.1 x 659.2 mm
