metinoxy/VTOL/SolidWorks/STL/Aileron_L_P2.STL

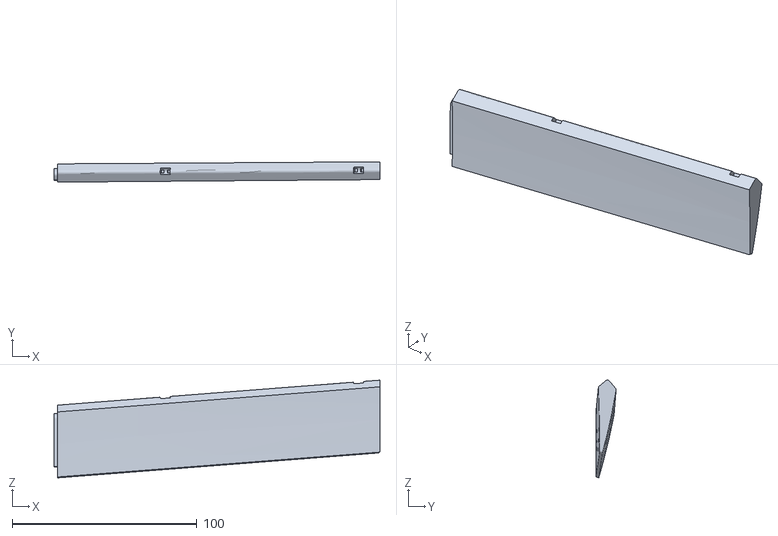
[picture p172: CAD file, 2025-06-06]
SolidWorks/STL/Aileron_L_P2.STL
176.5 x 11.0 x 52.9
