metinoxy/VTOL/SolidWorks/STL/Aileron_L_P1.STL

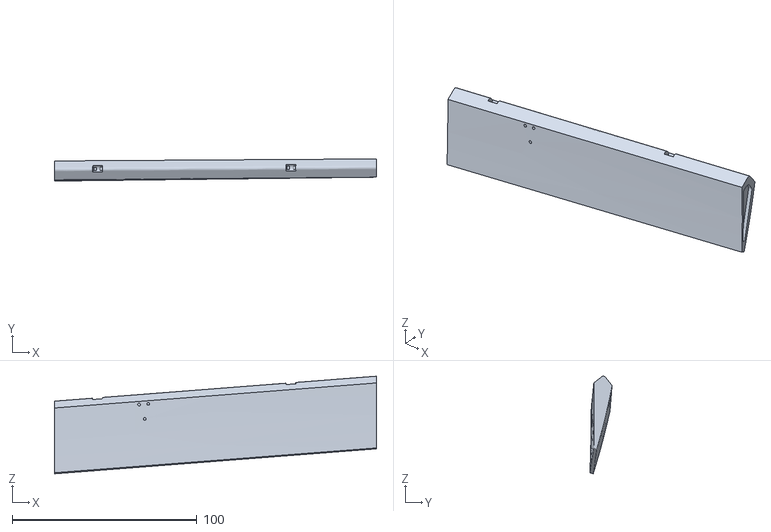
[picture p173: CAD file, 2025-06-06]
SolidWorks/STL/Aileron_L_P1.STL
174.5 x 12.0 x 52.9
