metinoxy/VTOL/SolidWorks/STL/Back_Mount_Clamp.STL

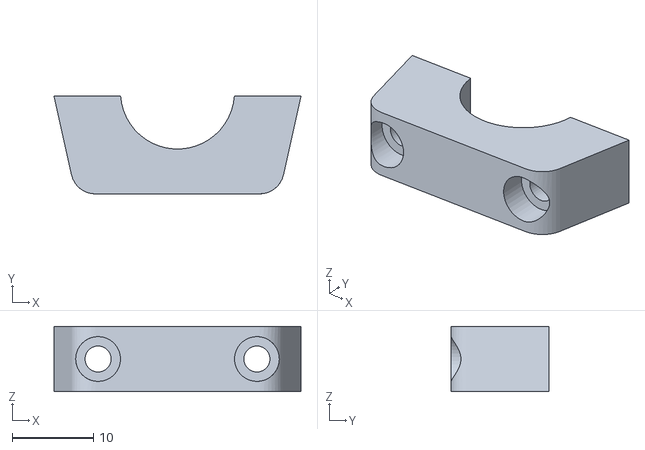
[picture p174: CAD file, 2025-06-06]
SolidWorks/STL/Back_Mount_Clamp.STL
30.3 x 12.0 x 8.00
