metinoxy/VTOL/SolidWorks/STL/Wing_L_P1.STL

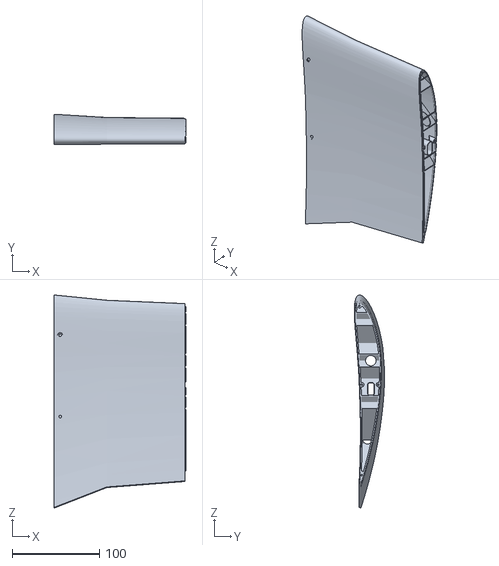
[picture p175: CAD file, 2025-06-06]
SolidWorks/STL/Wing_L_P1.STL
151.0 x 34.9 x 243.9
