metinoxy/VTOL/SolidWorks/STL/Vtail_Mid.STL

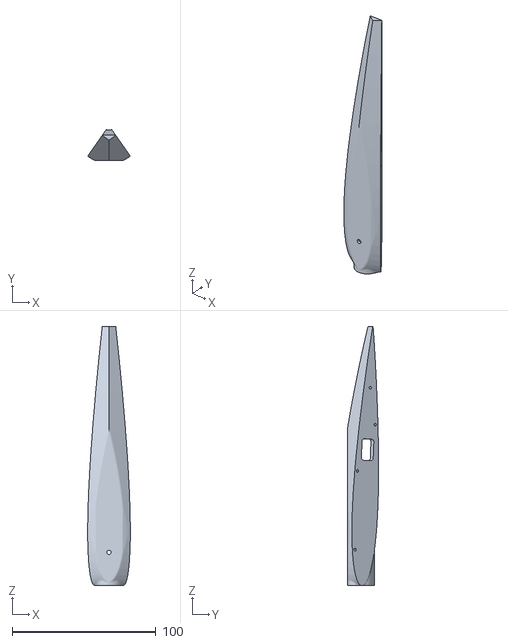
[picture p176: CAD file, 2025-06-06]
SolidWorks/STL/Vtail_Mid.STL
29.7 x 21.7 x 180.0
