metinoxy/VTOL/SolidWorks/Analysis Parts/cfd_montage.SLDASM

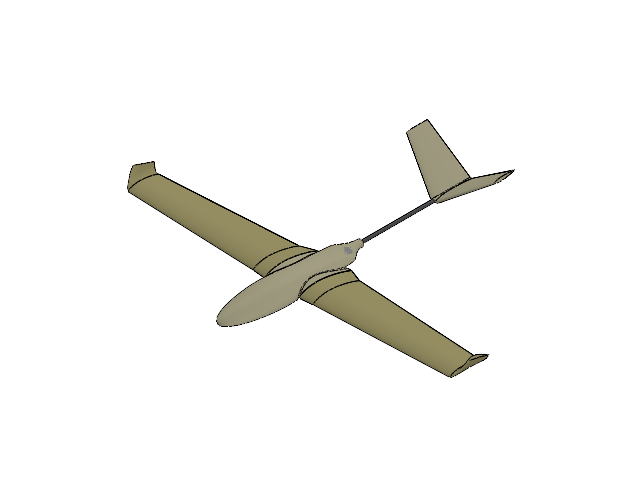
[picture p177: CAD file, 2024-12-17]
SolidWorks/Analysis Parts/cfd_montage.SLDASM
Fuselage_v0_cfd
Wing_v0_cfd
CFRP_Tube_12-10-500
Vtail_v0_cfd
