metinoxy/VTOL/SolidWorks/Electronics/Servo_Cap_Montage.SLDASM

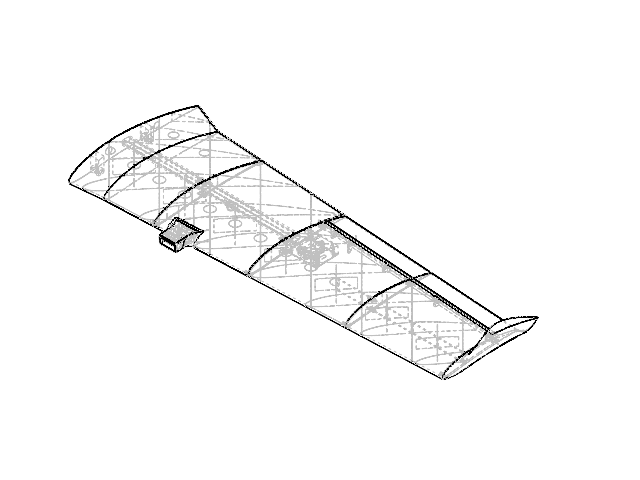
[picture p178: CAD file, 2025-03-08]
SolidWorks/Electronics/Servo_Cap_Montage.SLDASM
Wing_Servo_Cap_v1
Servo_MG90S
SG90 - Micro Servo 9g - Tower Pro.2
Wing_v3
Aileron
Aileron_Hinge x 3
Control_Horn
