metinoxy/VTOL/SolidWorks/Montage_v1.SLDASM

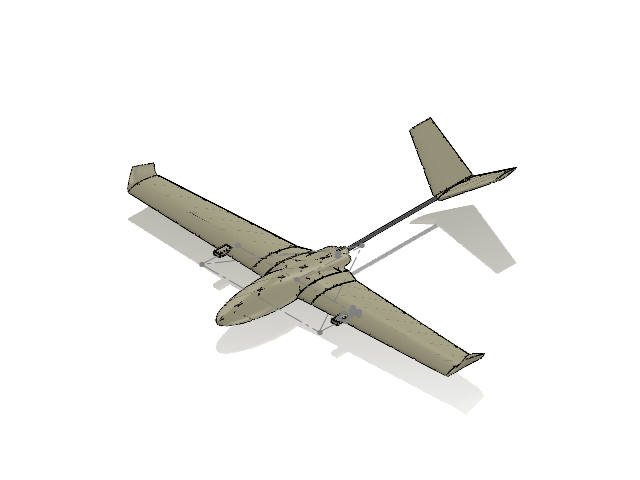
[picture p179: CAD file, 2024-12-17]
SolidWorks/Montage_v1.SLDASM
Fuselage_v2
Wing_v1
CFRP_Tube_12-10-500
Vtail_v2
