metinoxy/VTOL/(list of files, cad)

Other CAD files:
SolidWorks/Tilt Mechanism v2/AynalamaTilt_Montage_v2.SLDASM
SolidWorks/Electronics/AynalamaServo_MG90S.SLDPRT
SolidWorks/Tilt Mechanism v2/AynalamaTilt_Mount.SLDPRT
Usable Docs/stallion-vtol.SLDPRT
SolidWorks/Electronics/AynalamaSG90 - Micro Servo 9g - Tower Pro.2.SLDPRT
SolidWorks/Tilt Mechanism v2/AynalamaES09MD.SLDPRT
SolidWorks/AynalamaCS_Hinge.SLDPRT
SolidWorks/Electronics/AynalamaControl_Horn.SLDPRT
SolidWorks/Tilt Mechanism v2/AynalamaArm.SLDPRT
SolidWorks/Analysis Parts/Fuselage_v0_cfd.SLDPRT
SolidWorks/AynalamaWing_Aileron.SLDPRT
SolidWorks/Mirror_Wing.SLDPRT
SolidWorks/Tilt Mechanism v2/AynalamaES09MD_ARM.SLDPRT
SolidWorks/Tilt Mechanism v2/Aynalamapropeller.SLDPRT
SolidWorks/STL/Vtail_L_ServoCap.STL
SolidWorks/Tilt Mechanism v2/Arm.SLDPRT
SolidWorks/STL/Tilt_Mount.STL
SolidWorks/STL/Wing_L_ServoCap.STL
SolidWorks/STL/Ruddervator_L.STL
SolidWorks/Analysis Parts/cfd_montage.SLDPRT
SolidWorks/Old Versions/Tilt Mechanism v1/ISO 7045 - M3 x 16 - Z - 16C.SLDPRT
SolidWorks/Old Versions/Tilt Mechanism v1/Part3.SLDPRT
SolidWorks/Old Versions/Tilt Mechanism v1/Part4.SLDPRT
SolidWorks/Old Versions/Tilt Mechanism v1/motor/SOLIDS/BEARING.sldprt
SolidWorks/Old Versions/Tilt Mechanism v1/motor/SOLIDS/MAGNETS ADHESIVE.SLDPRT
SolidWorks/Old Versions/Tilt Mechanism v1/motor/SOLIDS/MAGNETS.SLDPRT
SolidWorks/Old Versions/Tilt Mechanism v1/motor/SOLIDS/MOTOR WIRES.SLDPRT
SolidWorks/Old Versions/Tilt Mechanism v1/motor/SOLIDS/ROTOR RS2306.SLDASM
SolidWorks/Old Versions/Tilt Mechanism v1/motor/SOLIDS/SCREW.SLDPRT
SolidWorks/Old Versions/Tilt Mechanism v1/motor/SOLIDS/SHAFT RS2306.SLDPRT
SolidWorks/Old Versions/Tilt Mechanism v1/motor/SOLIDS/STATOR RS2306.SLDPRT
SolidWorks/Old Versions/Tilt Mechanism v1/motor/SOLIDS/STATOR SLEEVE.SLDPRT
SolidWorks/Old Versions/Tilt Mechanism v1/motor/SOLIDS/WASHER.SLDPRT
SolidWorks/Old Versions/Tilt Mechanism v1/motor/SOLIDS/WINDING.SLDPRT
SolidWorks/Old Versions/Tilt Mechanism v1/pan head cross recess screw_iso.SLDPRT
SolidWorks/Old Versions/Vtail_v2.SLDPRT
SolidWorks/Old Versions/Vtail_v3.SLDPRT
SolidWorks/Technical Drawings/Rear_Motor_Mount_v1.SLDDRW
SolidWorks/Technical Drawings/V-Tail_v2.SLDDRW
SolidWorks/Technical Drawings/Wing_v1.SLDDRW
SolidWorks/Technical Drawings/Wing_v2.SLDDRW
SolidWorks/Tilt Mechanism v2/EMAX RS2205 S/SCREW.SLDPRT
SolidWorks/Tilt Mechanism v2/EMAX RS2205 S/WASHER.SLDPRT
