metinoxy/VTOL/Usable Docs/Tensile failure strength and separation angle of FDM 3D printing PLA materials - experimental and theoretical analyses.pdf

T ensile failure strengthT andT separationT angleT of FDM 3DT printing PLA

material:TexperimentalTandTtheoreticalTanalyses

Tianyun Yaoa,b, Juan Yea,b, Zichen Denga,b,*, Kai Zhanga,b,**, Yongbin Maa,b 3 | , Huajiang

Ouyangc 4

a 5 SchoolTofTMechanics,TCivilTEngineeringTandTArchitecture,TNorthwesternTPolytechnicalTUniversity,TXi’an

710072,TP. R.TChina

b MIIT Key Laboratory of Dynamics and Control of Complex Systems, NorthwesternT PolytechnicalT

University,TXi’anT710072,TP. R.TChina

c 9 School of Engineering, University of Liverpool, Liverpool L69 3GH, UK

* CorrespondingTauthor.

**TCorrespondingTauthor.

E-MailTaddress: dweifan@nwpu.edu.cn(ZichenTDeng);Tkzhang@nwpu.edu.cn(KaiTZhang)

Abstract

It is discovered in this investigation that there exist two different failure modes and a special

separation angle which is the demarcation point of the two different failure modes when FDM

(Fused Deposition Modelling) 3D printing materials fail under a tensile load. In order to further

understand the mechanical properties of FDM 3D printing materials and promote the use of

FDM 3D printing materials, their tensile failure strengths at different printing angles and

separation angles are measured and analysed theoretically. A new separate-modes of

transversely isotropic theoretical failure model is established to predict the tensile failure

strength and separation angle of FDM 3D printing PLA (polylactic acid) material based on the

hypothesis of transverse isotropy and the classical separate-modes failure criterion. During this

research, the tensile specimens designed according to the current test standard ISO (527-2-2012)

for plastic-multi-purpose specimens are fabricated in 7 different printing angles (

0 , 15 , 30 ,

45 , 60 , 75 , 90
) and three levels of printing layer thickness (0.1 mm, 0.2 mm, 0.3 mm).

Experimental results show that the tensile failure strength increases with the increase of the

printing angle or the decrease of the layer thickness. Meanwhile, inter-layer failure tends to

occur when the printing angle is small and in-layer failure tends to occur when the printing

29 | angle is big. In comparison with the results predicted by the established theoretical model, all
30 | values of the Generalized-Relative-Root-Mean-Square Error are close to zero and the
31 | experimental separation angles are also between
| 45 and 60 . So the predictive capacity of
32 | the theoretical model is affirmed by experimental results.
33 | GraphicalTAbstract

34

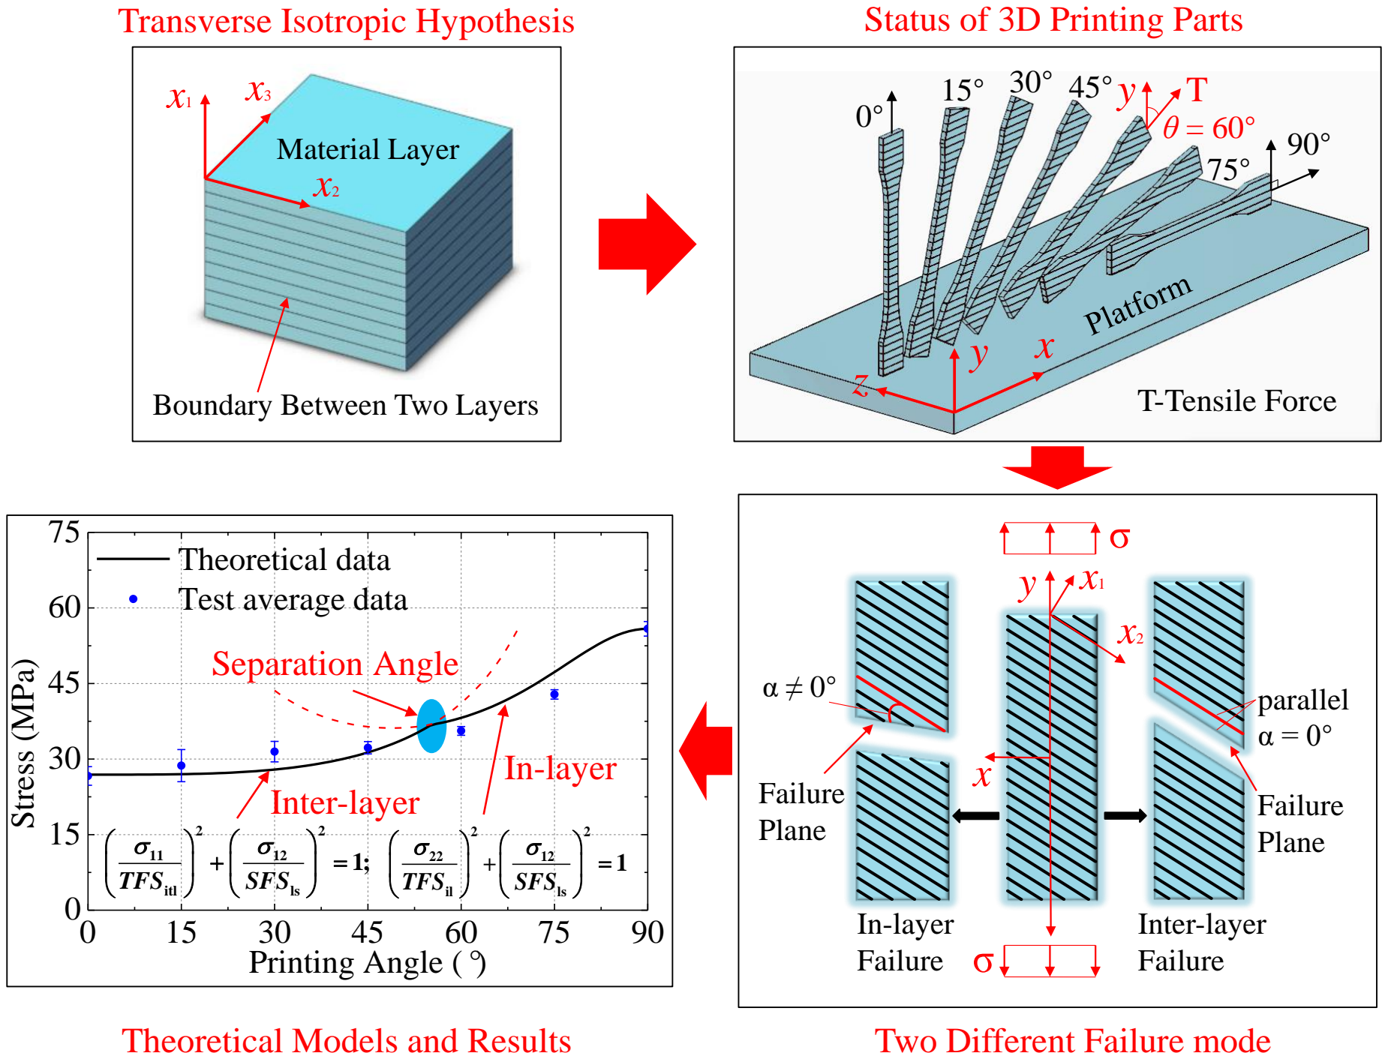
[picture p180: figure]
Transverse Isotropic Hypothesis; Status of 3D Printing Parts; Theoretical Models and Results; Two Different Failure mode; Material Layer; Boundary Between Two Layers; T-Tensile Force; Failure Plane; In-layer Failure; Inter-layer Failure; parallel α = 0°; Printing Angle (°); itl; 1; TFS; SFS; TFS; In-layer; Inter-layer; Separation Angle

35 | Keywords: 3D printing; tensile failure strength; separation angle; failure criterion; printing
36 | angle; layer thickness
37 | 1. Introduction
38 | One area of great progress in manufacturing science and engineering is the rapid
39 | development of 3D printing technology in the past two decades [1-4]. Combining Computer
40 | Aided Design (CAD) and Computer Aided Manufacturing (CAM) technologies, 3D printing
41 | technology fabricates items without involving any traditional cutting techniques and the waste
42 | of raw materials caused in this process is also very little [5, 6]. For manufacturing thin-walled
75 | Theoretical data Test average data Stress ⁽MPa⁾

structures, complex structures [7, 8] and multi-material structures [9, 10], this technology has

inherent advantages [11-13]. Nowadays, 3D printing technology has been widely applied in

manufacturing [14], civil engineering [15, 16], automotive engineering [17], biomedical

engineering [18-21], food [22-24], clothing [25] and so on.

Fused Deposition Modelling (FDM) is a widely-used 3D printing technology for polymer

and composite filaments due to its flexible and rapid printing process, low cost, diversity and

non-toxicity of materials, high strength and toughness of materials. A schematic diagram of

FDM 3D printing technology is shown in Fig. 1 and the printing process can be described as

follows. A digital 3D model should be built in CAD software and stored as a stereolithography

(STL) format file. Then a slicing software module is used to slice the 3D model into thin layers

horizontally and control the FDM machine. Printing parameters including printing speed, layer

thickness, printing temperature, filling rate, printing orientation, support structure and so on are

all set in the slicing software. During the modelling process, a printing filament is extruded into

the nozzle at semi-liquid state and deposited onto the previous material layer shown in Fig. 1.

After the new material layer solidifies on the printing object at room temperature, the printing

platform with the printing item moves down by the height of one material layer and then the

next material layer will be printed. This process will continue until the entire model has been

printed. At last, the support structure will be removed manually. Considering the fabrication

process, a FDM 3D printing item can be simplified as a transversely isotropic material and the

plane of transverse isotropy is the material layer plane.

63

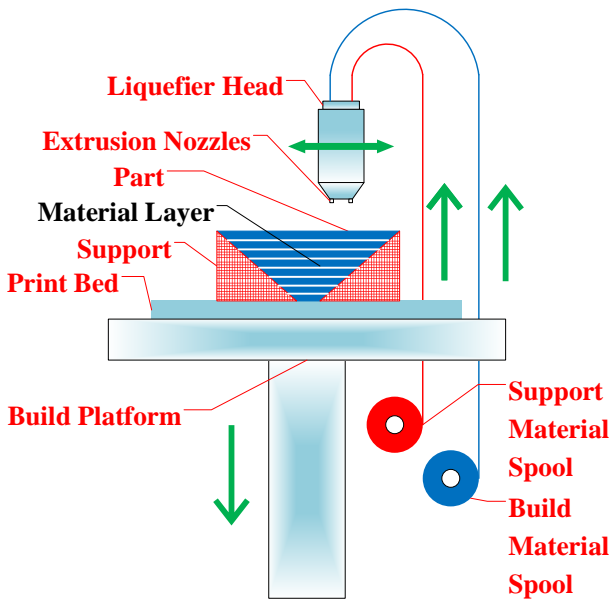
[picture p181: figure]
Liquefier Head; Extrusion Nozzles Part; Support Print Bed; Build Platform; Material Layer

64 | Fig.T1. Schematic diagram of FDM 3D printing technology.
65 | As a new fabricating process for a new class of materials, one shortcoming of this 3D
66 | printing technology is that the mechanical properties are still unclear, and the constitutive
67 | models and strength models dedicated for FDM 3D printing materials are not yet available.
68 | Thus actual FDM 3D printing structures cannot be modelled and analysed accurately. This lack
69 | of knowledge has seriously hindered the development and application of FDM 3D printing
70 | technology and calls for its research. The research on the mechanical properties of FDM 3D
71 | printing materials has mainly focused on two aspects: failure strengths [26] and elastic
72 | properties. Among them, there has been more research on their elastic properties. However, the
73 | research on their failure strength is still rare.
74 | The research on failure strength of 3D printing materials can be roughly divided into 3
75 | categories. Qualitative parametric analysis is the first and most common one. Chacón et al. [27]
76 | did tests and analysed the influences of parameters including building orientation, layer
77 | thickness and feed rate on the tensile strength and bending strength. They found that layer
78 | thickness and feed rate had a negative correlation with the two strengths. On the other hand,
79 | building orientation had an obvious influence on the two strengths. Tanikella et al. [28]
80 | investigated the tensile strength for a wide range of 3D printing materials. The results
81 | demonstrated that the tensile strength of 3D printing specimens depended largely on the mass
82 | of the specimen, for all materials. Sood et al. [29] evaluated the relationship between the

# Support Material Spool Build Material Spool

parameters including layer thickness, orientation, raster angle, raster width and air gap and

tensile, flexural and impact strength. Empirical models relating mechanical responses and

process parameters were developed. Croccolo et al. [30] studied the effects of FDM production

parameters on the tensile failure strength and the stiffness of the materials. An empirical

analytical model was developed based on the process parameters. García-Plaza et al. [31]

established a mathematical modelling to analyse the effect of printing parameters including

building orientation, layer thickness, feed rate, and plate-extruder movements on the

dimensional accuracy, flatness error, and surface texture of 3D printing PLA parts. Other

parametric analyses [32-37] have also been done in the past decades. All of the above studies

mainly focused on the influences of printing parameters on failure strength of 3D printing

materials. Only some empirical models and qualitative results were obtained during these

research.

Secondly, some theoretical failure models have been built to predict the failure strength of

3D printing materials. Zhang et al. [38] established a theoretical model based on Tsai-Wu failure

criterion [39] to predict the macroscopic failure of 3D printing glassy polymers and the model

was applied to simulate the failure of 3D printing lattice structures. Ahn et al. [40] developed

an anisotropic failure model of tensile strength as a function of raster angle by Tsai-Wu failure

criterion [39]. A failure criterion for anisotropic materials that incorporated stress interactions

was implemented to predict the failure strength of 3D printing materials by Obst et al [41].

Theoretical results showed that the failure of 3D printing parts was strongly influenced by the

interaction between stresses and there were significant differences between tensile and

compressive strengths. The theoretical failure models mentioned above only have the ability to

roughly represent the experimental data without considering the specific experimental

phenomena.

Thirdly, the strength of multi-materials and structures fabricated by 3D printing technology

has also been investigated. Ning et al. [42] experimentally researched the effect of raster angle,

infill speed, nozzle temperature and layer thickness on the tensile strength of carbon fibre-

reinforced plastic composites (CFRP). These 4 factors had a significant impact on the tensile

strength of CFRP. Caminero et al. [43] investigated the effect of graphene nanoplatelet

reinforcement on the mechanical properties, dimensional accuracy, and surface texture of 3D printed PLA structures. The 3D printed PLA-Graphene composite samples showed higher

tensile strength, flexural strength, and inter-laminar shear strength than 3D printed PLA, and

PLA 3D850 samples. Ulu et al. [44] experimentally studied the influence of printing orientation

on the performance of 3D printing structures. An optimization algorithm was used to identify

the build orientation that maximized the factor of safety (FS) of a structure under prescribed

loading and boundary configurations.

Obviously, two problems exist in the previous research. Firstly, only qualitative results have

been obtained in most previous parametric analyses of FDM 3D printing materials. Meanwhile,

the empirical models constructed are rarely based on a mechanics principle. Secondly,

theoretical models were only established on rough experimental phenomena and did not clearly

classify the tensile failure modes of these materials. An accurate prediction of tensile failure

strength (TFS) is very important for analysing the structures fabricated by FDM 3D printing

technology, for the sake of structural safety. In order to promote and develop the 3D printing

technology, a quantitative theoretical failure model which is consistent with experimental

phenomena and based on experimental data is urgently needed.

A large number of experimental results obtained during this investigation demonstrate that

there are two different failure modes, inter-layer failure mode and in-layer failure mode, when

the FDM 3D printing PLA material fail. In addition, a special separation angle which is the

demarcation point of the two different failure modes exist during the failure experiment.

Therefore, a separate-modes of transversely isotropic theoretical failure model is established to

predict the TFS and separation angle of the FDM 3D printing PLA material based on the

hypothesis of transverse isotropy and classical separate-modes failure criterion [45]. The

influence of printing angles and layer thickness on TFS is measured and analysed by tensile

experiments and the parameters of the theoretical model is amended and improved based on the

test data. At last, a modified theoretical failure model is obtained which can accurately predict

the TFS with different printing angles and layer thickness and can approximately predict the

range of the separation angle with different layer thickness.

The remainder of this paper is outlined as follows. Fabrication of specimens, tensile

experiment and phenomena of experimental results are described in Section 2. The separate-

modes of transversely isotropic theoretical failure model and the model in plane stress state are established in Section 3. The detailed calculation process of separation angle show in Section

4. The approximate range of the separation angle and the TFS comparison between the

theoretical data and experimental data have been analysed thoroughly in Section 5. Four

conclusions of this paper are drawn in Section 6.

2. Procedures of experiment
2.1. Fabrication of 3D printing specimens
2.1.1. Material and 3D printing machine

The testing material used during this research is polylactic acid (PLA) which is an

amorphous, durable, strong thermoplastic, healthy and pollution-free material with excellent

printing capability. Therefore, it is one of the most commonly used materials in 3D printing.

The PLA filaments used are produced by Polymaker Industries (Shanghai, China) and their

properties are given in Table 1.

ableT1 Properties of PLA filament.

Property | Typical value
Average Filament Diameter (mm) | 1.75 0.05 ±

Recommended Printing Temperature ( C

) | 195 230

Softening Temperature ( C

) | 146 150
Recommended Printing Speed (mm/s) | 40 90

Density (g/cm³ at 21.5 C
) | 1.17 1.24
Recommended Heated Build Platform Temperature | Not Required

Desktop 3D printer (Makerbot Industries, Brooklyn, USA) is used to fabricate the test

specimens. 3D printing software is used to control the printing parameters including printing

angle, printing speed, temperature and so on. Printing temperature is set to 215

C , which is

suitable for the PLA filaments. The printable layer thickness is

0 05 . ~ 12. mm. Considering

the printing speed and mechanical properties, 3 levels of layer thickness are chosen in this

research: 0.1 mm, 0.2 mm and 0.3 mm.

162 | 2.1.2. Printing dimension and states of specimens
163 | The dimension of these 3D printing specimens follows ISO 527-2-2012 (International
164 | standard, plastics determination of tensile properties Part 2: Test conditions for moulding and
165 | extrusion plastics), which is shown in Fig. 2. The total number of specimens used during this
166 | research is 84 and the details are given in Table 2.

167

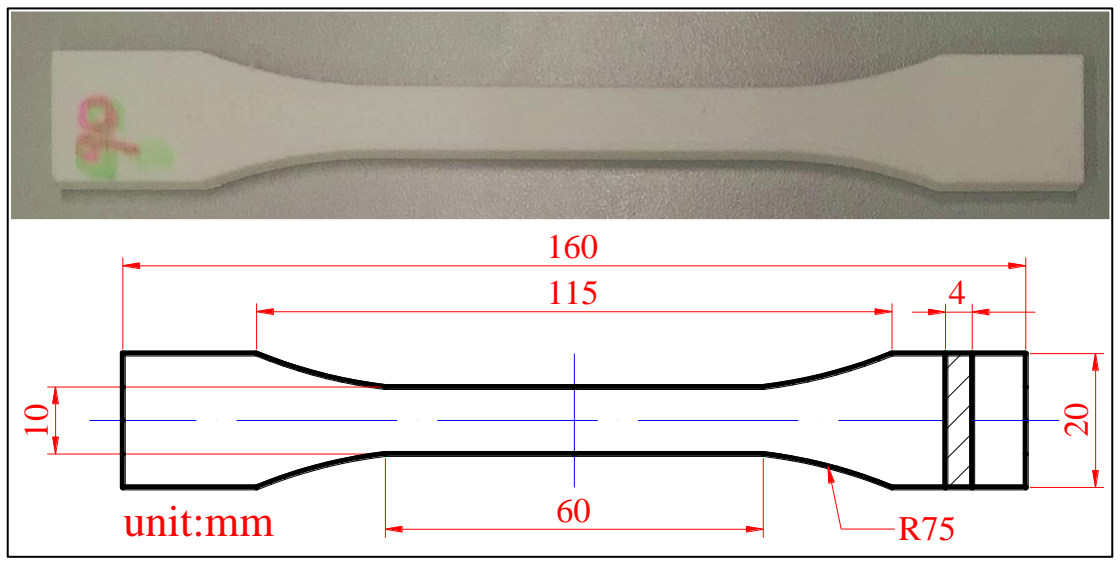
[picture p182: figure]
unit:mm

168 | Fig.T2. The dimension of 3D printing specimens.
169 | ableT2 The numbers of specimens used during this research.

Printing Angle (°)

0 | 15 | 30 | 45 | 60 | 75 | 90

Layer thickness = 0.1 mm

4 | 4 | 4 | 4 | 4 | 4 | 4

Layer thickness = 0.2 mm

4 | 4 | 4 | 4 | 4 | 4 | 4

Layer thickness = 0.3 mm

4 | 4 | 4 | 4 | 4 | 4 | 4
170 | Based on previous research results and the forming process of FDM materials (layer by
171 | layer), the 3D printing material produced in this research project is modelled as being
172 | transversely isotropic. In order to understand the effect of printing angle on TFS of the material,
173 | these specimens are fabricated with 7 printing angles (2 angles of

0
| | | | | and

90
| | | | | | for on-axis
174 | specimens; 5 angles of

15 , 30 , 45 , 60 , 75
for off-axis specimens), respectively. The on-axis specimens are used to test the inter-layer TFS while the

90
on-axis specimens are

used to test the in-layer TFS. Off-axis specimens are used to verify the new theoretical failure

model established during this research. The printing states and printing angles are shown in Fig.

3. Here, the printing angle is defined as the angle between the direction that is perpendicular to

the material layers and the direction of the tensile load to be applied onto the specimens in the

tests. The hatched lines in Fig. 3 represent the boundary between two material layers.

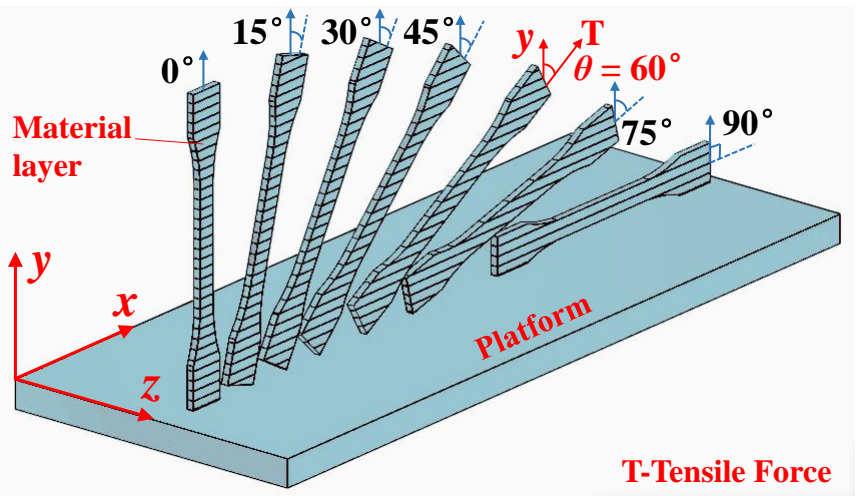
[picture p183: figure]
T-Tensile Force; Material layer

Fig.T3. The printing status and angles of specimens.

In order to ensure the printing quality of the specimens while considering the problem of

excessively high hanging angle during the printing process, sufficient support structures are

preset in the printing software. The support structures (SS) are illustrated in Fig. 4.

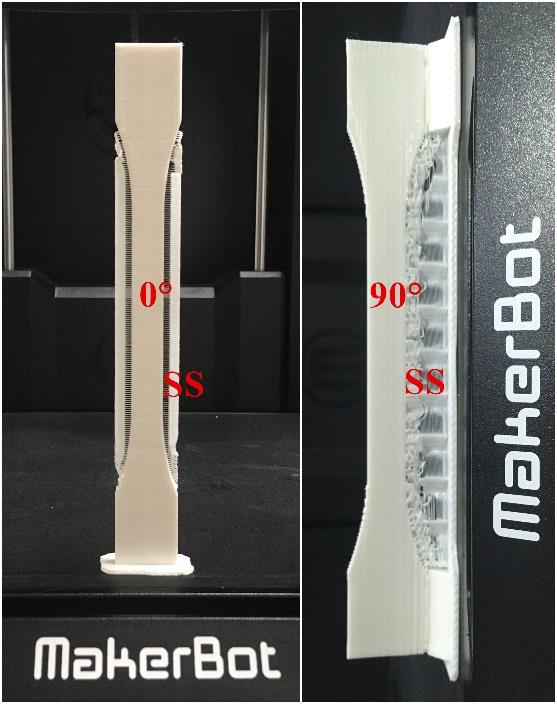
[picture p184: figure]

(a) Support structures of on-axis specimens.

188

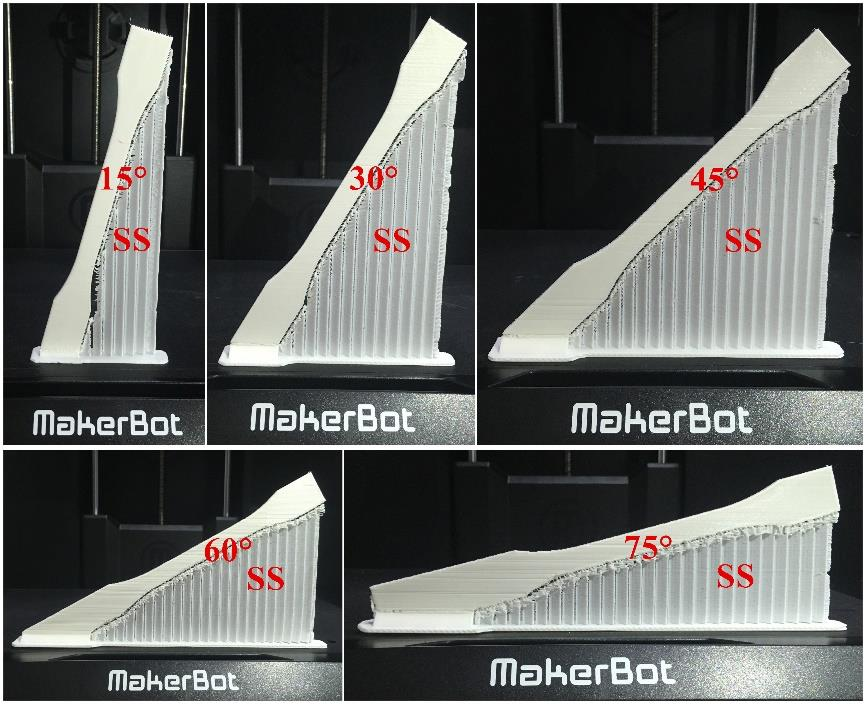
[picture p185: figure]

189 | (b) Support structures of off-axis specimens.
190 | Fig.T4. Support structures of 3D printing specimens.
191 | 2.2. Uniaxial tensile experiment of specimens
192 | Quasi-static uniaxial tensile tests are performed on the computer-controlled electronic
193 | universal tensile machine provided by Changchun Institute of Mechanical Science China. In all
194 | the quasi-static tensile tests the specimens are stretched at a constant speed of 0.1 mm/min and
195 | at room temperature kept at 23 C . So the experiment condition is standard. The test machine
196 | and one of the specimens are shown in Fig. 5.

197

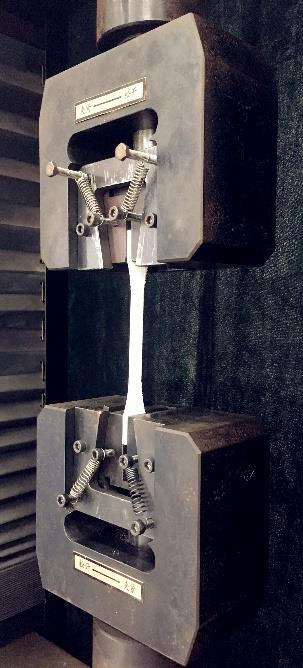
[picture p186: figure]

198 | Fig.T5. The tensile machine and specimens under testing.

2.3. Phenomena of experimental results

Before analysing phenomena of the experiment results, two failure modes should be

defined, inter-layer failure mode and in-layer failure mode, which are illustrated in Fig. 6. An

inter-layer failure mode occurs when fracture appears at the interface between two adjacent

material layers and the material layers remain intact after failure, and the angle

α
between

the failure surface and the material layers is

0 . An in-layer failure mode occurs when material

layers break and the angle

α
between the failure surface and the broken material layers is not

equal to

0 .

Test results for 3 different layer thicknesses (0.1 mm, 0.2 mm, 0.3 mm) are shown in Fig.

7. All failure features are shown in an enlarged form. So both inter-layer failure mode and in-

layer failure mode can be easily seen in this figure.

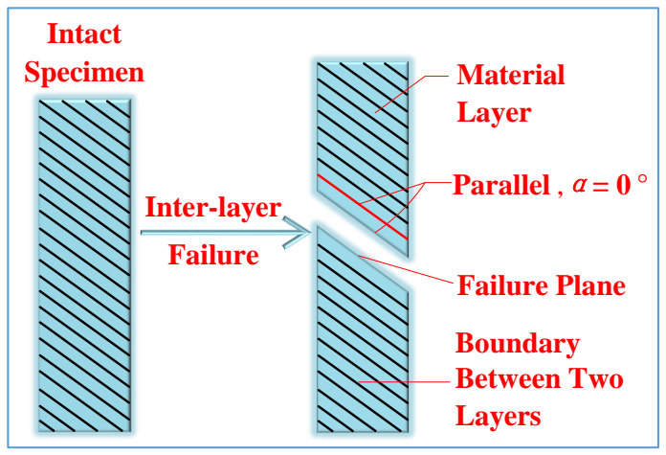
[picture p187: figure]
Inter-layer Failure; Material Layer; Parallel ,α= 0°; Intact Specimen

(a) Inter-layer failure mode.

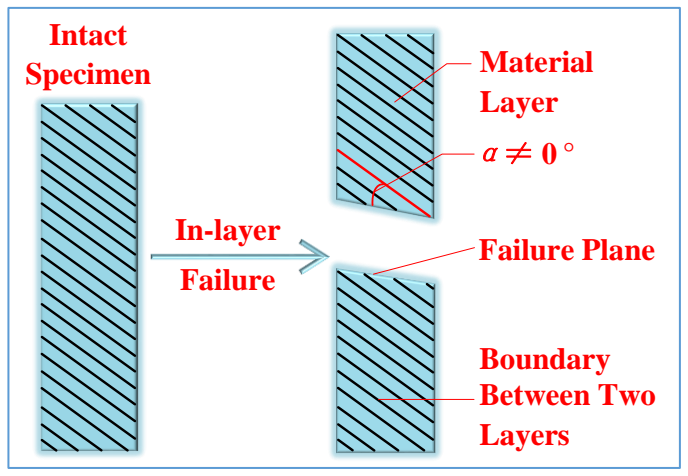
[picture p188: figure]
Intact Specimen; In-layer Failure; Material Layer α 0°; Failure Plane; Boundary Between Two Layers

(b) In-layer failure mode.

Fig.T6. Schematic of inter-layer failure mode and in-layer failure mode.

Failure Plane Boundary Between Two Layers

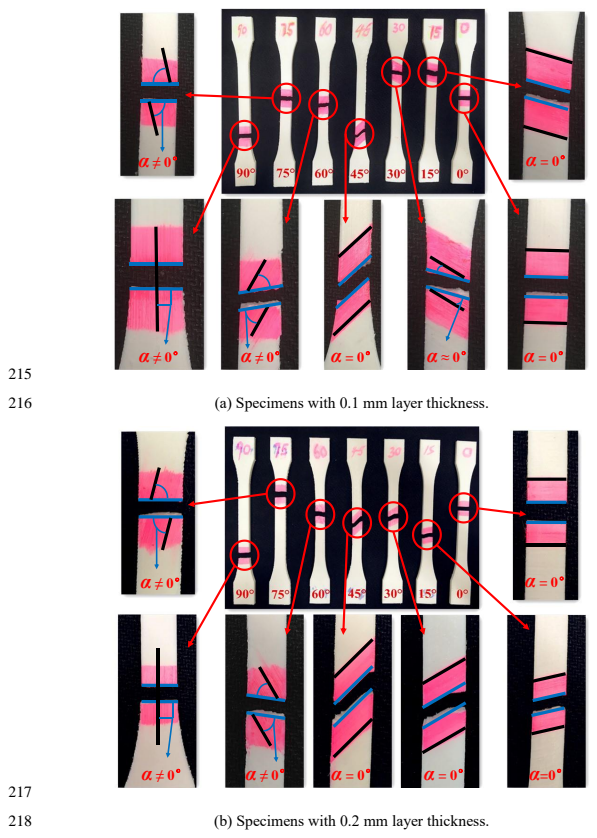
[picture p189: page 12]
(a) Specimens with 0.1 mm layer thickness.; (b) Specimens with 0.2 mm layer thickness.

219

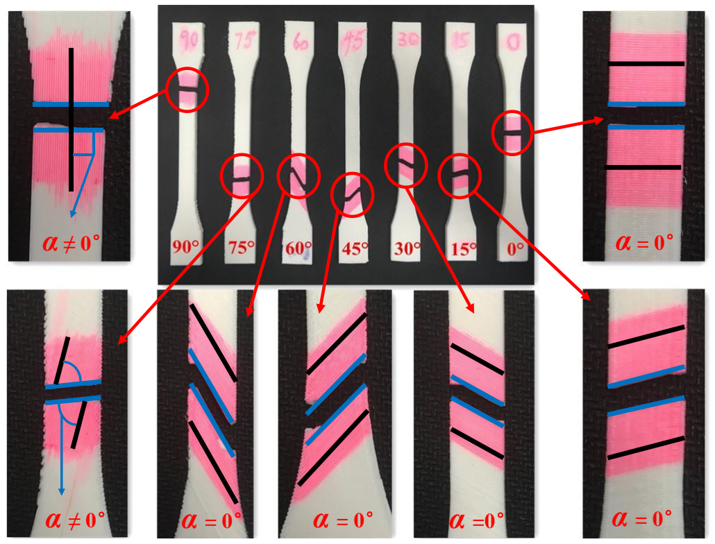
[picture p190: figure]

220 | (c) Specimens with 0.3 mm layer thickness.
221 | Fig.T7.TFailure features and details of specimens with 3 different layer thicknesses.
222 | 3. Theoretical model
223 | 3.1. Separate-modes of transversely isotropic failure model
224 | 3.1.1. Quadratic failure model for transversely isotropic materials
225 | Usually a quadratic failure criterion of isotropic materials is formulated in terms of the
226 | stress invariants. The invariants of stress tensor for isotropic materials are given below.

i
227

I
1 | 11 | 22 | 33
=σ σ σ + | +
(1)
i | | | | | | | 2 | 2 | 2
2 | 11 | 22 | 22 | 33 | 33 | 11 | 12 | 23 | 31

228

I = | · | + | · | + | · | - | - | - σ σ | σ σ σ σ σ σ σ
(2)
i | | | | | | | | 2 | | 2 | | 2
3 | 11 | 22 | 33 | 12 | 23 | 31 | 11 | 23 | 22 | 31 | 33 | 12

229

I = | · | · | + | · | · | - | · | - | · | - | · σ σ σ | σ σ σ σ σ | σ σ σ σ 2
(3)

230 where all the stresses in Eq. (1) ~ Eq. (3) are shown in Fig. 8. Superscript i

in Eq. (1) ~ Eq.

231 | (3) represents isotropic materials.
232 | As explained before, FDM 3D printing materials can be simplified as transversely isotropic
233 | materials with respect to the building direction of material layers. Here, a 3D rectangular

coordinate system is defined, with
2

x
and
3

234

x
being the two perpendicular axes in the plane

of the material layers, and
1

235

x normal to this plane, as shown in Fig. 8. For transversely

isotropic materials, the failure model must be invariant under any rotation of the
2

x
and
3

236

x

axes around
1

x
. Therefore, a function of stress invariants under rotation around
1

237

x is

238 | constructed for this special failure model. The stress invariants used in the special failure model
239 | can be expressed as follows.

ti
1 | 11

240

I =σ
(4)

ti
241

I
2 | 22 | 33

=σσ+
(5)
( | )
2 t i | 2 | 2
3 | 23 | 22 | 33 | 22 | 33 | 23

1
or
4

242

I | = | - | · | - | + σ | σ σ | σ | σ | σ
(6)
t i | 2 | 2
4 | 12 | 13

243

I = + σσ
(7)
t i | 2 | 2
244

I
5 | 12 | 23 | 13 | 22 | 13 | 33 | 12 =2σ σ σ | σ σ | σ σ · | · | - | · | - | ·
(8)

245 Eq. (4) ~ Eq. (8) are obtained based on Eq. (1) ~ Eq. (3) and transverse isotropy. Superscript

246
t ~ i

in the Eq. (4) ~ Eq. (8) represents transversely isotropic materials.

247 | The one-dimensional uniaxial TFS and shear failure strength (SFS) of FDM 3D printing
248 | materials are given below.

TFSitl
- the maximum of

σ11
249 | in Fig. 8 - inter-layer TFS in the direction that is perpendicular
250 | to the material layers.

TFSil
- the maximum of

σ nn
251 | in Fig. 8 - in-layer TFS in transversely isotropic material layers.
ls SFS | - the maximum of

σ n1
252 | in Fig. 8 - shear failure strength in the plane that is
253 | perpendicular to the material layer (longitudinal shear).

ts SFS - the maximum of
σ nt
254 | in Fig. 8 - shear failure strength in the plane that is parallel to
255 | the material layer (transverse shear).

Considering a quadratic approximation (which will be shown to be quite accurate),

ti
5

256

I

257 should not appear in the failure model. Therefore, the general quadratic approximation of failure

258 | for transversely isotropic materials can be expressed as,
( ) | ( )
2 | 2 t i | t i | t i | t i | t i | t i | t i | t i
1 | 1 | 1 | 1 | 2 | 2 | 2 | 2 | 12 | 1 | 2 | 3 | 3 | 4 | 4

259

e I | f I | e I | f | I | g | I | I | e I | e I · | + · | + · | + | · | + | · | · | + · | + · | =1
(9)

where
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
f and
12

260

g | are the parameters which need to be determined
261 | thereinafter.
262 | Combining Eq. (4) ~ Eq. (7) and Eq. (9), the following equation can be obtained under pure
263 | transverse shear condition.
3 | 2 ts

1
e =
SFS
264 | (10)
265 | Combining Eq. (4) ~ Eq. (7) and Eq. (9), the following equation can be obtained under pure
266 | longitudinal shear condition.
4 | 2 ls

1
e =
SFS
267 | (11)
268 | The phenomena of experimental results show that there are two failure modes: inter-layer
269 | failure mode and in-layer failure mode. These two failure modes have been defined in detail in
270 | Section 2.3, which can also be seen in Fig. 8.

271

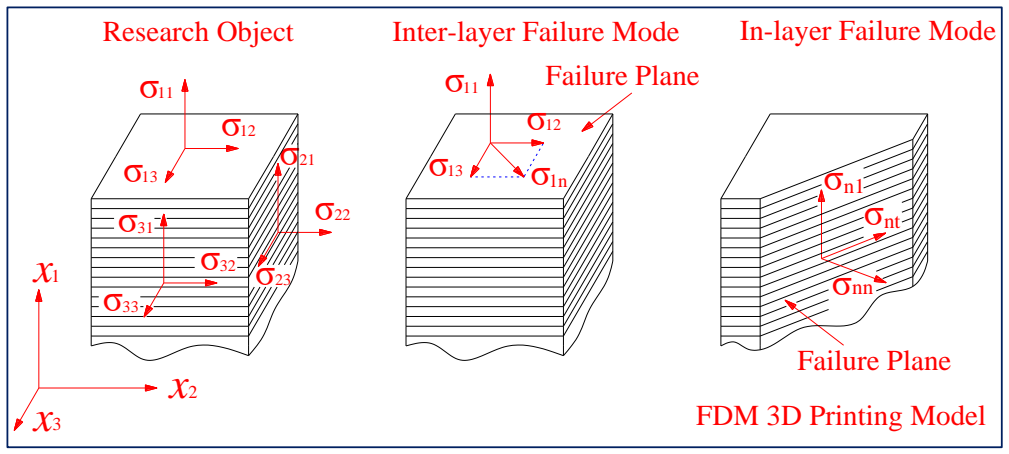
[picture p191: figure]
Failure Plane; FDM 3D Printing Model; In-layer Failure Mode; Inter-layer Failure Mode; σnn; Research Object; σnt

272 | Fig.T8.TSchematic of failure modes and failure plane.
273 | 3.1.2. Inter-layer failure mode
274 | It is assumed that the failure is caused by the tensile normal stress and shear stresses on the
| failure plane. For the inter-layer failure mode, the failure plane is
| 2

x - 3
275

x
plane. Therefore,

stresses

σ11
(

11 σ > 0
),

σ12
and

σ13
276 | are considered to result in the inter-layer failure.

277 | Combining this assumption and Eq. (9) ~ Eq. (11), the inter-layer failure model can be obtained
278 | as follows.
2 | 2
2 | 12 | 13
itl | 11 | itl | 11 | 2 ls
e | f + | 1
SFS
σ | σ
σ | σ

+
279
- | · | + | =
(12)

where the parameters have been defined in detail in Section 3.1.1 and Fig. 8. Only

itl e
and
itl

280

f

281 | need to be found. A one-dimension uniaxial tensile test can only determine one of the two
282 | parameters. Therefore, failure data under a combination of stresses are needed to establish the
283 | additional equation for this problem. A large number of experimental data [46-48] have shown
| that linear term itl
284
e

has a very small influence on tensile failure of polymers or composite

materials under a quasi-static load and the patterns of failure curves of stresses

σ11
and 285

σ12

(or

σ13
) are in convex shapes. Therefore, an elliptic equation of

σ11
and

σ12
(or

σ13
286 | ) can
287 | be used to approximate this tensile failure relationship. With this approximation, the simplified
288 | form of Eq. (12) is given below.
2 | 2
2 | 12 | 13
itl | 11 | 2
ls
f | 1
SFS

σ σ
σ

+
289
- | + | =

(13)

Under these condition, a one-dimension uniaxial tensile test can be used to determine
itl

290

f .

291 Thus, Eq. (13) can be reduced to,

2
| 2 | 2
11 | 12 | 13
2
itl | ls

1
TFS | SFS
æ | ö σ | σ | σ+
ç | ÷ + | =
è | ø
292 | (14)

where parameters of

itl TFS
and

ls SFS
have been defined in detail in Section 3.1.1 and
| σ11
293 | ,

σ12
, 294

σ13
have been defined in detail in Fig. 8.
295 | 3.1.3. In-layer failure mode
296 | Modelling of the in-layer failure mode is more complicated, since the failure plane is not
297 | known in advance. Experimental results obtained during this research show that most of the
298 | failure planes of the in-layer failure mode are approximately perpendicular to the material layer.
299 | Therefore, a simple case in which the failure plane is perpendicular to the material layer is
300 | studied in depth during this research. Again, it is assumed that the failure is caused by the tensile

301 normal stress and shear stresses on the failure plane. The failure plane is shown in Fig. 8. As

defined in Section 3.1.2, stresses

σ nn
(

nn σ > 0
),

σ nt
and

σ n1
302 | are considered to result in
303 | the in-layer failure. Combining this assumption and Eq. (9) ~ Eq. (11), the in-layer failure model
304 | can be derived as,
( | ) | ( | )
2 | 2 | 2
2 | 23 | 22 | 33 | 12 | 13
il | 22 | 33 | il | 22 | 33 | 2 | 2
| | | | | | ts | ls
e | f + | + | + | + | + | 1
SFS | SFS
σ | σ σ | σ | σ
σ | σ | σ | σ
- +
305
- | · | =
(15)

where the parameters have been defined in detail in Section 3.1.1 and Fig. 8. Also only
il

306

e
and

il

307

f
need to be found in the above equation. A one-dimensional uniaxial tensile test can only
308 | determine one of the two parameters. Therefore, failure data under a combination of stresses
309 | are needed to establish the additional equation for this problem. A large number of experimental
| data [46-48] have shown that the linear term il
310
e

has a very small influence on tensile failure

311 of polymers or composite materials under a quasi-static load and the patterns of failure curves

of stress

σ nn
and

σ nt
(or

σ n1
312 | ) are in convex shapes. Therefore, with the same
313 | approximation in Section 3.1.2, the simplified form of Eq. (15) is given below.

2
| | 2 | | 2 | 2
22 | 33 | 23 | 22 33 | 12 | 13
2 | 2
il | ts | ls

+
+ | + | 1
TFS | SFS | SFS
æ | ö σ σ | σ | σ σ | σ | σ - | + ç | ÷ | =
è | | | | | | | ø
314 | (16)

where parameters of

TFSil
, | ts SFS
| and ls
315

SFS
have been defined in detail in Section 3.1.1.

σ 22

, σ 33

, σ12

, σ13
and 316

σ 23
have been defined in detail in Fig. 8.
317 | 3.2. Failure model for plane stress state
318 | 3.2.1. Rotation matrix of plane stress state
319 | For transversely isotropic materials including FDM 3D printing materials, the constitutive
320 | equation of elastic materials can be expressed in matrix form as,
( | )
1 | 1 11 | 12 | 12
2 | 2 12 | 22 | 23
3 | 3 12 | 23 | 22
4 | 4 22 | 23
5 | 5 55
6 | 6 55
0 | 0 | 0
0 | 0 | 0
0 | 0 | 0
=
0 | 0 | 0 | 2 | 0 | 0
0 | 0 | 0 | 0 | 0
0 | 0 | 0 | 0 | 0
S | S | S
S | S | S
S | S | S
S | S
S
S
é ù | é ù é | ù ê ú | ê ú ê | ú
ê | ú
ê | ú
ê | ú
- ê | ú
ê | ú
ê | ú
ë û | ë û ë | û
ε | σ
ε | σ
ε | σ
ε | σ
ε | σ
ε | σ
321 | (17)

322 | Eq. (17) can be simplified as Eq. (18) for plane stress state,
1 | 1 11 | 12
2 | 12 | 22 | 2
12 | 12 55

0
0
| 0 | 0
S | S
S | S
S
é ù | é ù é | ù ê ú | ê ú ê | ú

=
ê ú | ê ú ê | ú ê ú | ê ú ê | ú ë û | ë û ë | û
ε | σ
ε | σ
γ | τ
323 | (18)

where
11
1

1
S =
E

, 22

2

1
S =
E

, 55

12

1
S =
G

,

21 | 12
12
1 | 2

S =
E E
=

ν ν
. E1
and 324

E2
are the Young’s moduli in

the
1

x
and
2

x
directions as shown in Fig. 9. G12 is the shear modulus in the
1

x - 2
325

x
plane.

21 ν
and

12 ν
are the Poisson’s ratios of materials involving directions
1

x
and
2

326

x .

327 | Eq. (18) can be expressed in the stiffness matrix form as,
1 | 1 11 | 12
2 | 12 | 22 | 2
12 | 12 55

0
0
| 0 | 0
Q | Q
Q | Q
Q
é ù | é ù é | ù ê ú | ê ú ê | ú

=
ê ú | ê ú ê | ú ê ú | ê ú ê | ú ë û | ë û ë | û
σ | ε
σ | ε
τ | γ
328 | (19)
329 | The constitutive equation in any direction including on-axis material direction can be
330 | expressed as,

( )

1 | 1
T
1 | 1 | 1 | 1
2 | 2
12 | 12
x | x
y | y
xy | xy
σ | ε σ | ε
σ | σ | ε | ε
τ | γ τ | γ
é ù | é ù é ù | é ù ê ú | ê ú ê ú | ê ú ê ú | ê ú = | = | = ê ú | ê ú ê ú | ê ú ê ú | ê ú ë û | ë û ë û | ë û
331
T | T Q | T Q T

(20)

332 | The rotation matrix

T
in Eq. (20) can be expressed as,
2 | 2
2 | 2
2 | 2
cos | | sin | | 2sin cos
sin | | cos | | 2sin cos
sin cos | sin cos | cos | sin
θ | θ | θ | θ
θ | θ | θ | θ
θ | θ | θ | θ | θ | θ
é | | | ù
ê | | | ú
= | - ê | ú
ê | ú - | - ë | û

333
T

(21)

where
θ

is the angle between the material
1

334

x

axis and the global
x

axis, as shown in Fig.

335 | 9.
336 | 3.2.2. Failure model
337 | As mentioned before, 3D printing technology is often dedicated to fabricating complex
338 | thin-walled structures. Therefore, the cases of plane stress state are very important and thus
339 | should be studied thoroughly. For this purpose, two coordinate systems should be built. System

x - y - z
| which represents the load directions is the global coordinate system. System
| 1

x - 2
340

x

- 3

x
which represents the material direction is the material coordinate system. The plane
2

341

x -

3

x
is the material layer plane and the direction
1

342

x
is the direction that is perpendicular to the
343 | material layer in the local material coordinate system.
344 | The specimens under tension during this research can be simplified as in a plane stress state
345 | because of the dimension of the specimens. The global coordinate and the material coordinate
346 | systems in 2D are shown in Fig. 9. Therefore, the mechanical theory of plane stress state can
347 | be used in the separate-modes of transversely isotropic failure model established in Section 3.1.

348

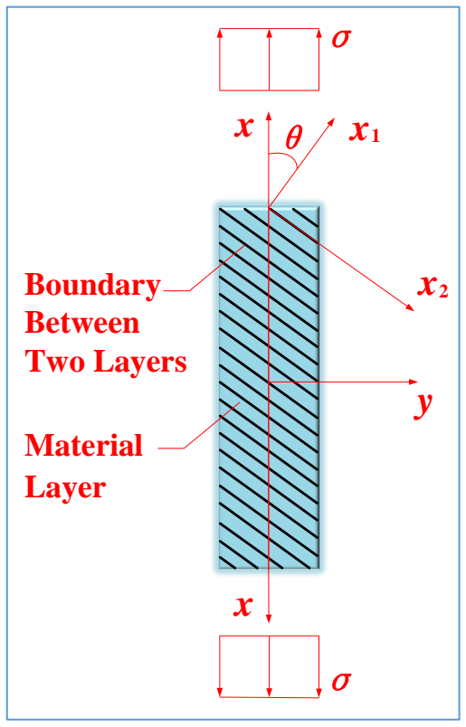
[picture p192: figure]
Material Layer; Boundary Between Two Layers

349 | Fig.T9.TMaterial direction and stress direction of FDM 3D printing materials
350 | for plane stress state.
351 | The non-vanishing stress components in Eq. (14) and Eq. (16) under plane stress state are

σ11

, σ 22
and

σ12
352 | (see Fig. 8). Then the separate-modes of transversely isotropic failure
353 | model for plane stress state can be derived as,
354 | Inter-layerTFailureTMode
2 | 2
11 | 12
itl | ls

1
TFS | SFS
æ | ö æ | ö σ | σ
ç | ÷ ç | ÷ + | =
è | ø è | | ø
355 | (22)
356 | In-layerTFailureTMode

2 | 2
22 | 12
il | ls
+ | 1
TFS | SFS
æ | ö σ | σ æ | ö ç | ÷ ç | ÷ =
è | | | | ø è | ø
357 | (23)
358 | If only uniaxial stress σ is applied on the specimen shown in Fig. 9, the stress
359 | components in the material coordinate system are,

2
11

2
22

12

cos

sin
sin cos

=

=
=
σ | σ | θ
σ | σ | θ
σ | σ | θ | θ
ì | ·
ï
í | ·
ï | - · | · î
360 | (24)
361 | These lead to Inter-layer Failure Mode below

1
4 | 2 | 2 | 2
itl | 2 | 2
itl | ls
cos | cos | sin
=T
TFS | SFS θ
θ | θ | θ
σ
é | ù ·
= | + ê | ú ë | û
362 | (25)

σ itl= Tθ
is the TFS in the x direction ( 363
σ itl 0 | 0 | itl ，
= | = T | TFS

).

364 | Similarly, Eq. (24) leads to In-layer Failure Mode below

1
4 | 2 | 2 | 2
il | 2 | 2
il | ls
sin | sin | cos
=T
TFS | SFS θ
θ | θ | θ
σ
é | ù ·
= | + ê | ú ë | û
365 | (26)

σ il= Tθ
is the TFS in the x direction ( 366
σ il 90 | 90 | il ，
= | = T | TFS
).
367 | 4. Separation angle
368 | A separate-modes of transversely isotropic theoretical failure model for plane stress state
369 | has been established in Eq. (25) and Eq. (26). However, which equation should be used to
370 | predict the TFS is still unknown. In order to characterise failure modes properly, the concept of
371 | separation angle

θ SA
which is the demarcation point between the two failure modes is put

forward. Let

σ itl
in Eq. (25) equal to

σ il
372 | in Eq. (26). Then the following equation for

separation angle 373

θ SA
is obtained.
1 | 1
4 | 2 | 2 | 4 | 2 | 2 2 | 2
SA | SA | SA | SA | SA | SA
2 | 2 | 2 | 2
itl | ls | il | ls
cos | cos | sin | sin | sin | cos
=
TFS | SFS | TFS | SFS
θ | θ | θ | θ | θ | θ
- | - é | ù | é | ù · | · ê | ú | ê | ú + | +
ë | û | ë | û
374 | (27)
375 | Simplification of Eq. (27) leads to

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
(28)

377 | Based on the above theoretical derivation and the phenomena of experimental results

378 obtained in this research, the following two conclusions can be easily obtained:

(a) When
| SA

379

θ θ ≤
, the inter-layer failure mode in Eq. (22) or Eq. (25)should be used to predict

380 the TFS of specimens during this research.

(b) When
SA

381

θ θ >
, the in-layer failure mode in Eq. (23) or Eq. (26) should be used to predict
382 | the TFS of specimens during this research.
383 | 5. Results and discussions
384 | 5.1. Experimental data
385 | TFS test data for the FDM 3D printing PLA material with all three layer thicknesses are
386 | given in Table 3. The magnitude of all these TFS test data is similar to the test results in previous
387 | researches [49, 50]. In Table 3, STDEV is Standard Deviation and CV is Coefficient of Variation.

0 T , T45
and

T90
388 | represent TFS of the material with 0 , 45 and 90 printing angles,
| respectively. Based on the discussion in Section 4, 0 T
| is the inter-layer TFS ( itl TFS
) and 389
| T90

is the in-layer TFS (

| TFSil
| ). TFS of off-axis specimens T45
390 | is used to calculate the longitudinal
| shear failure strength
| ls

391

SFS
. Then, all the parameters in the theoretical failure model for plane
392 | stress state in Eq. (25) and Eq. (26) are obtained and TFS of material with other 4 printing
393 | angles can be predicted.
394 | able 3 TFS test data for FDM 3D printing PLA material (unit: MPa).

θ
Test 1 | Test 2 | Test 3 | Test 4 | Mean | STDEV | CV (%)

Layer thickness = 0.1 mm

0 | T( 0 )
28.67 | 25.07 | 26.21 | 27.66 | 26.90 | 1.58 | 5.89

45 T( 45 )
30.84 | 32.97 | 32.94 | 28.54 | 31.32 | 2.11 | 6.72

90 T( 90 )
54.37 | 55.97 | 57.24 | - | 55.86 | 1.44 | 2.57

Layer thickness = 0.2 mm

0 | T( 0 )
25.53 | 24.95 | 26.20 | 23.05 | 24.93 | 1.35 | 5.43

45 T( 45 )
31.47 | 30.56 | 30.02 | - | 30.68 | 0.73 | 2.39

90 T( 90 )
51.18 | 53.53 | 54.53 | 57.65 | 54.22 | 2.68 | 4.95

Layer thickness = 0.3 mm

0 | T( 0 )
23.56 | 24.14 | 23.63 | - | 23.78 | 0.32 | 1.33

45 T( 45 )
29.32 | 29.19 | 28.98 | - | 29.16 | 0.17 | 0.59

90 T( 90 )
44.94 | 45.62 | 45.24 | 48.71 | 46.13 | 1.74 | 3.78
395 | At the same time, Young’s modulus and maximum elongation test data (extensometer) for
396 | the FDM 3D printing PLA material are given in Table 4.
397 | ableT4 Young’s modulus and maximum elongation test data
398 | for FDM 3D printing PLA material.

θ

Young’s modulus (unit: MPa) | maximum elongation (%)
Mean | STDEV | CV(%) | Mean | STDEV | CV

Layer thickness = 0.1 mm

0

1528.75 | 31.04 | 2.03 | 2.09 | 0.13 | 6.15

45

1555.33 | 28.04 | 1.80 | 2.39 | 0.14 | 5.85

90

1648.67 | 53.70 | 3.26 | 3.87 | 0.11 | 2.90

Layer thickness = 0.2 mm

0

1951.50 | 53.73 | 2.75 | 1.59 | 0.10 | 6.32

45

2065.33 | 74.66 | 3.61 | 1.88 | 0.09 | 4.87

90

2251.04 | 58.93 | 2.62 | 2.81 | 0.11 | 3.74

Layer thickness = 0.3 mm

0

1660.67 | 86.63 | 5.22 | 1.75 | 0.09 | 5.12

45

1769.67 | 82.42 | 4.66 | 2.05 | 0.12 | 5.90

90

1726.50 | 32.93 | 1.91 | 3.14 | 0.08 | 2.57

5.2. Discussion of separation angle 399

θ SA

400 | Based on the experimental data in Section 5.1 and the expression of separation angle in Eq.

(28), separation angle 401

θ SA
can be easily obtained, and are given in Table 5. Its values ranges

402 between

45
and

60 .

403 | ableT5 Separation angle for the FDM 3D printing PLA material.

Layer thickness (mm)

θ SA
(°)
0.1 | 55.24
0.2 | 55.85
0.3 | 54.32
404 | As explained therein before, there are two failure modes, which can be seen in Fig. 10 ~

Fig. 12. In addition, the experimental results of separation angles 405

θ SA
are given. Almost all

the separation angles 406

θ SA of experimental results are between 45 and
60
, which is
407 | basically consistent with theoretically predicted value in Table 5. Therefore, one can conclude
408 | that the theoretical model established in Section 4 has the capacity in predicting the approximate

range of the separation angle 409

θ SA .

410 | The classification of failure modes is given in Table 6. Almost all the inter-layer failure
411 | events occur when the printing angles are

0 , 15 , 30
and

45 . In contrast, in-layer failure

412 events occur when the printing angles are

60 , 75
and

90 . So the conclusion that inter-

413 | layer failure tends to occur when the printing angle is small and in-layer failure tends to occur
414 | when the printing angle is big can be drawn.

415

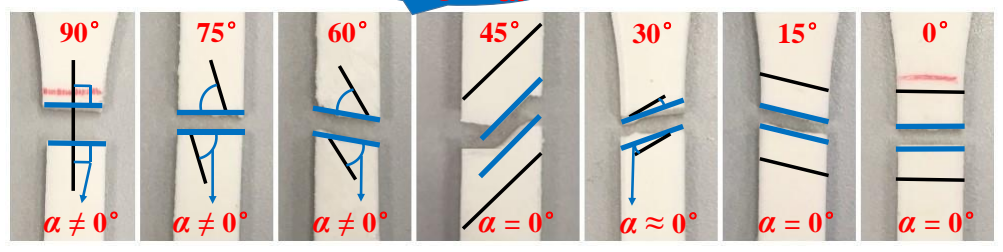
[picture p193: figure]

α ≠ 0° | α ≠ 0° | α ≠ 0° | α = 0° | α ≈T0° | α = 0° | α = 0°

Separation
Angle

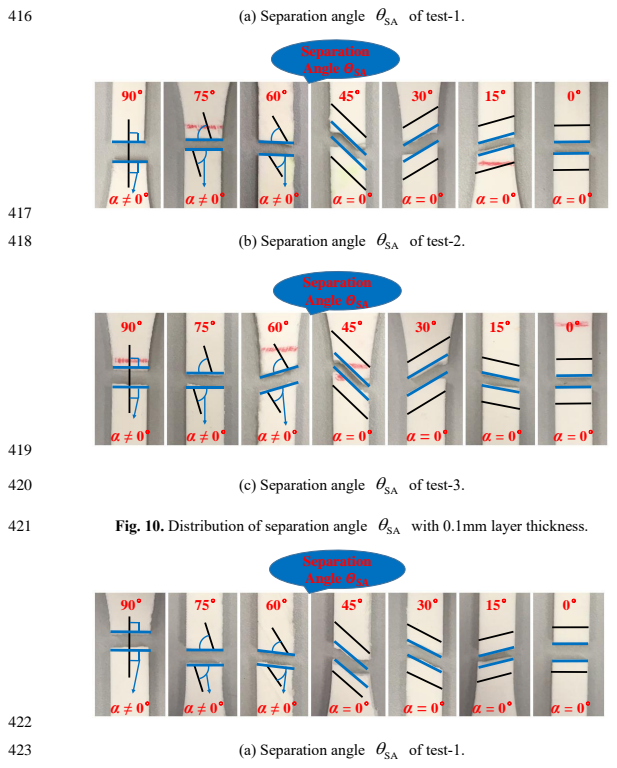
[picture p194: page 24]
(a) Separation angle 416; of test-1.; (b) Separation angle 418; of test-2.; (c) Separation angle 420; of test-3.; (a) Separation angle 423; Separation Angle

Fig.T10. Distribution of separation angle 421

with 0.1mm layer thickness.

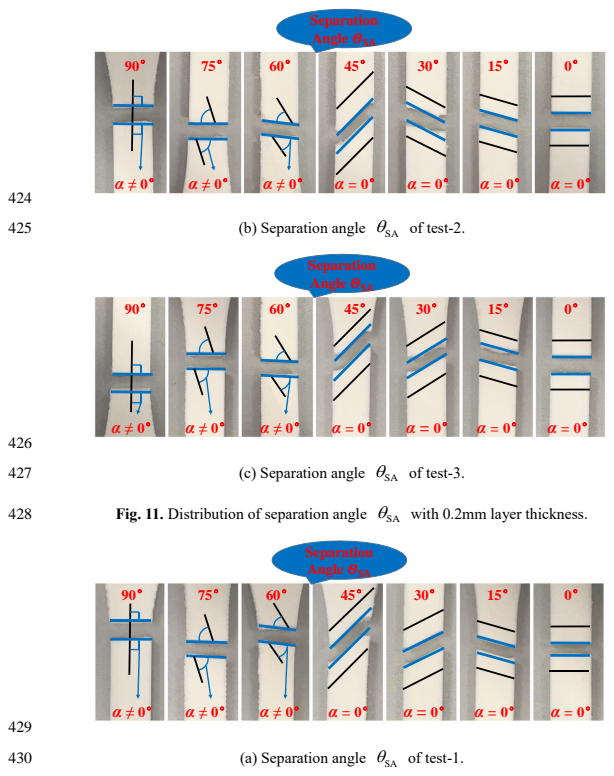
[picture p195: page 25]
(b) Separation angle 425; of test-2.; (c) Separation angle 427; of test-3.; (a) Separation angle 430; of test-1.; Separation Angle

Fig.T11. Distribution of separation angle 428

with 0.2mm layer thickness.

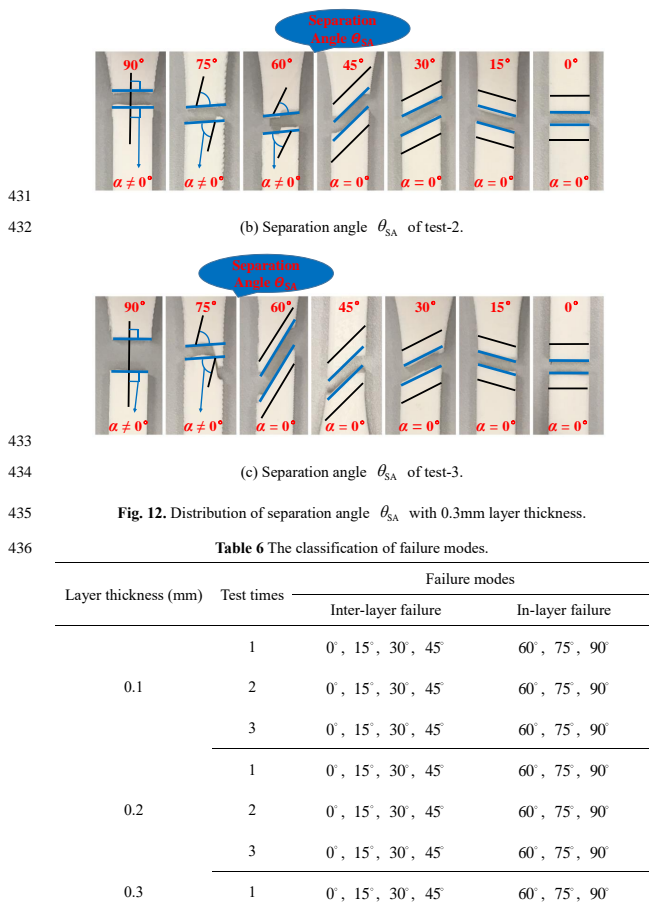
[picture p196: page 26]
(b) Separation angle 432; of test-2.; (c) Separation angle 434; of test-3.; with 0.3mm layer thickness.; able 6 The classification of failure modes.; Layer thickness (mm); Test times; Failure modes; Inter-layer failure; In-layer failure; Separation Angle

Fig.T12. Distribution of separation angle

2
0 , 15 , 30 , 45 | 60 , 75 , 90

3
0 , 15 , 30 , 45 , 60 | 75 , 90
5.3. Comparison between theoretical results and experimental data for TFS

TFS comparison between theoretical results and experimental data is made in Fig. 13. In

these three figures, the data including theoretical results and experimental data with STDEV

continues to increase with the printing angle increasing from

0
to
| 90 . This change rule can

also be seen in previous studies [50, 51]. At the same time, the degree of agreement between

theoretical results and experimental data is satisfactory.

In order to quantify the prediction accuracy of the theoretical model, a Generalized-

Relative-Root-Mean-Square Error (GRRMSE) between theoretical results and experimental

data is defined in Eq. (29). When the GRRMSE is close to zero, the accuracy of the theoretical

model is high. In Table 7, the order of magnitude of all the GRRMSE is | 2

10⁻
, which is consider

to be very close to zero. The same results can also be seen in Fig. 14. Therefore, one can confirm

that the theoretical model established in this paper has the capacity in predicting the TFS of

FDM 3D printing PLA material with different printing angles.

2

1

1

1
TR ED
=
1
ED

n

i | i
i
n

i
i

GRRMS n
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
（ | - | ）

(29)

where

n
is the number of distinct printing angle (

n
= 7 in this research),

TRi
refers to theoretical results corresponding to the

ith
printing angle, and

EDi
refers to averaged experimental data corresponding to the

ith
printing angle.

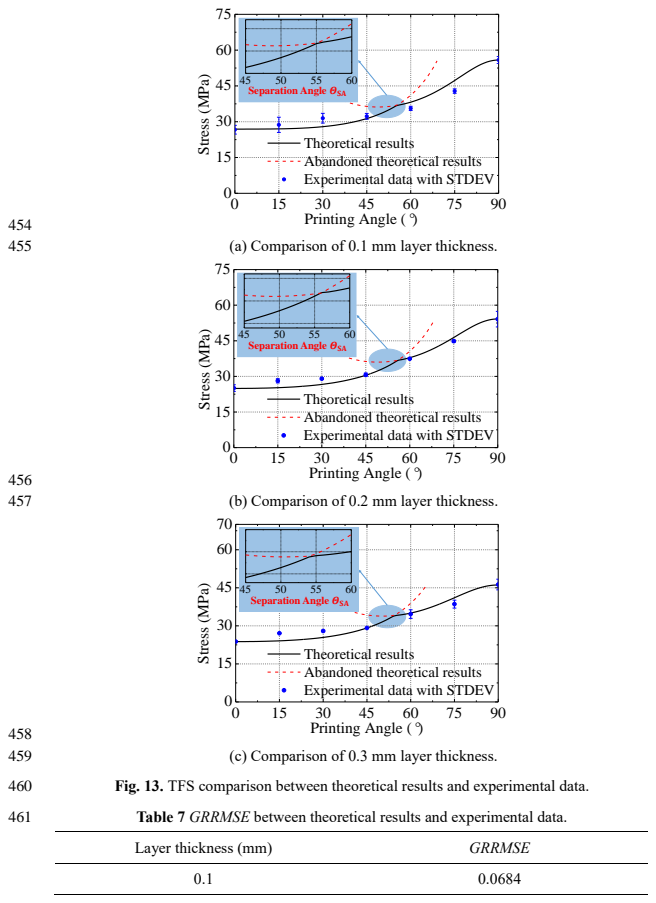
[picture p197: page 28]
(a) Comparison of 0.1 mm layer thickness.; (b) Comparison of 0.2 mm layer thickness.; (c) Comparison of 0.3 mm layer thickness.; Fig.T13. TFS comparison between theoretical results and experimental data.; ableT7 GRRMSE between theoretical results and experimental data.; Layer thickness (mm); GRRMSE; Printing Angle (°); Separation Angle

Experimental data with STDEV Stress ⁽MPa⁾

Theoretical results
Abandoned theoretical results

0.2 | 0.0436
0.3 | 0.0544

462
463 | Fig.14. GRRMSE between theoretical results and experimental data.
464 | 5.4. Influence of layer thickness on TFS
465 | The reliability of the theoretical model established during this research has been verified
466 | in Section 5.3. So the theoretical model can be used to analyse the influence of layer thickness
467 | on TFS. Fig. 15 displays this influence. Obviously, the TFS of the FDM 3D printing PLA
468 | material with same printing angle becomes bigger as layer thickness decreases from 0.3 mm to
469 | 0.1 mm. In Fig. 15, one can also see that the separation angle range of the FDM 3D printing

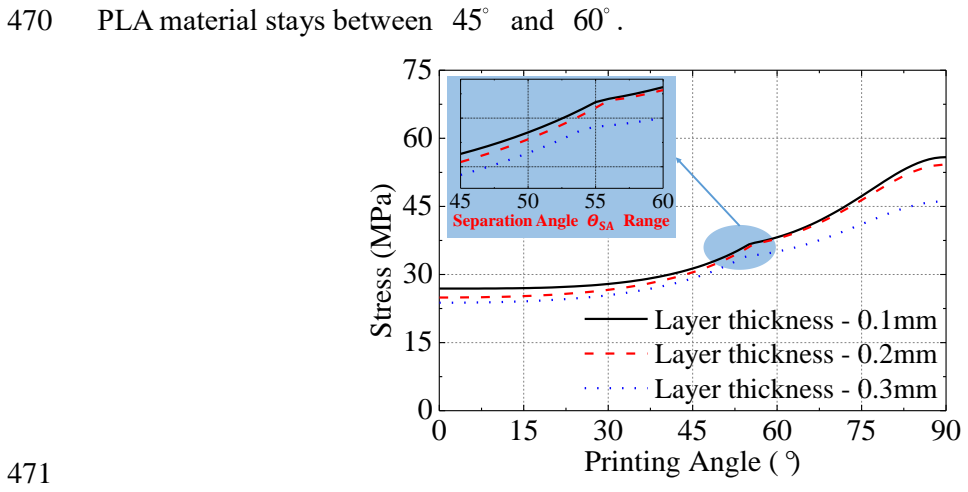
[picture p198: figure]
PLA material stays between; and; Layer thickness - 0.1mm Layer thickness - 0.2mm; Layer thickness - 0.3mm Stress ⁽MPa⁾; Printing Angle (°); Separation Angle; Range

472 | Fig.T15. Influence of layer thickness on TFS.
473 | 6. Conclusions

A preliminary study of tensile failure strength and the associated separation angle 474

θ SA
of
0 | 1 | 2 | 3 | 4

0

2

4

6

7GRRMSE ⁽¹⁰⁻³⁾ | Layer thickness (mm*10⁻¹)

475 | a FDM (Fused Deposition Modelling) 3D printing PLA (polylactic acid) material is presented
476 | in this paper. It is found that the material can be modelled as transversely isotropic and a
477 | separate-modes of transversely isotropic theoretical failure model is put forward and then

verified by experimental data, as well as the range of separation angle 478

| θ SA of this material.
479 | Based on the results and analysis of this research, four conclusions can be drawn as follows.
480 | 1. All the Generalized-Relative-Root-Mean-Square Error (GRRMSE) between theoretical
481 | results and experimental data are close to zero. So the theoretical model based on the
482 | transversely isotropic material hypothesis and separate failure-modes hypothesis established in
483 | this research is suitable for the failure of FDM 3D printing PLA material and has the capacity
484 | in predicting the tensile failure strength of this material.
2. The experimental results show that the range of separation angle 485
| θ SA is between
| 45
486 | and 60 . The theoretical model is shown to be able to approximately predict the range of

separation angle 487

| θ SA of this FDM 3D printing PLA material.
488 | 3. Two different failure modes are discovered in the tensile experiments. Inter-layer failure
489 | mode occurs when the printing angle is small while in-layer failure mode occurs when the
490 | printing angle is big.
491 | 4. Apparently, the tensile failure strength of this FDM 3D printing PLA material with the
492 | same printing angles becomes bigger as its layer thickness decreases from 0.3 mm to 0.1 mm.
493 | Further research will be concentrated on optimizing the separate-modes of transversely
494 | isotropic theoretical failure model. The theoretical model will be extended to predict the failure

strength and distribution of separation angle ( 495

| θ SA ) of different kinds of 3D printing materials.
496 | Acknowledgements
497 | This work was supported by the National Key R&D Program of China (2017YFB1102801),
498 | and the Graduate Innovation Team Foundation of Northwestern Polytechnical University. Part
499 | of the theoretical work is carried out during the visit by the first author to the University of
500 | Liverpool.

References

[1] Wang X, Jiang M, Zhou Z, Gou J, Hui D. 3D printing of polymer matrix composites: A

review and prospective. Composites Part B: Engineering. 2017; 110: 442-58.

[2] Parandoush P, Lin D. A review on additive manufacturing of polymer-fiber composites.

Compos Struct 2017; 182: 36–53.

[3] Ngo TD, Kashani A, Imbalzano G, Nguyen KTQ, Hui D. Additive manufacturing (3D

printing): A review of materials, methods, applications and challenges. Compos Part B

Eng 2018; 143: 172–96.

[4] Zhang Z, Wang B, Hui D, Qiu J, Wang S. 3D bioprinting of soft materials-based

regenerative vascular structures and tissues. Compos Part B Eng 2017; 123: 279–91.

[5] Gibson I, Rosen DW, Stucker B. Additive manufacturing technologies: Springer; 2014.
[6] Wimpenny DI, Pandey PM, Jyothish Kumar L. Advances in 3D Printing & additive

manufacturing technologies. 2017.

[7] Xu XJ, Zheng ML, Wang XC. On vibrations of nonlocal rods: Boundary conditions, exact

solutions and their asymptotics. Int J Eng Sci 2017; 119: 217–31.

[8] Zhang K, Ge MH, Zhao C, Deng ZC, Xu XJ. Free vibration of nonlocal Timoshenko beams

made of functionally graded materials by Symplectic method. Compos Part B Eng 2019;

156: 174–84.

[9] Amirpour M, Bickerton S, Calius E, Das R, Mace B. Numerical and experimental study

on deformation of 3D-printed polymeric functionally graded plates: 3D-Digital Image

Correlation approach. Compos Struct 2019; 211: 481–9.

[10] Mansouri MR, Montazerian H, Schmauder S, Kadkhodapour J. 3D-printed multimaterial

composites tailored for compliancy and strain recovery. Compos Struct 2018; 184: 11–7.

[11] Stepashkin, Chukov DI, Senatov FS, Salimon AI, Korsunsky AM, Kaloshkin SD. 3D-

printed PEEK-carbon fiber (CF) composites: Structure and thermal properties. Compos

Sci Technol 2018; 164: 319–26.

[12] Pyl L, Kalteremidou KA, Van Hemelrijck D. Exploration of the design freedom of 3D

printed continuous fibre-reinforced polymers in open-hole tensile strength tests. Compos

Sci Technol 2019; 171: 135–51.

[13] Tekinalp HL, Kunc V, Velez-Garcia GM, Duty CE, Love LJ, Naskar AK, et al. Highly

oriented carbon fiber-polymer composites via additive manufacturing. Compos Sci

Technol 2014; 105: 144–50.

[14] Berman B. 3-D printing: The new industrial revolution. Bus Horiz 2012; 55: 155–62.
[15] Wolfs RJM, Bos FP, Salet TAM. Early age mechanical behaviour of 3D printed concrete:

Numerical modelling and experimental testing. Cem Concr Res 2018; 106: 103–16.

[16] Panda B, Lim JH, Tan MJ. Mechanical properties and deformation behaviour of early age

concrete in the context of digital construction. Compos Part B Eng 2019; 165: 563–71.

[17] Talagani M, DorMohammadi S, Dutton R, Godines C, Baid H, Abdi F, et al. Numerical

simulation of big area additive manufacturing (3D printing) of a full size car. SAMPE

Journal. 2015; 51(4): 27-36.

[18] Do AV, Khorsand B, Geary SM, Salem AK. 3D Printing of Scaffolds for Tissue

Regeneration Applications. Adv Healthc Mater 2015; 4: 1742–62.

[19] Zhu W, Ma X, Gou M, Mei D, Zhang K, Chen S. 3D printing of functional biomaterials

for tissue engineering. Curr Opin Biotechnol 2016; 40: 103–12.

[20] Wang MO, Vorwald CE, Dreher ML, Mott EJ, Cheng MH, Cinar A, et al. Evaluating 3D-

printed biomaterials as scaffolds for vascularized bone tissue engineering. Adv Mater 2014;

27: 138–44.

[21] Blaeser A, Duarte Campos DF, Puster U, Richtering W, Stevens MM, Fischer H.

Controlling Shear Stress in 3D Bioprinting is a Key Factor to Balance Printing Resolution

and Stem Cell Integrity. Adv Healthc Mater 2016; 5: 326–33.

[22] Godoi FC, Prakash S, Bhandari BR. 3D printing technologies applied for food design:

Status and prospects. J Food Eng 2016; 179: 44–54.

[23] Sun J, Zhou W, Huang D, Fuh JYH, Hong GS. An Overview of 3D Printing Technologies

for Food Fabrication. Food Bioprocess Technol 2015; 8: 1605–15.

[24] Lipton JI, Cutler M, Nigl F, Cohen D, Lipson H. Additive manufacturing for the food

industry. Trends Food Sci Technol 2015; 43: 114–23.

[25] Wang BZ, Chen Y. The effect of 3D printing technology on the future fashion design and

manufacturing. Applied Mechanics and Materials: Trans Tech Publ; 2014. p. 2687-91.

[26] Yao T, Deng Z, Zhang K, Li S. A method to predict the ultimate tensile strength of 3D printing polylactic acid (PLA) materials with different printing orientations. Compos Part

B Eng 2019; 163: 393-402.

[27] Chacón JM, Caminero MA, García-Plaza E, Núñez PJ. Additive manufacturing of PLA

structures using fused deposition modelling: Effect of process parameters on mechanical

properties and their optimal selection. Mater Des 2017; 124: 143–57.

[28] Tanikella NG, Wittbrodt B, Pearce JM. Tensile strength of commercial polymer materials

for fused filament fabrication 3D printing. Addit Manuf 2017; 15: 40–7.

[29] Sood AK, Ohdar RK, Mahapatra SS. Parametric appraisal of mechanical property of fused

deposition modelling processed parts. Mater Des 2010; 31: 287–95.

[30] Croccolo D, De Agostinis M, Olmi G. Experimental characterization and analytical

modelling of the mechanical behaviour of fused deposition processed parts made of ABS-

M30. Comput Mater Sci 2013; 79: 506–18.

[31] García Plaza E, Núñez López PJ, Caminero Torija MÁ, Chacón Plaza JM. Analysis of PLA

geometric properties processed by FFF additive manufacturing: Effects of process

parameters and plate-extruder precision motion. Polymers (Basel) 2019; 11.

[32] Ahn SH, Montero M, Odell D, Roundy S, Wright PK. Anisotropic material properties of

fused deposition modeling ABS. Rapid Prototyp J 2002; 8: 248–57.

[33] Rayegani F, Onwubolu GC. Fused deposition modelling (fdm) process parameter

prediction and optimization using group method for data handling (gmdh) and differential

evolution (de). Int J Adv Manuf Technol 2014; 73: 509–19.

[34] Torrado Perez AR, Roberson DA, Wicker RB. Fracture surface analysis of 3D-printed

tensile specimens of novel ABS-based materials. J Fail Anal Prev 2014; 14: 343–53.

[35] Sood AK, Ohdar RK, Mahapatra SS. Experimental investigation and empirical modelling

of FDM process for compressive strength improvement. J Adv Res 2012; 3: 81–90.

[36] Tymrak BM, Kreiger M, Pearce JM. Mechanical properties of components fabricated with

open-source 3-D printers under realistic environmental conditions. Mater Des 2014; 58:

242–6.

[37] Song Y, Li Y, Song W, Yee K, Lee KY, Tagarielli VL. Measurements of the mechanical

response of unidirectional 3D-printed PLA. Mater Des 2017; 123: 154–64.

[38] Zhang P, To AC. Transversely isotropic hyperelastic-viscoplastic model for glassy polymers with application to additive manufactured photopolymers. Int J Plast 2016; 80:

56–74.

[39] Tsai SW, Wu EM. A General Theory of Strength for Anisotropic Materials. J Compos

Mater 1971; 5: 58–80.

[40] Ahn SH, Baek C, Lee S, Ahn IS. Anisotropic tensile failure model of rapid prototyping

parts - Fused Deposition Modeling (FDM). Int J Mod Phys B 2003; 17: 1510–6.

[41] Obst P, Launhardt M, Drummer D, Osswald P V., Osswald TA. Failure criterion for PA12

SLS additive manufactured parts. Addit Manuf 2018; 21: 619–27.

[42] Ning F, Cong W, Hu Y, Wang H. Additive manufacturing of carbon fiber-reinforced plastic

composites using fused deposition modeling: Effects of process parameters on tensile

properties. J Compos Mater 2017; 51: 451–62.

[43] Caminero MÁ, Chacón JM, García-Plaza E, Núñez PJ, Reverte JM, Becar JP. Additive

manufacturing of PLA-based composites using fused filament fabrication: Effect of

graphene nanoplatelet reinforcement on mechanical properties, dimensional accuracy and

texture. Polymers (Basel) 2019; 11.

[44] Ulu E, Korkmaz E, Yay K, Burak Ozdoganlar O, Burak Kara L. Enhancing the Structural

Performance of Additively Manufactured Objects Through Build Orientation

Optimization. J Mech Des Trans ASME 2015; 137: 1–9.

[45] Hashin Z, Rotem A. A Fatigue Failure Criterion for Fiber Reinforced Materials. J Compos

Mater 1973; 7: 448–64.

[46] Hashin Z. Failure Criteria for Unidirectional Fiber Composites. Journal of Applied

Mechanics. 1980; 47(2): 329-34.

[47] Tao Y, Chen H, Yao K, Lei H, Pei Y, Fang D. Experimental and theoretical studies on inter-

fiber failure of unidirectional polymer-matrix composites under different strain rates. Int J

Solids Struct 2017; 113–114: 37–46.

[48] Puck A, Schürmann H. Failure analysis of FRP laminates by means of physically based

phenomenological models. Fail Criteria Fibre-Reinforced-Polymer Compos 2004; 3538:

832–76.

[49] Goh GD, Yap YL, Tan HKJ, Sing SL, Goh GL, Yeong WY. Process–Structure–Properties

in Polymer Additive Manufacturing via Material Extrusion: A Review. Crit Rev Solid State

620 | Mater Sci 2019; 0: 1–21.
621 | [50] Zhao Y, Chen Y, Zhou Y. Novel mechanical models of tensile strength and elastic property
622 | of FDM AM PLA materials: Experimental and theoretical analyses. Mater Des 2019; 181:
623 | 108089.
624 | [51] Alaimo G, Marconi S, Costato L, Auricchio F. Influence of meso-structure and chemical
625 | composition on FDM 3D-printed parts. Compos Part B Eng 2017; 113: 371–80.

626
