metinoxy/VTOL/assembly images/3D_printed_hinge.jpg

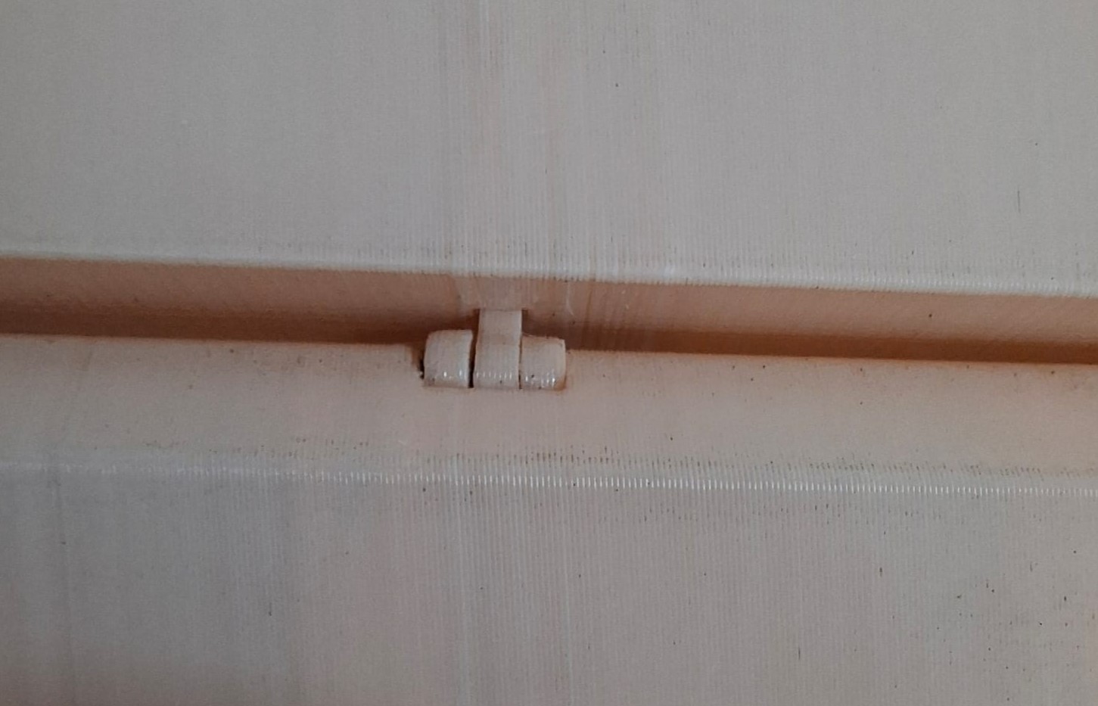
assembly images/3D_printed_hinge.jpg
