metinoxy/VTOL/assembly images/fully_assembled_wing.jpg

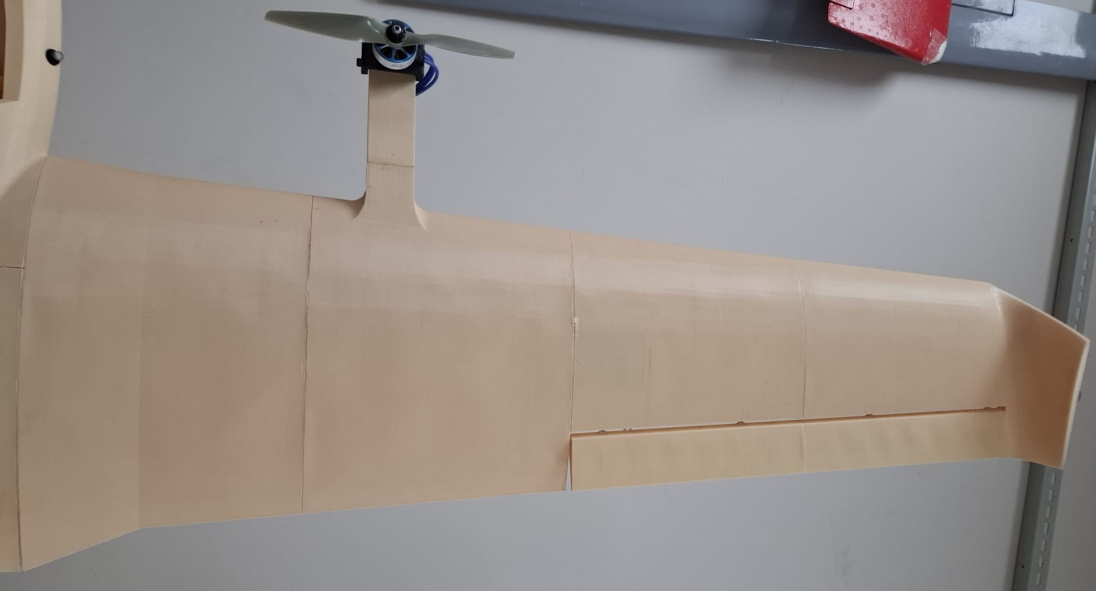
assembly images/fully_assembled_wing.jpg
