metinoxy/VTOL/assembly images/fusalage_front.jpg

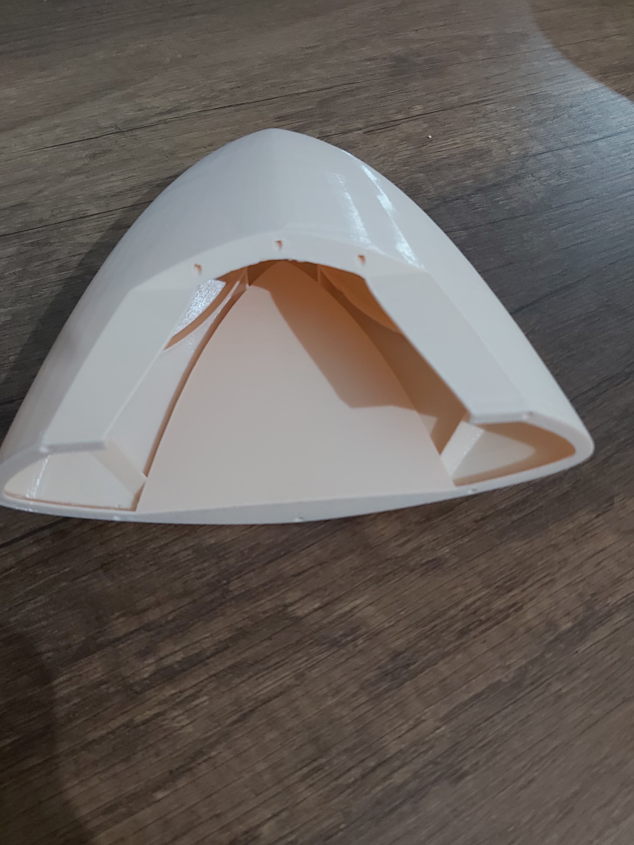
assembly images/fusalage_front.jpg
