metinoxy/VTOL/assembly images/fusalage_middle.jpg

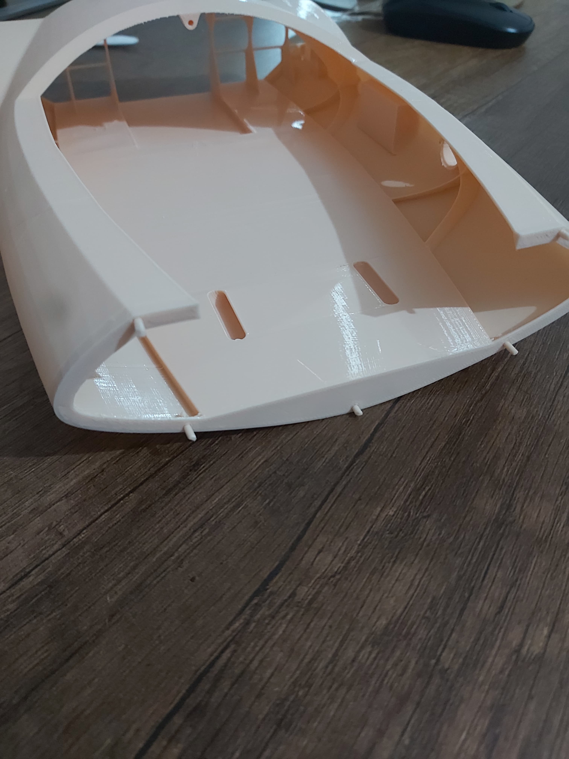
assembly images/fusalage_middle.jpg
