metinoxy/VTOL/assembly images/fusalage_middle_top_view.jpg

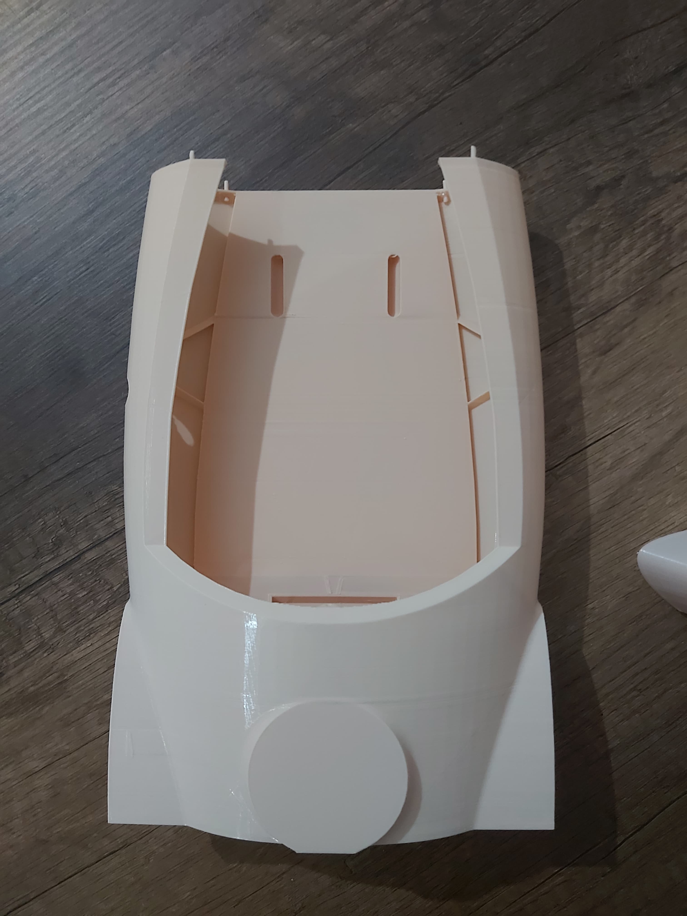
assembly images/fusalage_middle_top_view.jpg
