metinoxy/VTOL/assembly images/fuselage.jpg

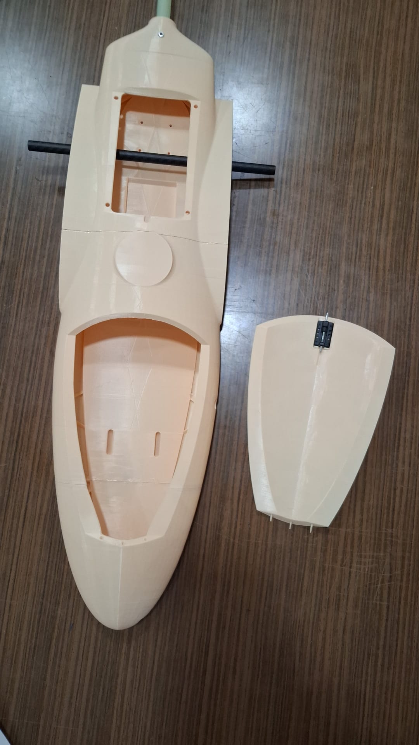
assembly images/fuselage.jpg
