metinoxy/VTOL/assembly images/fuselage_alone.jpg

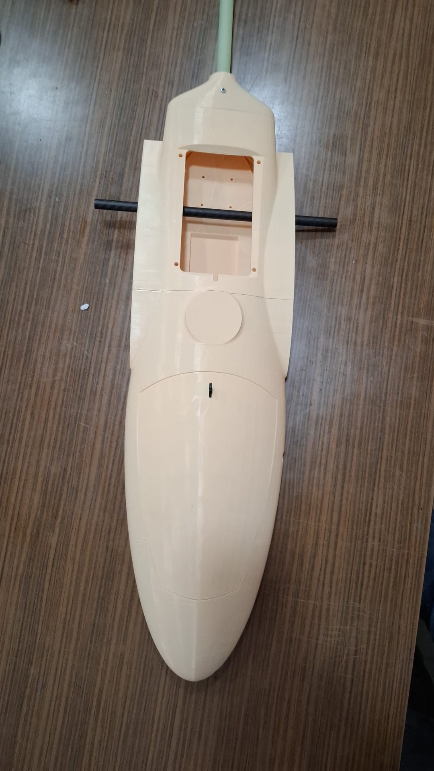
assembly images/fuselage_alone.jpg
