metinoxy/VTOL/assembly images/hatches_down.jpg

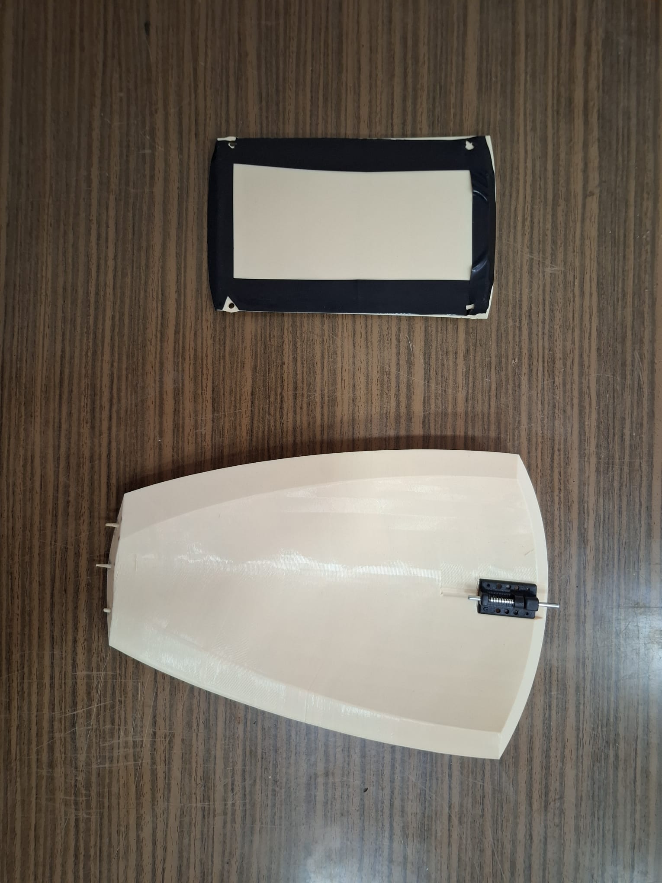
assembly images/hatches_down.jpg
