metinoxy/VTOL/assembly images/hatches_up.jpg

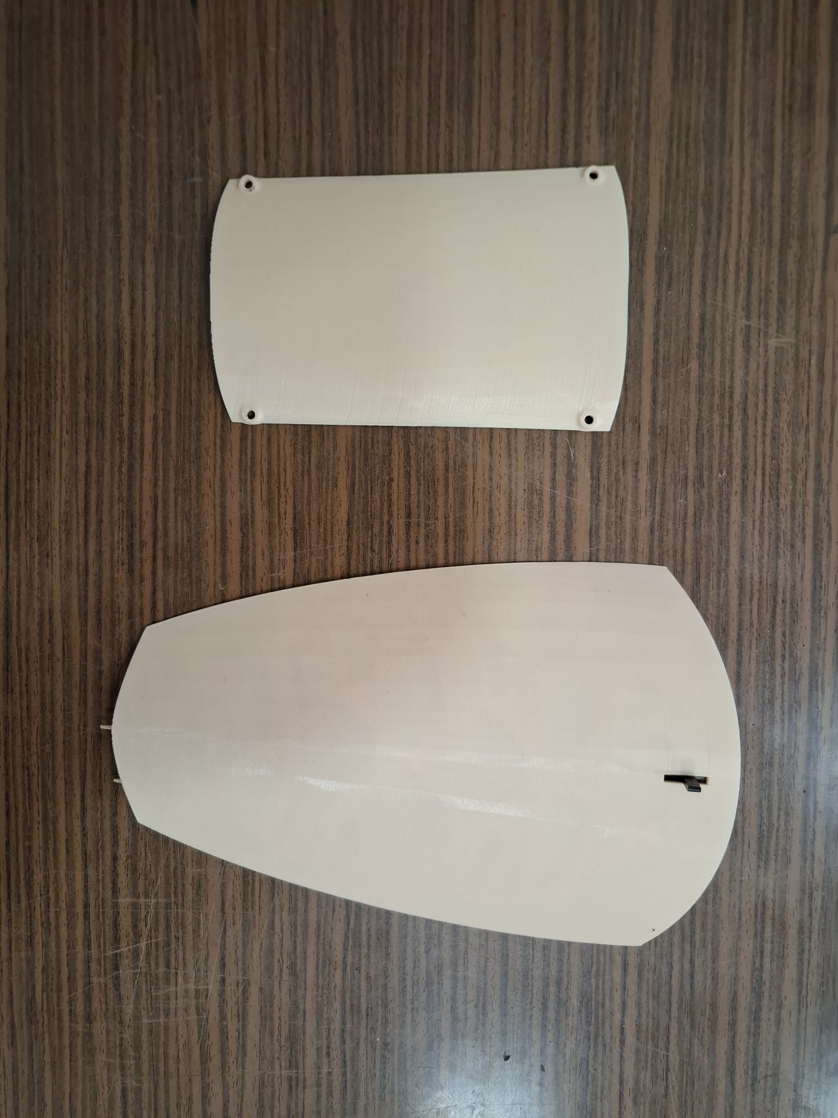
assembly images/hatches_up.jpg
