metinoxy/VTOL/assembly images/Hinge and wing.png

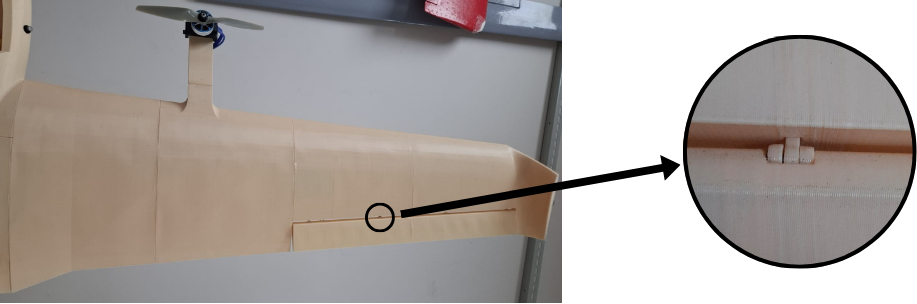
assembly images/Hinge and wing.png
