metinoxy/VTOL/assembly images/Vtail_assembled.jpg

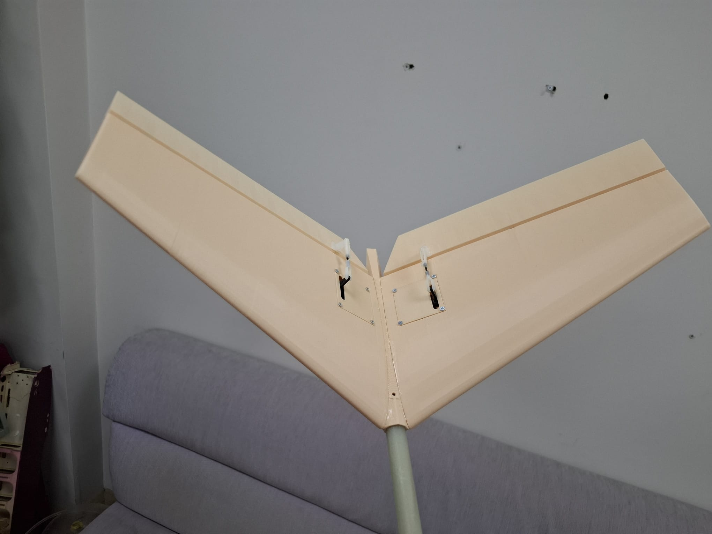
assembly images/Vtail_assembled.jpg
