metinoxy/VTOL/assembly images/WhatsApp Görsel 2025-06-09 saat 21.38.57_3c2f6e8c.jpg

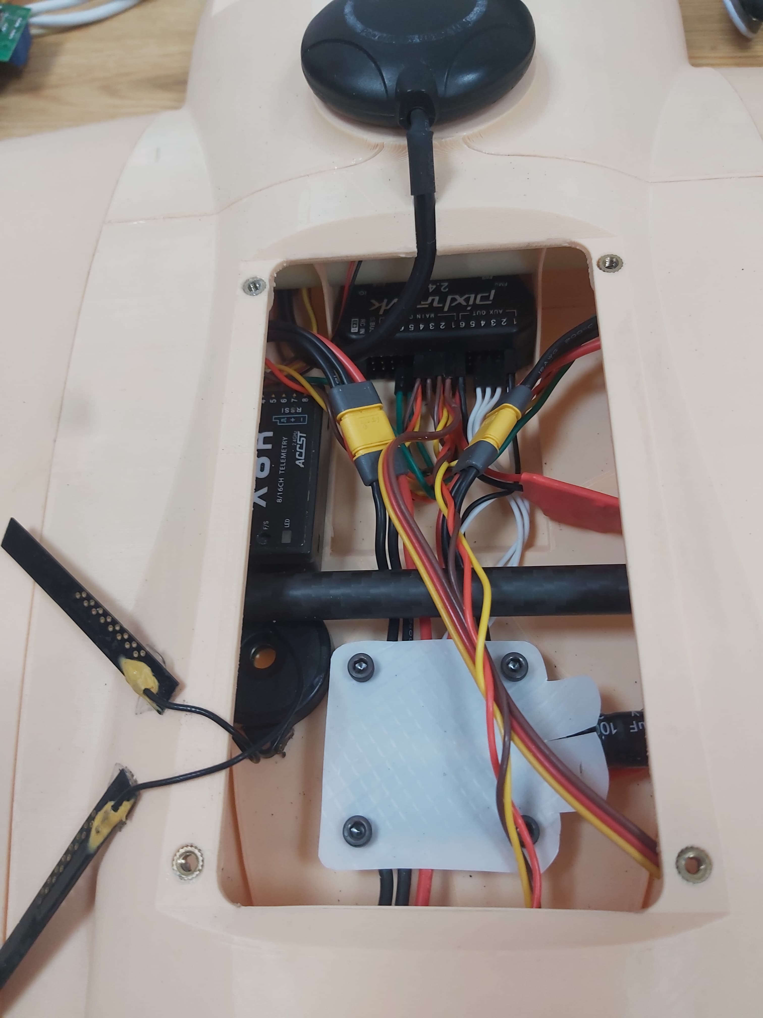
assembly images/WhatsApp Görsel 2025-06-09 saat 21.38.57_3c2f6e8c.jpg
