metinoxy/VTOL/assembly images/WhatsApp Görsel 2025-06-09 saat 21.38.57_b77dd0ac.jpg

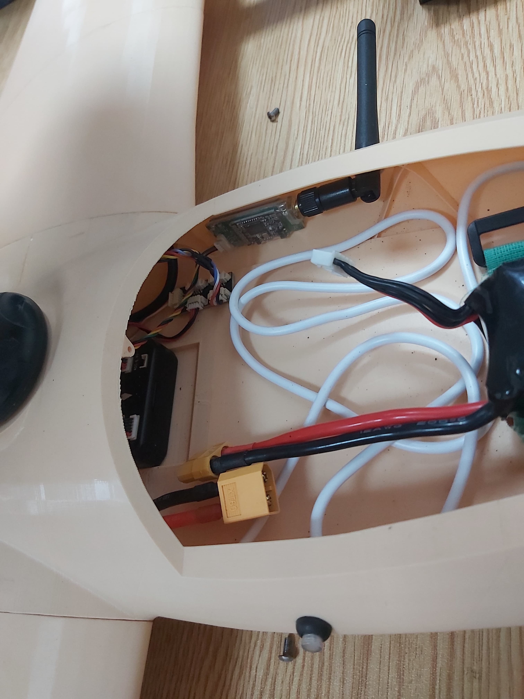
assembly images/WhatsApp Görsel 2025-06-09 saat 21.38.57_b77dd0ac.jpg
