metinoxy/VTOL/assembly images/WhatsApp Görsel 2025-06-09 saat 21.38.57_c5e05210.jpg

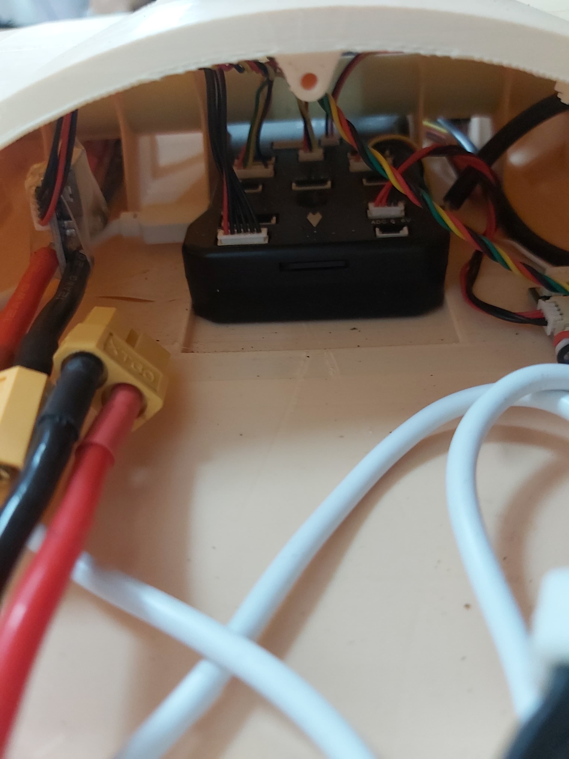
assembly images/WhatsApp Görsel 2025-06-09 saat 21.38.57_c5e05210.jpg
