metinoxy/VTOL/assembly images/WhatsApp Görsel 2025-06-09 saat 21.39.33_d010ec8b.jpg

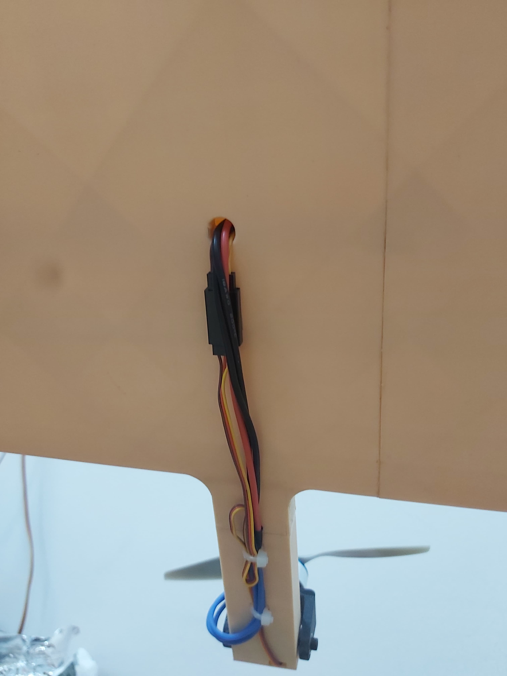
assembly images/WhatsApp Görsel 2025-06-09 saat 21.39.33_d010ec8b.jpg
