metinoxy/VTOL/assembly images/wing_assembly_adjusting.jpg

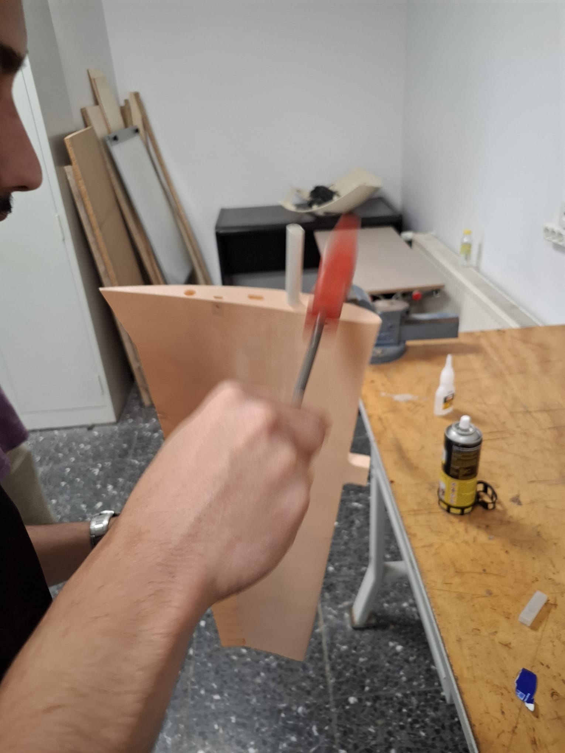
assembly images/wing_assembly_adjusting.jpg
