metinoxy/VTOL/assembly images/wing_assembly_two_part_glue.jpg

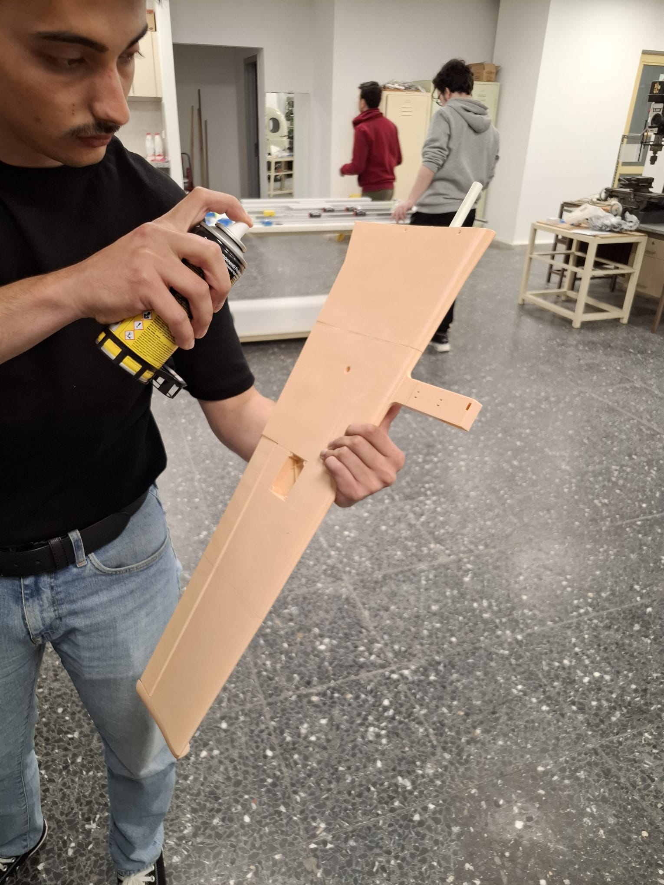
assembly images/wing_assembly_two_part_glue.jpg
