metinoxy/VTOL/assembly images/wing_gluing_combined.jpg

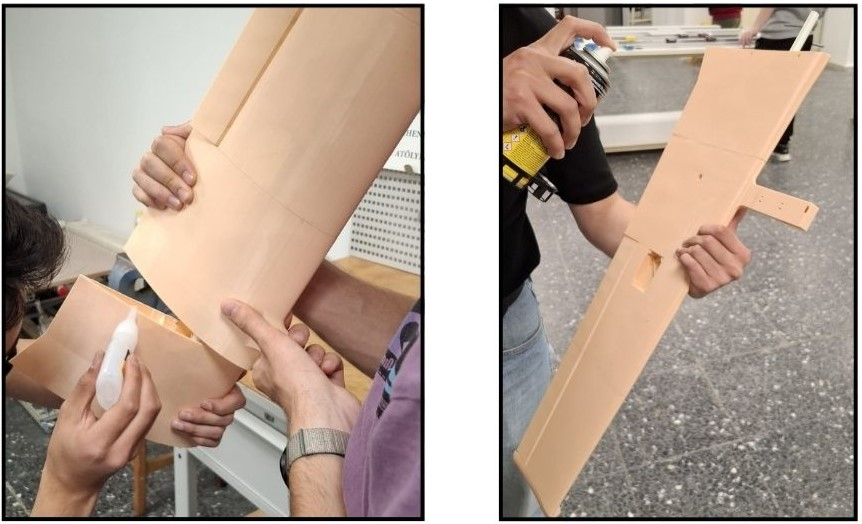
assembly images/wing_gluing_combined.jpg
