metinoxy/VTOL/Images/Electronic Wiring.png

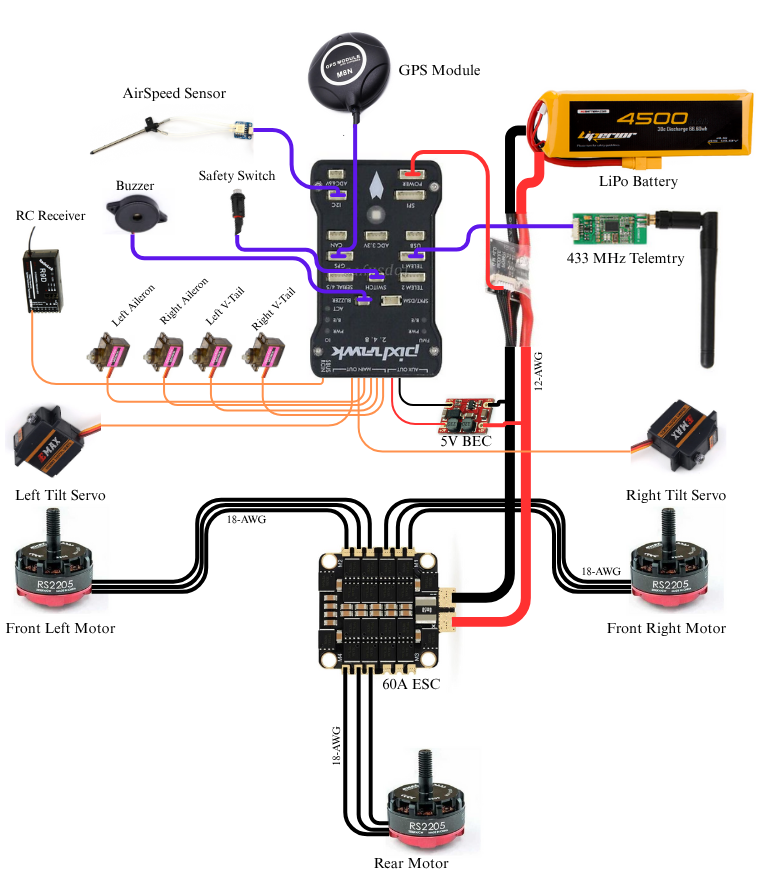
Images/Electronic Wiring.png
