metinoxy/VTOL/Images/FFF-Setup-Output.png

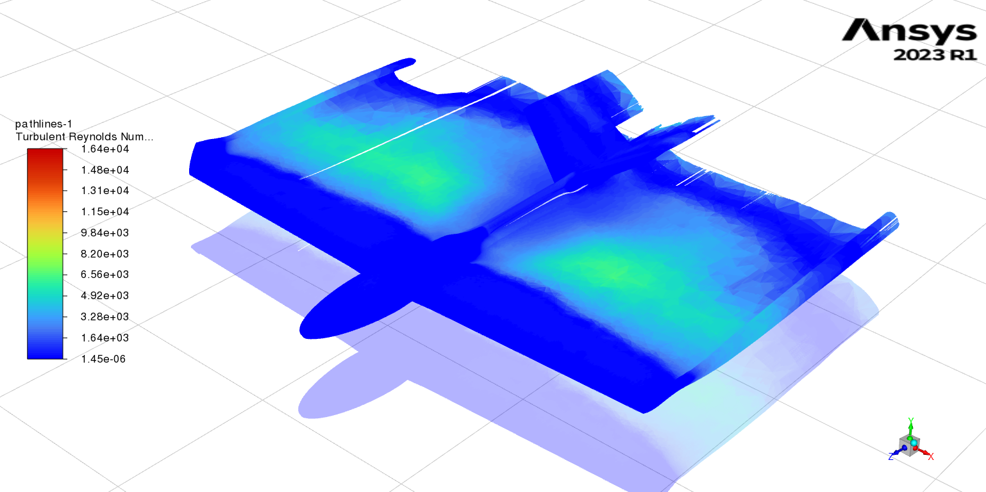
Images/FFF-Setup-Output.png
