metinoxy/VTOL/Images/Montage_v1_Front.JPG

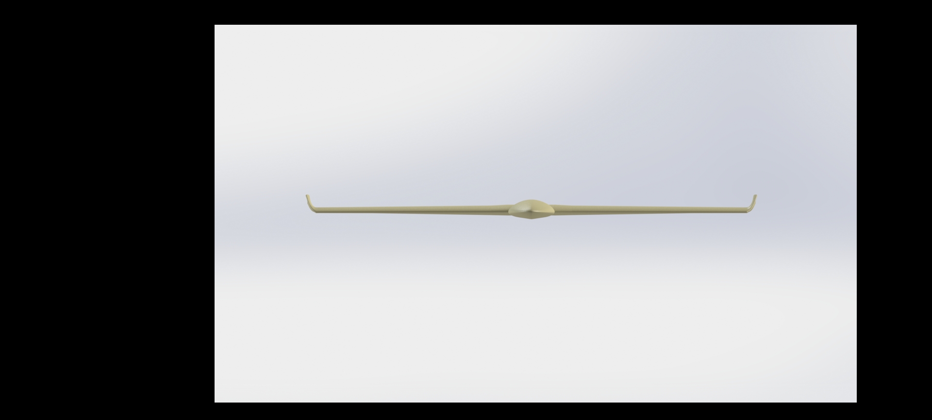
Images/Montage_v1_Front.JPG
