metinoxy/VTOL/Images/Montage_v1_Iso.JPG

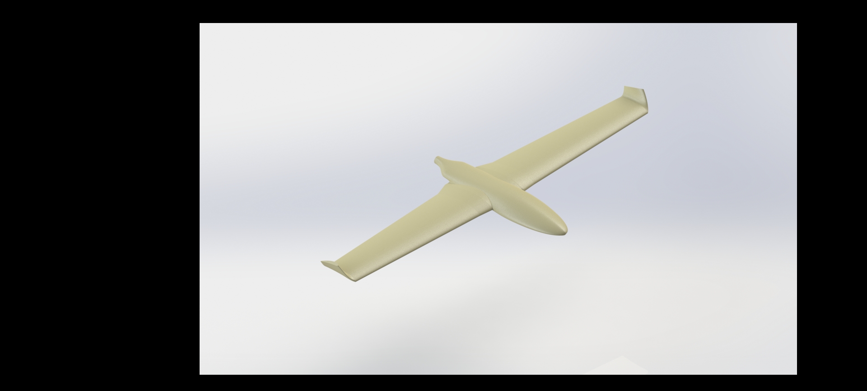
Images/Montage_v1_Iso.JPG
