metinoxy/VTOL/Images/Montage_v1_Top.JPG

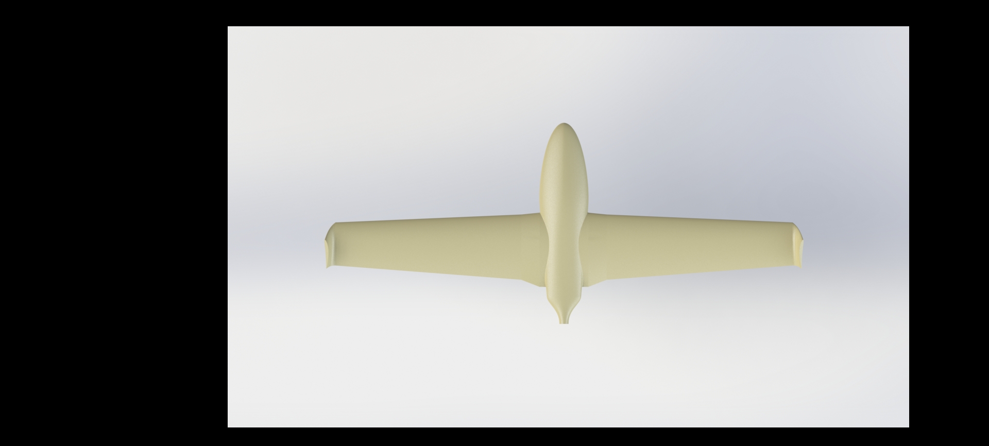
Images/Montage_v1_Top.JPG
