metinoxy/VTOL/Images/Print Orientations/Arms.png

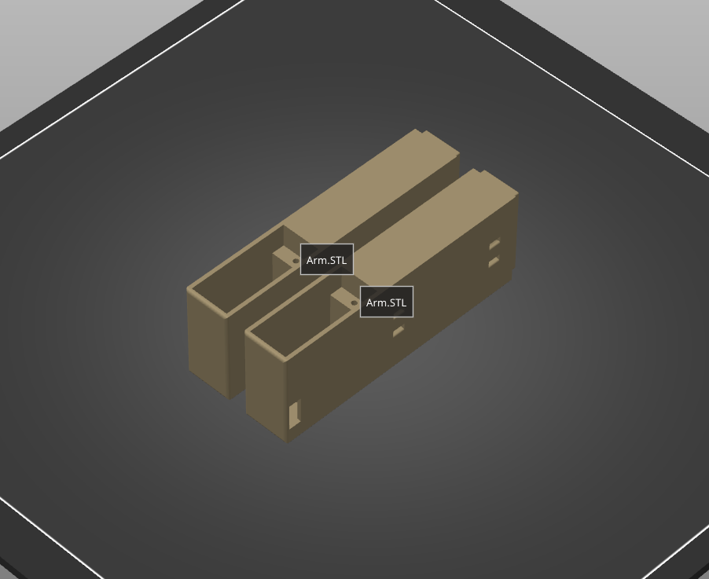
Images/Print Orientations/Arms.png
