metinoxy/VTOL/Images/Print Orientations/Back_Mount.png

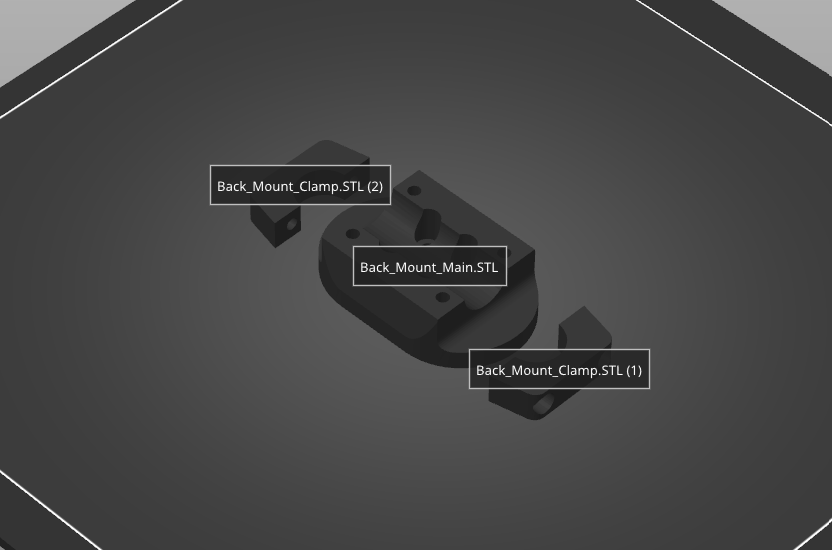
Images/Print Orientations/Back_Mount.png
