metinoxy/VTOL/Images/Print Orientations/Fuselage_BackLid.png

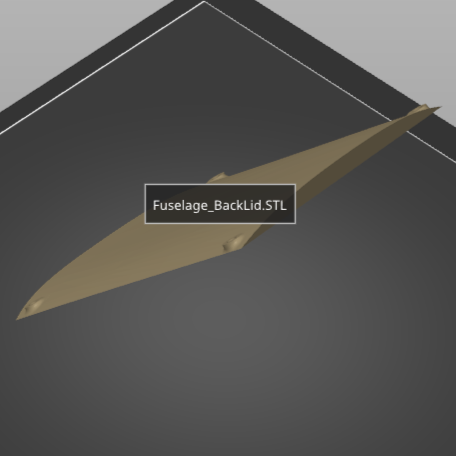
Images/Print Orientations/Fuselage_BackLid.png
