metinoxy/VTOL/Images/Print Orientations/Fuselage_FrontLid.png

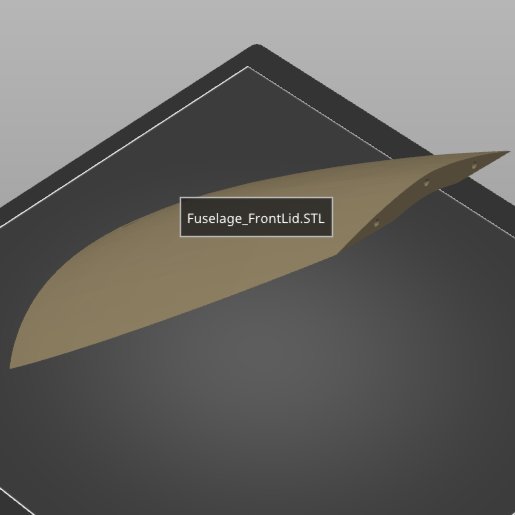
Images/Print Orientations/Fuselage_FrontLid.png
