metinoxy/VTOL/Images/Print Orientations/Fuselage_P1.png

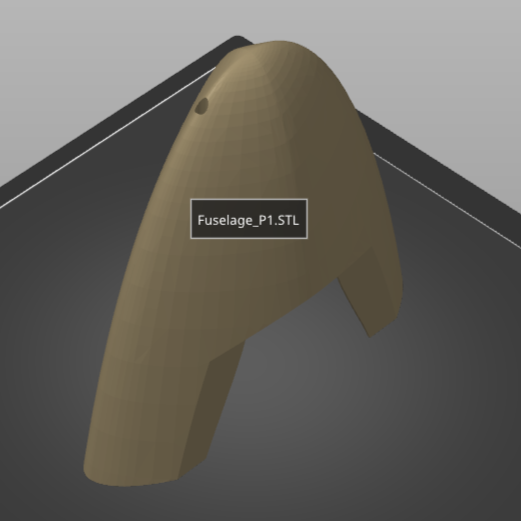
Images/Print Orientations/Fuselage_P1.png
