metinoxy/VTOL/Images/Print Orientations/Fuselage_P2.png

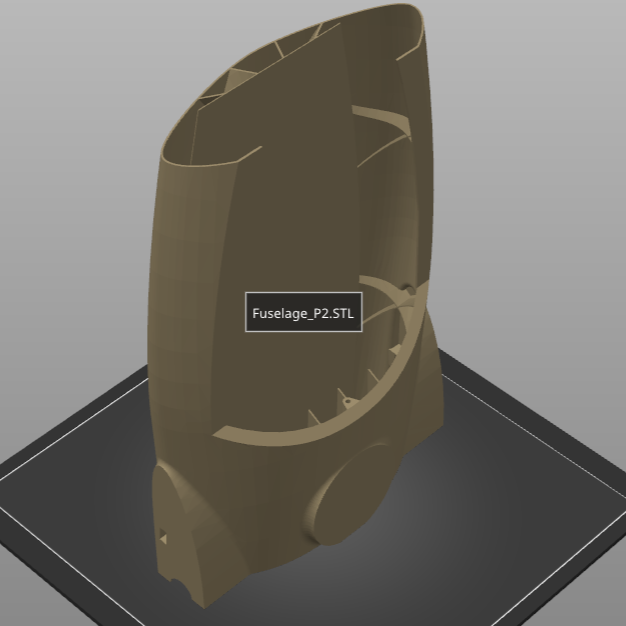
Images/Print Orientations/Fuselage_P2.png
