metinoxy/VTOL/Images/Print Orientations/Fuselage_P3.png

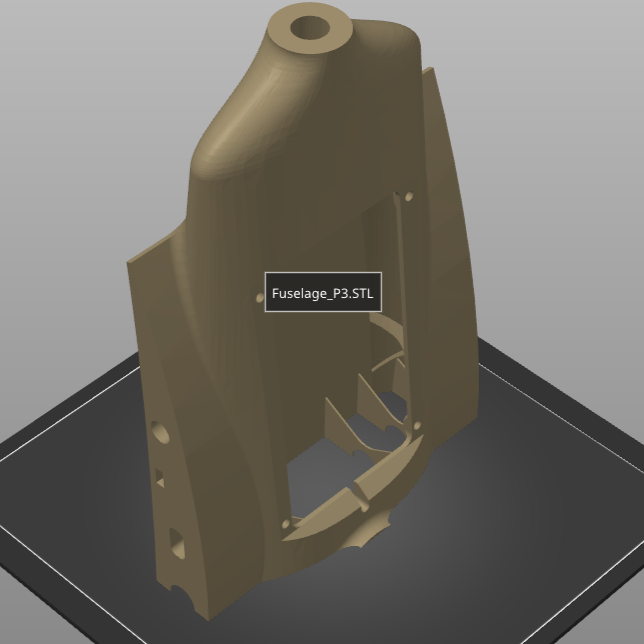
Images/Print Orientations/Fuselage_P3.png
