metinoxy/VTOL/Images/Print Orientations/Ruddervator_L.png

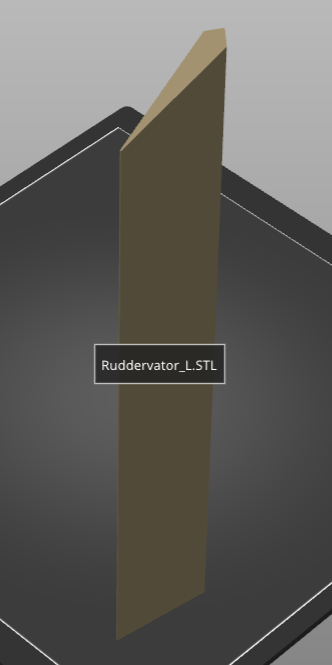
Images/Print Orientations/Ruddervator_L.png
