metinoxy/VTOL/Images/Print Orientations/Tilt_Mounts.png

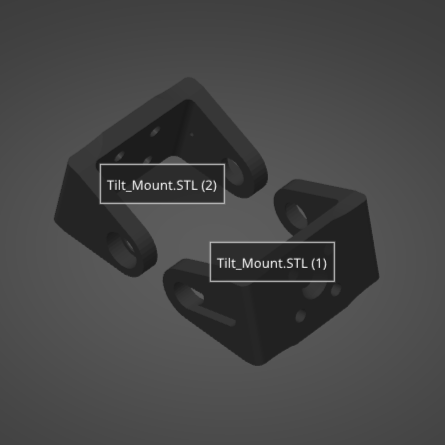
Images/Print Orientations/Tilt_Mounts.png
