metinoxy/VTOL/Images/Print Orientations/Vtail_L.png

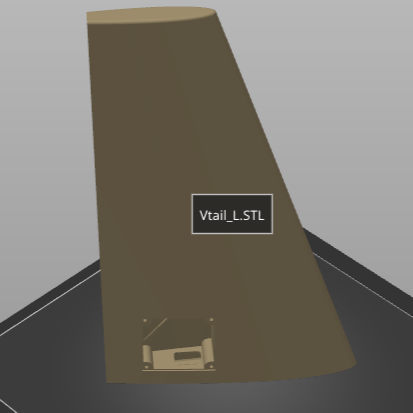
Images/Print Orientations/Vtail_L.png
