metinoxy/VTOL/Images/Print Orientations/Vtail_L_ServoCap.png

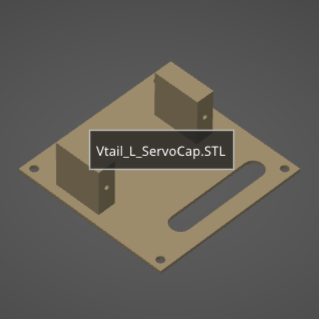
Images/Print Orientations/Vtail_L_ServoCap.png
