metinoxy/VTOL/Images/Print Orientations/Vtail_Mid.png

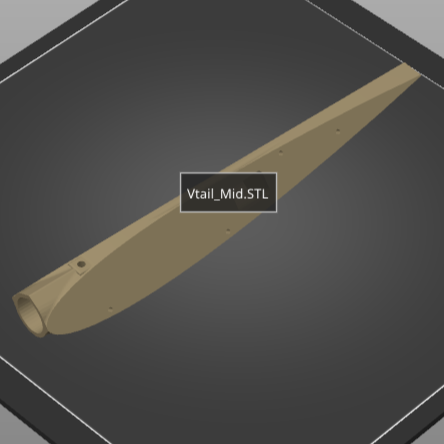
Images/Print Orientations/Vtail_Mid.png
