metinoxy/VTOL/Images/Print Orientations/Wing_L_Ailerons.png

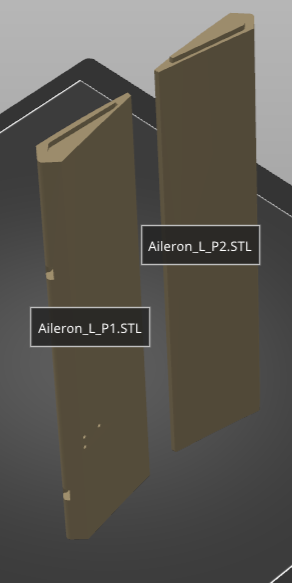
Images/Print Orientations/Wing_L_Ailerons.png
