metinoxy/VTOL/Images/Print Orientations/Wing_L_P2.png

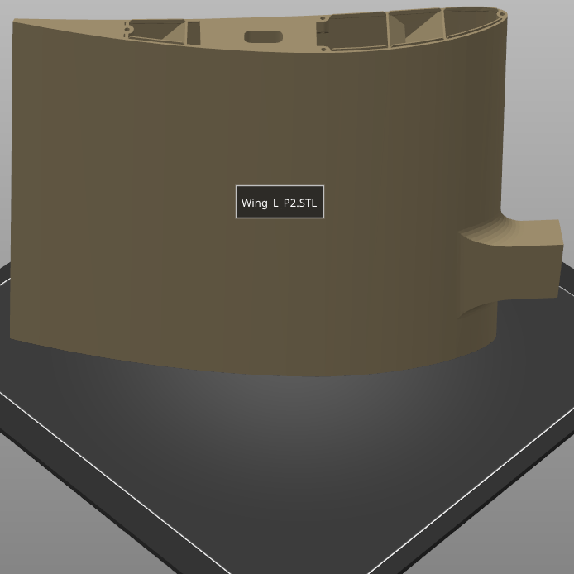
Images/Print Orientations/Wing_L_P2.png
