metinoxy/VTOL/Images/Print Orientations/Wing_L_P3.png

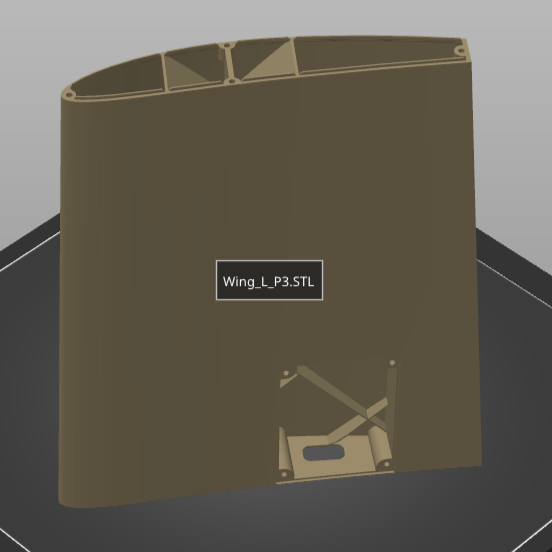
Images/Print Orientations/Wing_L_P3.png
