metinoxy/VTOL/Images/Print Orientations/Wing_L_P4.png

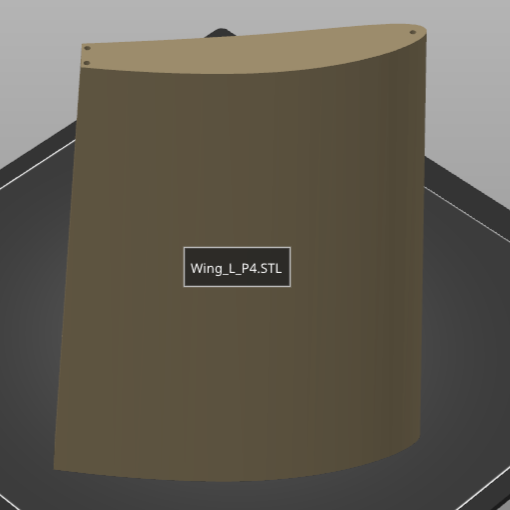
Images/Print Orientations/Wing_L_P4.png
