metinoxy/VTOL/Images/Print Orientations/Wing_L_ServoCap.png

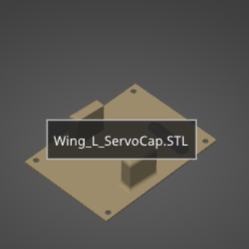
Images/Print Orientations/Wing_L_ServoCap.png
