metinoxy/VTOL/Images/Print Orientations/Wing_L_Winglet.png

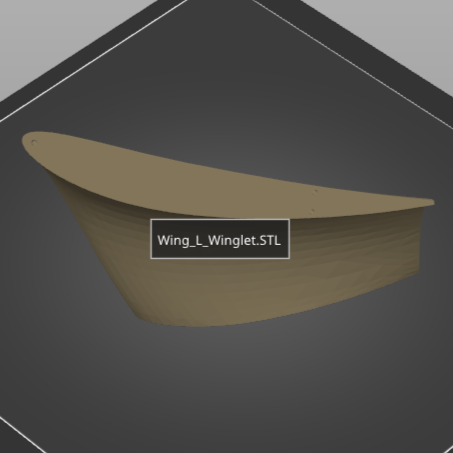
Images/Print Orientations/Wing_L_Winglet.png
