metinoxy/VTOL/Images/Print_Orientation.png

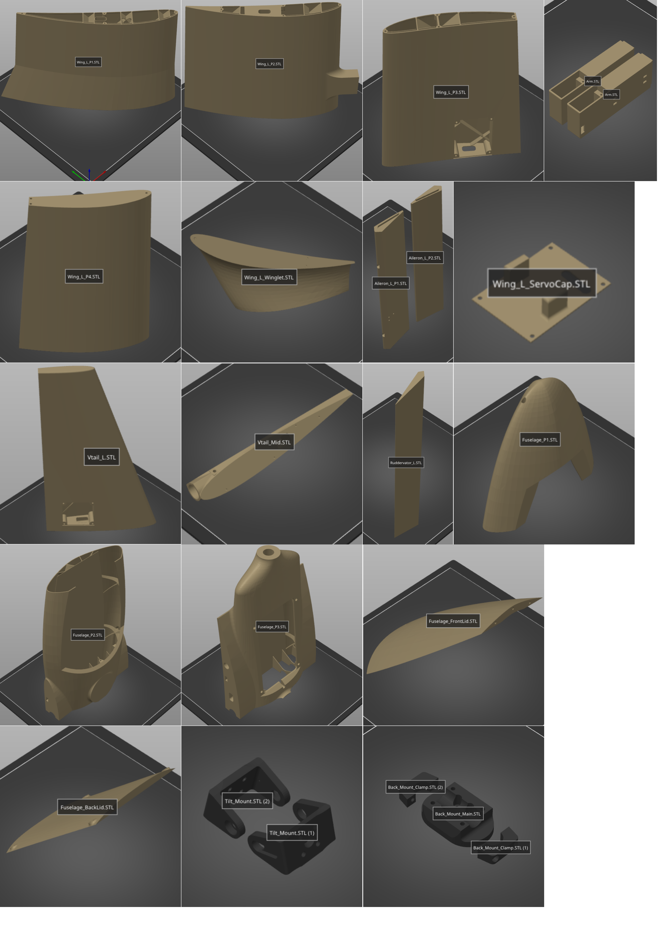
Images/Print_Orientation.png
