metinoxy/VTOL/Course Materials/Concept Evaluation.pdf

Criteria | Weighting | Concept 1 | Concept 2 | Concept 3
Maintenance Size-Restriction Weight Control Stability Aesthetic Material Cost Manufacturability Reliability Noise Unusable-Rotor Transition Capability Hover Efficiency | 0.045 0.015 0.106 0.167 0.091 0.076 0.136 0.152 0.000 0.061 0.030 0.121 | 70 60 60 70 80 75 65 50 40 60 60 70 | 80 50 40 80 50 70 55 60 30 30 60 80 | 50 70 40 30 60 80 50 30 50 90 30 60
Total Score: | | 65.45 | 61.74 | 49.09
