metinoxy/VTOL/XFLR5/Sim Results/Lateral Modes/Lateral_mode3.PNG

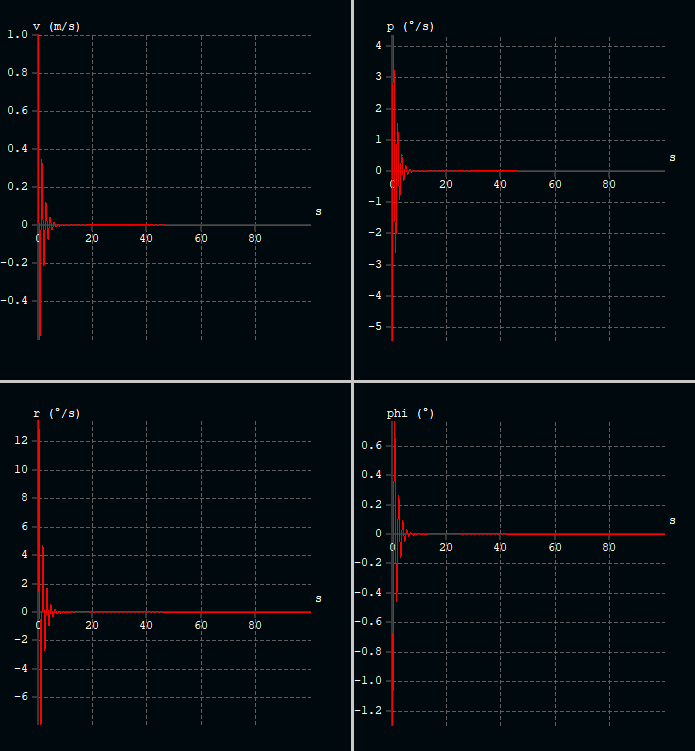
XFLR5/Sim Results/Lateral Modes/Lateral_mode3.PNG
