metinoxy/VTOL/XFLR5/Sim Results/Lateral Modes/Lateral_mode4.PNG

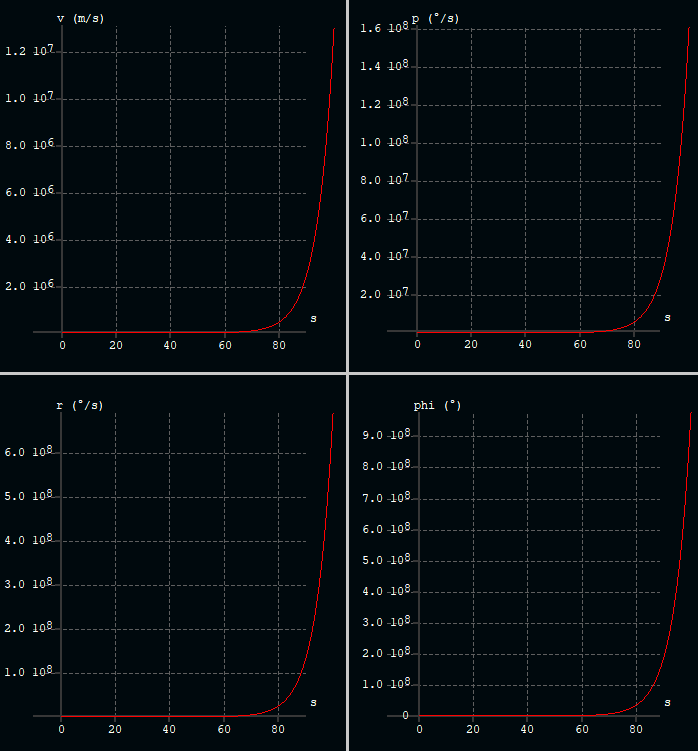
XFLR5/Sim Results/Lateral Modes/Lateral_mode4.PNG
