metinoxy/VTOL/XFLR5/Sim Results/Longitudinal Modes/Longitudinal_mode1.PNG

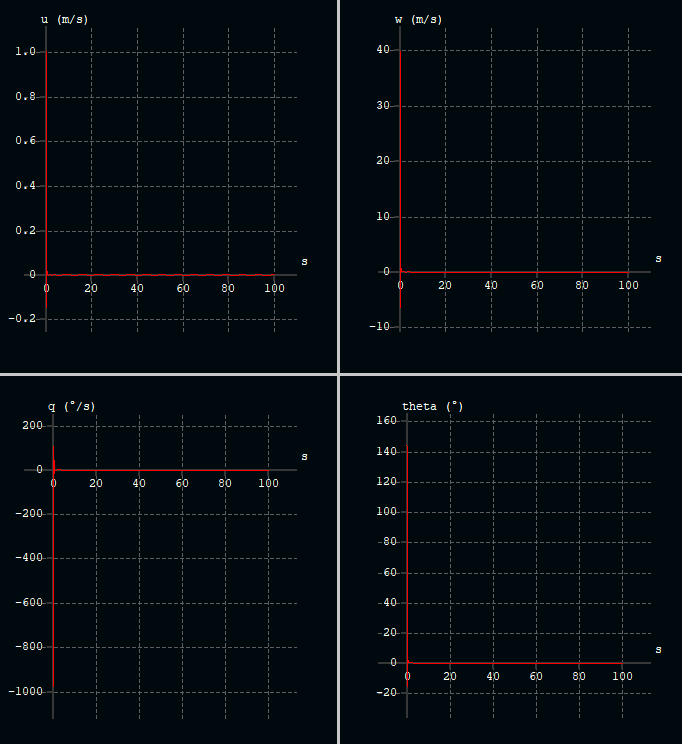
XFLR5/Sim Results/Longitudinal Modes/Longitudinal_mode1.PNG
