metinoxy/VTOL/XFLR5/Sim Results/Wing.jpg

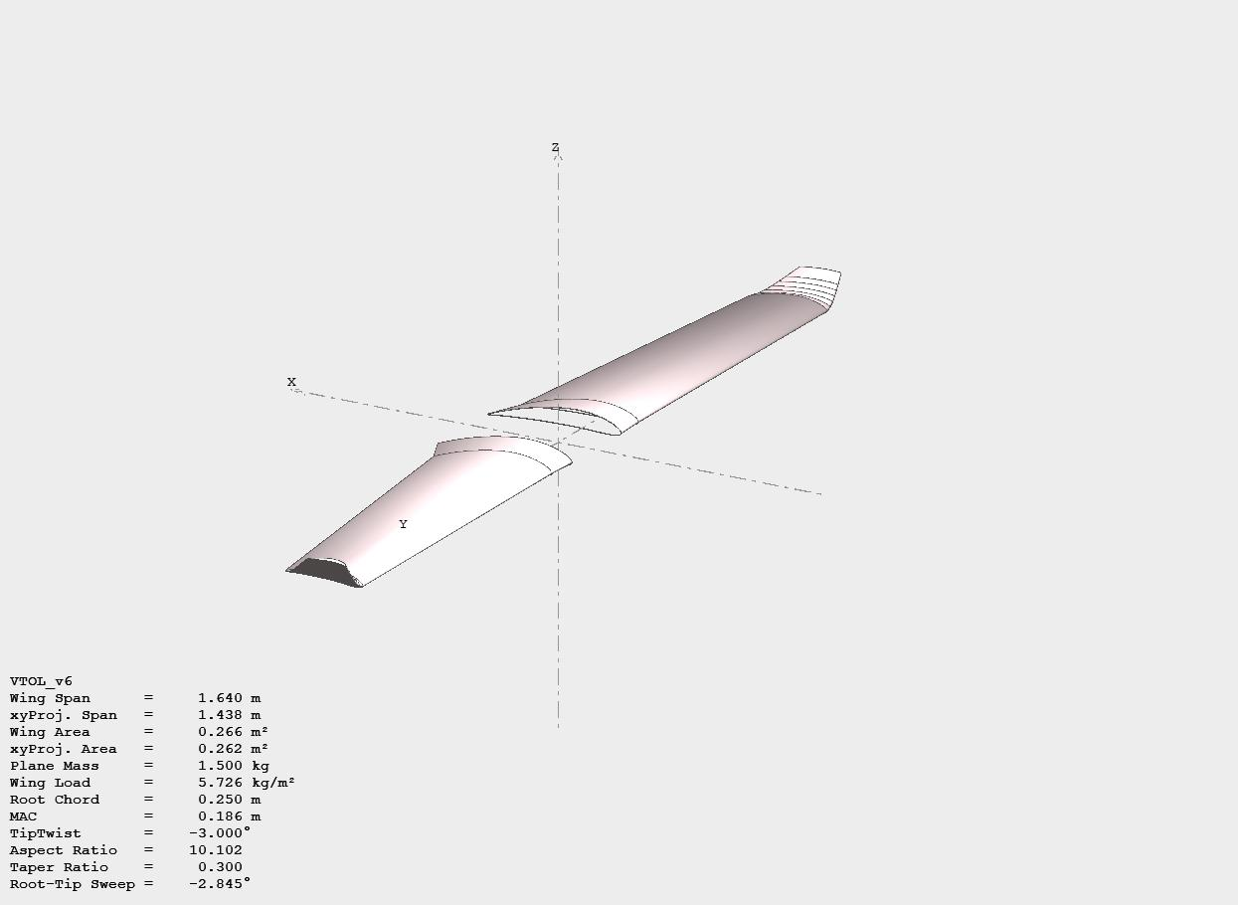
XFLR5/Sim Results/Wing.jpg
