metinoxy/VTOL/Course Materials/PDS_Wheel_Chard.pdf

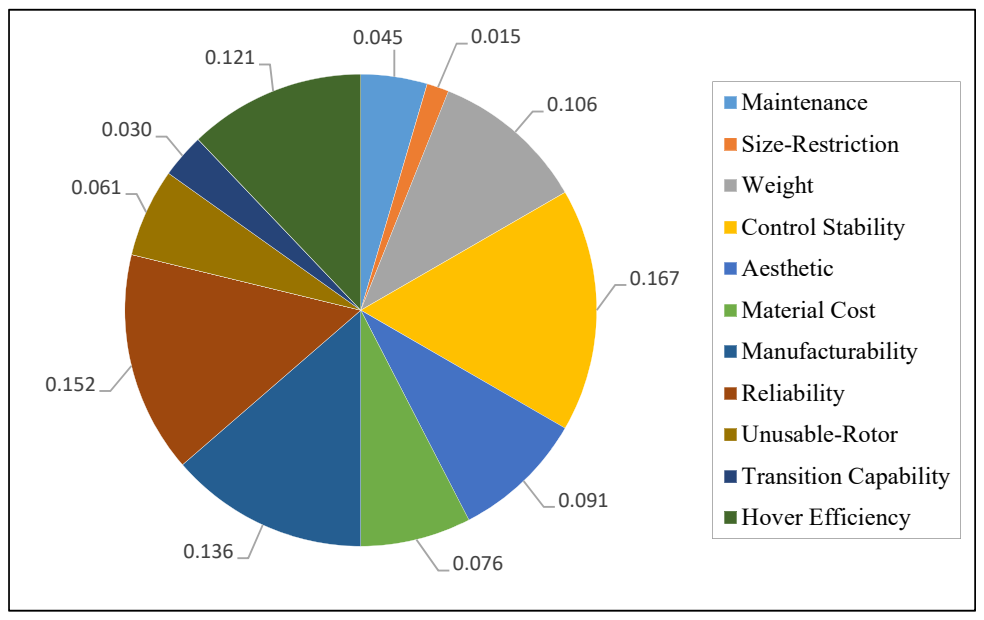
[picture p267: page 1]
Maintenance; Size-Restriction; Weight; Control Stability; Aesthetic; Material Cost; Manufacturability; Reliability; Unusable-Rotor; Transition Capability; Hover Efficiency
