metinoxy/VTOL/Course Materials/Binary Dominance Matrice.pdf

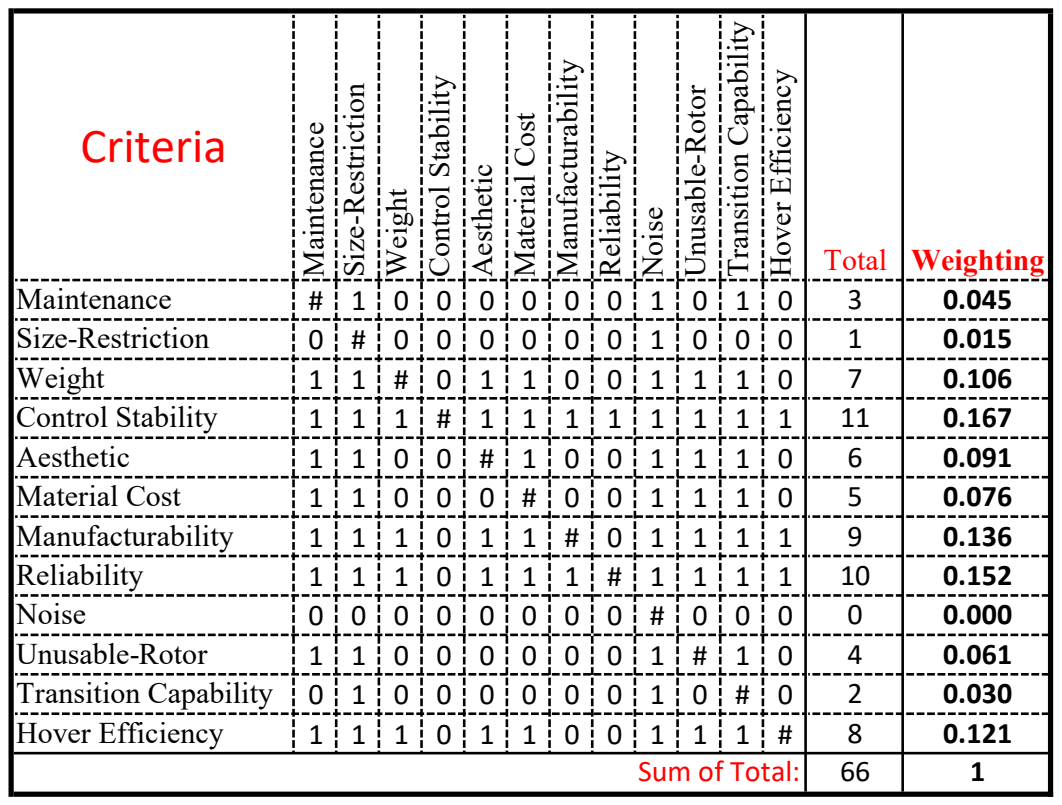
[picture p268: page 1]
Criteria Maintenance Size⁻Restriction Weight Control Stability Aesthetic Material Cost Manufacturability Reliability Noise Unusable⁻Rotor Transition Capability Hover Efficiency; Total Weighting; Maintenance; Size-Restriction; Weight; Control Stability; Aesthetic; Material Cost; Manufacturability; Reliability; Noise; Unusable-Rotor; Transition Capability 0 1 0 0 0 0 0 0 1 0 # 0; Hover Efficiency; Sum of Total: 66
