metinoxy/VTOL/(commit log)

2024-11-13 Inıtıal folders, files and docs are added.
    [BinaryDom-ConceptEva.xlsx, Gantt Chard.xlsx, stallion-vtol.SLDPRT]
2024-11-14 The Wing is designed roughly in SolidWorks.
    [Wing_v1.SLDPRT]
2024-11-15 Wing sheel design and rib construction
    [Wing_v1.SLDPRT]
2024-11-15 Gantt Chard is updated.
    [Gantt Chard.xlsx]
2024-11-15 Rough Fuselage design is added.
    [Fuselage_v1.SLDPRT]
2024-11-18 Fuselage internal structure is modified.
    [Gantt Chard.xlsx, Wing_v1.SLDPRT]
2024-11-19 Fuselage and wing is updated and motage is generated.
    [Montage_v1.SLDASM, Wing_v1.SLDPRT]
2024-11-19 Powerpoint is uploaded
2024-11-21 powerpoint is updated
2024-11-22 Numerical Deflection is added
    [BM.xlsx]
2024-11-28 Report draft and format materials added.
2024-11-29 Delete Course Materials/~$nal Report.docx
    some mistake...
2024-11-30 V_tail is uploaded
    [V_tail.SLDPRT]
2024-11-30 V-Tail is uploaded
    [Son_V_Tail_yedek.SLDPRT, V_tail.SLDPRT]
2024-12-01 Wing Structural analysis is performed.
    [Wing_analysis.SLDPRT]
2024-12-03 Structural anaysis results are attached.
    [Wing_analysis.SLDPRT]
2024-12-03 Vtail is finalized
    [Son_V_Tail_yedek.SLDPRT, Vtail.SLDPRT]
2024-12-05 Some visual materials, graphs and fbd's are prepared, and report is updated with tail design section.
    [Wing_v1.SLDDRW]
2024-12-05 Report updated. Again :(
    [CFRP_Tube_12-10-500.SLDPRT, Montage_v1.SLDASM, V-Tail_v2.SLDDRW, Vtail.SLDPRT, Vtail_v2.SLDPRT, Wing_v1.SLDDRW]
2024-12-17 Some changes is performed.
    [CFRP_Tube_12-10-500.SLDPRT, Fuselage_v0_cfd.SLDPRT, Inertia Wing.SLDPRT, Montage_v1.SLDASM, Vtail_v0_cfd.SLDPRT, Vtail_v2.SLDPRT, Wing_analysis.SLDPRT, Wing_v0_cfd.SLDPRT]
2024-12-17 Fuselage is shortened and changed the version of it.
2024-12-17 Back Vertical Flight Motor Mount is designed
    [Back_Mount_v1.SLDPRT]
2024-12-17 tilting arm is updated on wing
    [CFRP_Tube_12-10-500.SLDPRT, Montage_v1.SLDASM]
2024-12-17 Tilting mechanism is uploaded
    [BEARING.sldprt, ES09MD.SLDPRT, ES09MD_shaft.SLDPRT, ISO 7045 - M3 x 16 - Z - 16C.SLDPRT, MAGNETS ADHESIVE.SLDPRT, MAGNETS.SLDPRT, MOTOR WIRES.SLDPRT, Part4.SLDPRT]
2024-12-17 the montage is finalized and its photos are uploaded
    [Back_Mount_v1.SLDPRT, Part4.SLDPRT]
2024-12-30 Technical Draving of assembly is added.
    [Back_Mount_v1.SLDPRT, Part4.SLDPRT, Wing_v1.SLDDRW]
2025-01-02 Gantt chars are updated and desgin path is added.
    [Gantt Chard.xlsx, Gantt Chard_Design.xlsx, Gantt Chard_Production.xlsx]
2025-01-02 Report Updated.
    [Gantt Chard_Production.xlsx]
2025-01-04 Technical Drawings are updated and Technical drawing of TiltMechanism is generated.
    [Wing_v2.SLDDRW]
2025-01-04 Visual Materials for section 2.2 and 2.1 are prepared and added to report.
    [BinaryDom-ConceptEva.xlsx]
2025-01-05 Report format update, New Appendix added (Rear motor mount).
    [Back_Mount_v1.SLDPRT, Rear_Motor_Mount_v1.SLDDRW]
2025-01-08 Report 2.2 is finalised.
    [BinaryDom-ConceptEva.xlsx]
2025-01-08 Render of the aircraft and Report Format Updated.
    [CFRP_Tube_12-10-500.SLDPRT, Part3.SLDPRT]
2025-02-22 Ghant chard is updated.
    [Gantt Chard_Production.xlsx]
2025-02-22 Cost Analysis is added.
    [Cost Analysis.xlsx]
2025-02-24 Rough Aileron design is conducted.
    [Aileron.SLDPRT]
2025-03-01 Wing Servo holders cutted.
    [Cost Analysis.xlsx, Wing_Servo_Cap_v1.SLDPRT]
2025-03-04 Gantt Chard has been updated.
    [Gantt Chard_Production.xlsx]
2025-03-05 Vtail is updated in a new file
    [Vtail.SLDPRT]
2025-03-07 Wing Cut is almost finished. (Aileron hinges and winglet connection is remained.)
    [Aileron.SLDPRT, SG90 - Micro Servo 9g - Tower Pro.2.SLDPRT, Servo_Cap_Montage.SLDASM, Servo_MG90S.SLDPRT, Wing_Servo_Cap_v1.SLDPRT]
2025-03-07 Control Surface Area is marked in the sketch.
    [Vtail.SLDPRT]
2025-03-08 Wings are finalised and STL flies are generated
    [Aileron.SLDPRT, Aileron_Hinge.SLDPRT, Control_Horn.SLDPRT, Servo_Cap_Montage.SLDASM, Wing_P1_L.STL, Wing_P2_L.STL, Wing_P3_L.STL, Wing_P4_L.STL]
2025-03-09 Gantt Chard dates added
    [Gantt Chard_Production_V2.xlsx]
2025-03-09 control surfaces excel added (updated)
    [control_surfaces.xlsx]
2025-03-11 Fusalage cut version added.
2025-03-13 mentese is uploaded
    [mentese.SLDASM, mentese.SLDPRT]
2025-03-17 Fuselage covers are desiged.
    [Cost Analysis.xlsx]
2025-03-22 Pitot tube drawing added.
    [Pitotube.SLDPRT]
2025-03-22 Pitot tube hole opened.
2025-03-30 Small Changes.
    [Wing_Servo_Cap_v1.SLDPRT]
2025-03-31 Electronics added.
    [Battery.SLDPRT, Canopi_Lock.SLDPRT, MiddlePipe.SLDPRT, Pitotube.SLDPRT, PowerModule.SLDPRT, pixhawk.SLDPRT]
2025-04-29 v-tail is updated
    [Vtail_2.SLDPRT]
2025-05-07 Ben bir şeyler yaptım ama ne yaptım bilmiyorum çok yapmışım
    [Arm.SLDPRT, BEARING.sldprt, ES09MD.SLDPRT, ES09MD_ARM.SLDPRT, ES09MD_shaft.SLDPRT, MAGNETS ADHESIVE.SLDPRT, MAGNETS.SLDPRT, Mount_Part.SLDPRT]
2025-05-08 assembly images added.
    [Cost Analysis.xlsx, Gantt Chard_Production_V2.xlsx]
2025-05-30 492 Final report and some visual materials are added.
2025-06-02 the parts are revised for the new dc motors
    [Back_Mount_v1.SLDPRT, Mount_Part.SLDPRT]
2025-06-06 Introduction to printer part added.
2025-06-06 STL files are added and file organisations
    [Aileron.SLDPRT, Aileron_Hinge.SLDPRT, Aileron_L_P1.STL, Aileron_L_P2.STL, Arm.STL, BEARING.sldprt, Back_Mount_Clamp.STL, Back_Mount_Main.STL]
2025-06-06 More STL and print times orientation of them
    [Fuselage_BackLid.STL, Fuselage_FrontLid.STL, Fuselage_P1.STL, Fuselage_P2.STL, Fuselage_P3.STL]
2025-06-08 Project management added
    [Gantt Chard_Production_V2.xlsx]
2025-06-09 selection of materials is added
2025-06-09 Technical drawings are updated.
    [AynalamaArm.SLDPRT, AynalamaCS_Hinge.SLDPRT, AynalamaControl_Horn.SLDPRT, AynalamaES09MD.SLDPRT, AynalamaES09MD_ARM.SLDPRT, AynalamaSG90 - Micro Servo 9g - Tower Pro.2.SLDPRT, AynalamaServo_MG90S.SLDPRT, AynalamaTilt_Montage_v2.SLDASM]
2025-06-11 vtail is updated and technical drawing is added
    [Vtail_v4.SLDPRT]
